cakmacbum/bas-ncl-kap/24.09.2026.md

# 24.09.2026 — Çok elemanlı kap doğrulama devamı

## Tamamlananlar

- Önceki dört iş paketi korunarak mevcut çalışma ağacı gözden geçirildi.
- Beş bileşenli proje API kaydet/aç turu, UI listele/yükle bağlantısı, iki malzeme/iki kaynak fixture'ı, CAD kapsam kapısı ve Faz E kalıcılık/rapor kontrolleri doğrulandı.
- Golden-case regresyonu, F&D standart varsayımının taç/büküm yarıçapını dış çaptan türetmesiyle hizalandı. 20 mm nominal etli ve 1000 mm iç çaplı test girdisinde beklenen büküm yarıçapı 62.4 mm'dir.
- `Junction.cone_end` alanı arayüz TypeScript tip sözleşmesine eklendi.
- Tam Python paketi: **679 geçti, 1 atlandı**. Atlanan test isteğe bağlı WeasyPrint PDF testidir.
- Web üretim derlemesi başarılı; son tip sözleşmesi düzenlemesinden sonra `tsc -b` de başarılı.
- `git diff --check` temiz.

## Kapsam sınırları

- WeasyPrint bulunmadığından PDF çıktısı testi bu ortamda çalışmadı.
- Koni birleşimlerinde doğrulama ve kapsam kapısı vardır; birleşim hesap çözücüsü desteklenmeyen durumları sayısal sonuç olarak üretmez.
- Kesin CAD yalnızca desteklenen dar zincir geometrisini işler; beş bileşenli zincir `OUT_OF_SCOPE` olarak kalır.
- Çalışma ağacındaki değişiklikler commit edilmedi; hiçbir değişiklik geri alınmadı.
