cakmacbum/bas-ncl-kap/.project-ai/FUTURE.md

# FUTURE (Scope Guard — NOT NOW)
- Bombe nozulları, eğik/ofset nozul, koni, çoklu gövde, destek tanıma
- STL'den ölçü çıkarma / yüklenen STL ile suite modelini üst üste karşılaştırma (sapma haritası)
- IGES desteği
- Kalıcı tanıma worker havuzu (+5 s import gecikmesini kaldırır)
- B-36: vessel_builder'da gerçek küre+torus torisferik profil
- Global 500 işleyicisinde ayrıntı gizleme
- EN 13445 flanş, yorulma, yük kombinasyonu (D5 sonrası) · CFD (OpenFOAM, sunucu maliyeti) · rüzgâr/deprem (Dalga 5) · P14 3D CalculiX (ertelendi)
