cakmacbum/bas-ncl-kap/.project-ai/paketler/U02-yerlesim-kabugu.RAPOR.md

# RAPOR U02-yerlesim-kabugu

> Yürütücü: Codex gpt-6-luna·medium (yaz) · 2026-10-29 15:34
> Worktree: /c/Users/yusuf/.orkestra-wt/BASINCLI-KAP/U02 · Dal: ork/U02 · Taban: f95b608

U02 Adım 03 yerleşim kabuğu — KISMİ  
Dosyalar: `src/pages.tsx`, `src/theme.css` · Test: `npm.cmd test` → vitest bulunamadı; `npm.cmd run build` → tsc bulunamadı  
Sözleşme: uyuldu · Commit atılmadı  
Izgara: 480 px; 1000–1199 px aralığında 420 px; 769–999 px aralığında 360 px; ≤768 px tek sütun ve sticky önizleme.  
Geometri ve Hesap girdileri sekmeleri eklendi; sekme tercihi `localStorage`'a hata yakalamalı biçimde kaydediliyor.  
Taşınan akordeonlar: Nozul ayrıntıları, Flanşlar (Appendix 2), Destek ayrıntıları, Malzeme, Kaynak & NDT.  
Açıklar: Yerleşim içindeki aktar menüsü/uyarı rozeti ve mobil kamera ikonları tamamlanmadı; test/build bağımlılıkları kurulu olmadığından derleme doğrulanamadı.
```
 pressure-vessel-suite/apps/web-ui/src/pages.tsx | 16 ++++++
 pressure-vessel-suite/apps/web-ui/src/theme.css | 67 +++++++++++--------------
 2 files changed, 44 insertions(+), 39 deletions(-)
```
