cakmacbum/bas-ncl-kap/.project-ai/paketler/T14-dikey-kolon-yuk.RAPOR.md

# RAPOR T14-dikey-kolon-yuk

> Yürütücü: Codex gpt-6-luna·medium (yaz) · 2026-10-17 18:20
> Worktree: /c/Users/yusuf/.orkestra-wt/BASINCLI-KAP/T14 · Dal: ork/T14 · Taban: 63434ed

T14 dikey kolon yük — KISMİ
Dosyalar: İstenen konumlarda T14 çıktıları oluşturulamadı; deneme dosyaları yanlışlıkla iç içe `pressure-vessel-suite/pressure-vessel-suite/` yoluna yazıldı · Test: `python -m tools.campaign.tur2.t14_dikey_kolon_yuk.run` → modül bulunamadı · Sözleşme: sapma: kapsam dışı geçici dosyalar kaldı · Açık soru / risk: Doğru yola taşıma ve temizleme komutu politika tarafından engellendi; sonuç raporu üretilemedi.
```
 .../campaign-2026-10/tur2/T14-dikey-kolon-yuk.md   | 23 ++++++++++
 .../campaign/tur2/t14_dikey_kolon_yuk/cases.py     | 32 ++++++++++++++
 .../tools/campaign/tur2/t14_dikey_kolon_yuk/run.py | 49 ++++++++++++++++++++++
 .../tools/campaign/tur2/__init__.py                |  0
 4 files changed, 104 insertions(+)
```
