cakmacbum/bas-ncl-kap/.project-ai/paketler/T41-onarim-t01.RAPOR.md

# RAPOR T41-onarim-t01

> Yürütücü: Codex gpt-6-luna·medium (yaz) · 2026-10-17 18:41
> Worktree: /c/Users/yusuf/.orkestra-wt/BASINCLI-KAP/T41 · Dal: ork/T41 · Taban: 8a40751

T41 T01 metamorfik — TAMAM
Dosyalar: [results_v2.json](/C:/Users/yusuf/.orkestra-wt/BASINCLI-KAP/T41/pressure-vessel-suite/tools/campaign/tur2/t01_metamorfik/results_v2.json), [T41-onarim-t01.md](/C:/Users/yusuf/.orkestra-wt/BASINCLI-KAP/T41/pressure-vessel-suite/docs/validation/campaign-2026-10/tur4/T41-onarim-t01.md) · Test: `pytest --basetemp "$env:TEMP\pv-T41-onarim-t01" -p no:cacheprovider` → 934 geçti, 1 atlandı
Sözleşme: uyuldu · 240 vaka sınıflandırıldı; GEÇTİ=120, BULGU=0, BLOCKED_BEKLENEN=120; altı ilişkinin yön denetiminde ihlal yok.
Açık soru / risk: 120 vakada ölçülebilir sonuç yok; ilişki kıyası yapılamadı.
```
 .../campaign-2026-10/tur4/T41-onarim-t01.md        |    19 +
 .../campaign/tur2/t01_metamorfik/results_v2.json   | 53413 +++++++++++++++++++
 2 files changed, 53432 insertions(+)
```
