cakmacbum/bas-ncl-kap/.project-ai/paketler/T40-onarim-agregasyon.RAPOR.md

# RAPOR T40-onarim-agregasyon

> Yürütücü: Codex gpt-6-luna·medium (yaz) · 2026-10-17 18:29
> Worktree: /c/Users/yusuf/.orkestra-wt/BASINCLI-KAP/T40 · Dal: ork/T40 · Taban: eb9fc3f

T40 onarım agregasyon — KISMİ  
Dosyalar: [T40-onarim-agregasyon.md](/C:/Users/yusuf/.orkestra-wt/BASINCLI-KAP/T40/pressure-vessel-suite/docs/validation/campaign-2026-10/tur4/T40-onarim-agregasyon.md) · Test: dört `python -m tools.campaign.tur3.mega_*.run` koşusu → modüller worktree’de bulunmadığından çalıştırılamadı · Sözleşme: uyuldu · Açık soru / risk: `results.json` kaynakları yok; dağılım ve kontrol örnekleri hesaplanamadı.
```
 .../validation/campaign-2026-10/tur4/T40-onarim-agregasyon.md    | 9 +++++++++
 1 file changed, 9 insertions(+)
```
