cakmacbum/bas-ncl-kap/.project-ai/paketler/V01-teyit-govde_ug27.RAPOR.md

# RAPOR V01-teyit-govde_ug27

> Yürütücü: Codex gpt-6-luna·medium (yaz) · 2026-10-17 18:10
> Worktree: /c/Users/yusuf/.orkestra-wt/BASINCLI-KAP/V01 · Dal: ork/V01 · Taban: fe21b34

V01 f01_govde_ug27 — TAMAM
Dosyalar: [V01-f01_govde_ug27.md](/C:/Users/yusuf/.orkestra-wt/BASINCLI-KAP/V01/pressure-vessel-suite/docs/validation/campaign-2026-10/teyit/V01-f01_govde_ug27.md) · Test: bağımsız Python aritmetik kontrolü → tamam · Sözleşme: uyuldu · Açık soru / risk: yok
```
 .../campaign-2026-10/teyit/V01-f01_govde_ug27.md   | 35 ++++++++++++++++++++++
 1 file changed, 35 insertions(+)
```
