cakmacbum/bas-ncl-kap/.project-ai/paketler/V02-teyit-bombe_eliptik.RAPOR.md

# RAPOR V02-teyit-bombe_eliptik

> Yürütücü: Codex gpt-6-luna·medium (yaz) · 2026-10-17 18:05
> Worktree: /c/Users/yusuf/.orkestra-wt/BASINCLI-KAP/V02 · Dal: ork/V02 · Taban: 2012cb4

V02 f02_bombe_eliptik — TAMAM  
Dosyalar: [V02-f02_bombe_eliptik.md](/C:/Users/yusuf/.orkestra-wt/BASINCLI-KAP/V02/pressure-vessel-suite/docs/validation/campaign-2026-10/teyit/V02-f02_bombe_eliptik.md) · Test: çalıştırılmadı → belge ve kod satırları incelendi · Sözleşme: uyuldu · Açık soru / risk: Suite ve oracle arasındaki sayısal fark, yalnız korozyonlu çap etkisiyle tam açıklanmıyor; raporda bu belirsizlik belirtildi.
```
 .../teyit/V02-f02_bombe_eliptik.md                 | 25 ++++++++++++++++++++++
 1 file changed, 25 insertions(+)
```
