cakmacbum/bas-ncl-kap/.project-ai/paketler/V04-teyit-bombe_yarimkure.RAPOR.md

# RAPOR V04-teyit-bombe_yarimkure

> Yürütücü: Codex gpt-6-luna·medium (yaz) · 2026-10-17 18:05
> Worktree: /c/Users/yusuf/.orkestra-wt/BASINCLI-KAP/V04 · Dal: ork/V04 · Taban: 2012cb4

V04 f04_bombe_yarimkure — KISMİ
Dosyalar: [V04-f04_bombe_yarimkure.md](/C:/Users/yusuf/.orkestra-wt/BASINCLI-KAP/V04/pressure-vessel-suite/docs/validation/campaign-2026-10/teyit/V04-f04_bombe_yarimkure.md) · Test: el hesabı → 2 temsilci hesaplandı; test komutu yok
Sözleşme: uyuldu · Açık soru / risk: Dosyadaki grup tablosu ile sonuç özeti çelişiyor; düzeltilmeli.
```
 .../teyit/V04-f04_bombe_yarimkure.md               | 33 ++++++++++++++++++++++
 1 file changed, 33 insertions(+)
```
