cakmacbum/bas-ncl-kap/.project-ai/paketler/V05-teyit-duz_kapak_ug34.RAPOR.md

# RAPOR V05-teyit-duz_kapak_ug34

> Yürütücü: Codex gpt-6-luna·medium (yaz) · 2026-10-17 18:05
> Worktree: /c/Users/yusuf/.orkestra-wt/BASINCLI-KAP/V05 · Dal: ork/V05 · Taban: 2012cb4

V05 düz kapak UG-34 — KISMİ  
Dosyalar: [V05-f05_duz_kapak_ug34.md](/C:/Users/yusuf/.orkestra-wt/BASINCLI-KAP/V05/pressure-vessel-suite/docs/validation/campaign-2026-10/teyit/V05-f05_duz_kapak_ug34.md) · Test: yok (yalnız rapor ve elle hesap) → çalıştırılmadı · Sözleşme: uyuldu · Açık soru / risk: Suite kaynak kanıtı görülen Head dalıyla sınırlı; kampanya girdilerinin o dala eşlemesi doğrulanamadı. Rapor içinde bu kanıt sınırı belirtildi.
```
 .../teyit/V05-f05_duz_kapak_ug34.md                | 31 ++++++++++++++++++++++
 1 file changed, 31 insertions(+)
```
