cakmacbum/bas-ncl-kap/30.09.2026-notlar.md

# 30.09.2026 — Kaldığımız yer

## Güncel durum (30.09 kontrolü)

- **Testler:** 867 passed / 1 skipped (atlanan: WeasyPrint PDF). `tsc --noEmit` 0 hata, kullanılmayan TS öğesi 0, `npm run build` başarılı.
- **26.09'dan beri kodda değişiklik yok.** Son iş 26.09'daki destek denetimi ve ayak sistemiydi.
- **Commit yok:** son commit `6b0f7b6` (24.09, geometri ajanı). O günden beri yapılan her şey çalışma ağacında duruyor. 35 değiştirilmiş dosya ve 9 yeni dosya var. Yeni dosyaların önemlileri:
  - `packages/supports/src/supports/leg_detail.py`
  - `tests/faz5/test_leg_detail.py`, `test_saddle_zick.py`, `test_skirt_buckling.py`, `test_support_orchestration.py`, `test_flange_production_wiring.py`
  - `tests/faz_e/test_faz_e_release_gate.py`
  - `docs/validation/2026-09-26-20-tank-basinc-ayak-karsilastirmasi.md`, `test-sonuc.1.md`

  Bunlar kaybolmasın diye **ilk iş checkpoint commit** atmak.
- **Kayıtlar:** `docs/limitations.md` (Revizyon 3.5, B-26…B-38) ve vault (`basincli-kap-denetim-dogrulama`) güncel.

## 22–26.09 arasında yapılanlar (özet)

### Emniyet düzeltmeleri (hepsi testli)
| Kod | Konu |
|---|---|
| B-26 | Mill toleransı korozyon payına uygulanmıyordu |
| B-27 | Ayak kesiti dolu daire kabul ediliyordu |
| B-28 | Hidrotest/pnömatik test basıncı LSR=1 ile düşük çıkıyordu → malzemeye "Test sıcaklığında S" alanı |
| B-29 | WRC'de eksik katsayı sıfır sayılıyordu |
| B-30 | Eğik nozulda sahte GEÇTİ → İNCELEME GEREKLİ |
| B-31 | Malzeme S sıcaklığı / kalınlık aralığı kontrol edilmiyordu |
| B-32 | Ayak reaksiyonunda moment terimi yarıydı → `2M/(n·r)` |
| B-33 | Taban plakası alanı ayak çelik gerilmesini düşürüyordu |
| B-34 | Etek/ayak arayüzden hesaplanamıyordu (host bombe sorunu) |
| B-35 | Alternatif yük durumları toplanıyordu → zarf |
| B-36 | Destek ağırlığında hidrotest (su) yoktu |
| B-37 | Etek burkulma kontrolü yoktu → B faktörü kullanıcı girdisi |
| B-38 | Eyer formülleri Zick değildi → Zick yapısı, K katsayıları kullanıcı girdisi |

### Yeni özellikler
- **Flanş (Appendix 2) uçtan uca:** Y, f, F, V, T, U, W, M, g1 kullanıcı girdisi. Gerilme formülleri standart forma düzeltildi. Sonuç İNCELEME GEREKLİ (rijitlik, cıvata alanı kontrolleri yok).
- **Ayak sistemi:** boru/U/kutu/köşebent kesit + AISC burkulma, ped, taban plakası, üç köşe kaynağı, WRC lokal gerilme. Dört ayrı sonuç ve arayüz formu (WRC tablosu, boş ile 0 ayrımı). Özet sonuç nihai GEÇTİ vermez.
- **Yayın kapısı:** `CalculationResult.notices`; `validate_suite` API yanıtında `verification` olarak (arayüzde henüz gösterilmiyor).
- **Arayüz:** siyah/beyaz keskin tema, Inter + JetBrains Mono.
- **Dokümanlar:** `calculation-coverage.md` dört etiketle yeniden yazıldı.

## Açık kararlar (Yusuf)

1. **MAWP farkı** (`test-sonuc.1.md`, 20 tank): program MAWP'si dış hesaptan %18–77 yüksek.
   - Bombe MAWP'si şekillendirme incelmesini (1 mm) düşmüyor. Bu gerçek tutarsızlık; düzeltme onayı bekliyor.
   - Dış hesap %12,5 sac toleransını MAWP'ye uyguluyor. Levha için (tipik 0,25 mm) fazla temkinli olabilir. Karar: MAWP en kötü tolerans kalınlığıyla mı hesaplansın?
2. **Ayak ped temas oranı yorumu:** şu an "kaynaklanabilen kontur oranı" olarak ele alınıyor. Mühendis onayı gerekiyor.
3. **Repodaki STL dosyaları:** `deneme-tasarimi.stl` ve `../pressure_vessel_u_profile_legs_concept_mm.stl`. Silinsin mi, git dışına mı alınsın?

## Yapılacaklar (öncelik sırasıyla)

1. **Checkpoint commit.** Tüm çalışma ağacı dört gündür commit edilmedi.
2. **Backend'i yeniden başlat.** 8000'deki backend eski kodla ve `.env`'siz çalışıyor, bu yüzden yeni ayak kontrolleri ve geometri ajanı görünmüyor:
   ```
   python -m uvicorn apps.api.main:app --reload --env-file .env
   ```
   Frontend: `pressure-vessel-suite\apps\web-ui` klasöründe `npm run dev` (kökten çalışmaz).
3. **MAWP bombe incelmesi düzeltmesi** (karar 1 sonrası).
4. **Doğrulanamayanları kaynakla kontrol et** (Moss PVDM veya Megyesy çözümlü örnek):
   - eyer S3/S5 formülleri ve K1' (basma tarafı) ayrımı
   - etek 0,6 kaynak verimi ve UG-23(b) Ro/t – ortalama R/t seçimi
   - Blodgett kaynak grubu Sw ifadeleri (türetmeyle doğrulandı)
   - WRC boyut analizi (bültenle karşılaştırılmadı)
5. **Yük eşleşmesi:** hidrotest ağırlığı rüzgâr momentiyle aynı hesapta (muhafazakâr); gerçek yük durumu eşleştirmesi yok.
6. **Test gerilmesinin bileşen bazında sınır kontrolü** (UG-99(b)) yok.
7. **Arayüzde `verification` gösterimi:** `test_ui_parity` kaydı ya da görüntü eklenmeli.
8. **EN 13445:** hiçbir yayınlanmış vakayla karşılaştırılmadı; B-31 malzeme kapısı EN'de uygulanmıyor.
9. **Küçük eksikler:** `anchor_bolt_diameter_mm` hesapta kullanılmıyor; boş tank ayak gerilmesi ayrı sonuç olarak üretilmiyor.

## Kapsam dışı (bilinçli)

- **Eğik nozul yöntemi:** lisanslı UG-37 metni yok, İNCELEME GEREKLİ kalıyor.
- **Diğer:** rüzgâr/deprem kod yüklemesi, relief sizing, yorulma, gerçek FEA çözücü, PED/CE süreci, loose flanş, flanş rijitliği (2-14).

## Güvenlik notu

- OpenRouter anahtarı sohbette göründü, **yenilenmeli**.
- Anahtar yalnız `pressure-vessel-suite/.env` dosyasında duruyor; dosya git'te görünmüyor (gizli).
- Ücretsiz modeller (`google/gemma-4-31b-it:free`) yoğunluktan 429 veriyor. Sorun sürerse ücretli, ucuz bir model seç.
