cakmacbum/bas-ncl-kap/24.09.2026-muhendislik-hesap-karsilastirmasi.md

# 24.09.2026 — Mühendislik hesap kapsamı ve rakip kıyası

**İncelenen revizyon:** `feaccd2` — *Implement pressure vessel suite phases and validation*  
**İnceleme türü:** Kod yolu, girdiler, sonuç durumları, test kanıtı ve üretici/otorite dokümanları üzerinden masa başı mühendislik incelemesi.  
**Sınır:** Lisanslı ASME BPVC ve EN 13445 tam metinleri bu incelemede madde madde doğrulanmadı. Bu rapor uygunluk sertifikası veya bağımsız mühendis onayı değildir. Yazılım testleri formülün doğru standardı temsil ettiğini tek başına kanıtlamaz.

## Yönetici özeti

Kod tabanında doğru yönde önemli altyapı var: açık ASME/EN motor seçimi, temel gövde/bombe basınç formülleri, izlenebilir ara değerler, bileşen dizisi, statü kapıları ve hesap kayıt altyapısı. Son tam test turunda **679 test geçti, isteğe bağlı 1 PDF testi atlandı**. Bu, yazılım davranışının regresyon kontrolüdür; PV Elite/COMPRESS düzeyinde mühendislik eşdeğerliği anlamına gelmez.

Ürün bugün **ASME VIII-1 için dar kapsamlı ön boyutlandırma ve kod geliştirme prototipi** olarak değerlendirilmeli. İmalata esas tasarım, hidro/pnömatik test basıncı, eğik/büyük nozul, flanş, dış basınç, rüzgâr/deprem destek tasarımı ve PED/CE kararı için tek başına kullanıma hazır değil.

## Bulgular ve öncelik

| Öncelik | Alan | Mevcut gerçek davranış | Mühendislik riski / gereken iş |
|---|---|---|---|
| **P0** | Hidrostatik ve pnömatik test | ASME kodu `S_test = S_design` atıyor; test basıncını bu oranla hesaplayıp doğrudan `PASS` veriyor. Test sıcaklığındaki malzeme gerilmesi okunmuyor; basınç taşıyan bütün parçaların test gerilmesi ayrı ayrı kontrol edilmiyor. | Gerçek `S_test/S_design` oranı 1’den büyükse önerilen test basıncı gerekenden düşük kalabilir. “Konservatif” varsayım güvenli yönde olduğu kanıtlanmış değil. Test sıcaklığı verisi yoksa sonuç bloklanmalı veya inceleme gerektirmeli; her bileşen için test koşulu/stres kontrolü eklenmeli. Kanıt: `code-asme-viii-1/.../design_code.py`, `calculate_hydrotest_pressure` ve `calculate_pneumatic_test_pressure`.
| **P0** | Malzeme özelliklerinin geçerliliği | API’de malzeme kaydı varlığı kontrol ediliyor; ancak sıcaklık ve kalınlık aralığı, ürün formu ve kod sürümüne göre değer uygunluğu hesap öncesi doğrulanmıyor. Hesap motorları tek `allowable_stress` değerini kullanıyor. Yeni `MaterialDataPack`/sıcaklık interpolasyonu hesap motoruna bağlı değil. | Hatalı/eski veya tasarım sıcaklığına uymayan elle girilmiş izin verilebilir gerilme ile sayısal `PASS` oluşabilir. Kod ve malzeme baskısı, sıcaklık, ürün formu, kalınlık, kaynak durumu ve veri kaynağı birlikte doğrulanmalı; dışa taşma engellenmeli.
| **P1** | Nozul takviyesi | ASME UG-37/UG-40 alan yerine koyma hesabı üretim hattında çalışıyor; fakat dar alanda. Eğik girişe izin verilip basit `1/cos(angle)` izdüşümü kullanılıyor ve sonuç `PASS` olabiliyor. UG-45’in yalnız basitleştirilmiş (a) kontrolü var; standart boru çizelgesi, büyük açıklık, hillside/chord ve yük birleşimleri tam değil. Üretilen sonuçta kod/baskı sabit `ASME VIII-1 / 2025`. | Eğik nozul sonucu doğrulanmış UG-37 geometri faktörü ve takviye düzlemleri olmadan final gibi görünebilir. Sıfırdan farklı açılar için tam yöntem yoksa blokla/incelemeye düşür; edition ve kaynak izini seçilen motordan taşı. Büyük açıklık, yakın açıklık etkileşimi, harici kuvvet-moment, UG-45(b), kaynak boyut/dayanımı ve nozzle MAWP tamamlanmalı.
| **P1** | Dış basınç / vakum | A/B faktörleri kullanıcı tarafından çizelgeden giriliyor. Silindir ve bombe hesapları yaklaşık; olumlu sonuçlar `REVIEW_REQUIRED`, nihai `PASS` değil. Bombe yolu geometri türlerini tam ayırmıyor; halka rijitleştirici hesabı tamamlanmış kod yöntemi değil. | Durum kapısı yanlış güveni azaltıyor; fakat tasarım değeri üretmiyor. Sürümlü çizelge verisi, geometriye özgü UG-28/UG-33, limit kontrolleri, rijitleştirici aralığı/ataleti, iteratif minimum kalınlık/MAWP ve bağımsız örnek karşılaştırması gerekli.
| **P1** | Flanş / conta / cıvata | ASME flanş çağrısı orkestratörde var; fakat üretim payload’ı `flange_factor_Y`, bolt load ve moment göndermiyor. Domain/UI’da Y/f tablosu girdisi yok. Y eksik olduğundan gerçek proje hattı `BLOCKED_MISSING_INPUT` döner; doğrudan paket testleri bu üretim engelini kapatmıyor. | Şu an flanş hesap kabiliyeti var diye sunulmamalı. Appendix 2 girdileri, conta ve cıvata seçimi, operating/seating yükleri, pressure-moment hesabı ve B16.5/B16.47 basınç sınıfı ayrı rotalarla tamamlanmalı; gerçek UI→API→rapor entegrasyon testi eklenmeli.
| **P1** | Rüzgâr / deprem / global yükler | `global_loads.py` eşdeğer statik rüzgâr ve deprem yardımcıları sağlar; belgede kendisi de tam ASCE/EN/TBDY uygunluğu olmadığını söylüyor. Fonksiyonlar tasarım yük kombinasyonlarına ve destek analizine otomatik bağlı değil. `load_engine` girilmiş altı bileşenli yükleri topluyor; rüzgâr/deprem kod katsayısı uygulamıyor ve kombinasyonları yalnız `REVIEW_REQUIRED` zarfı olarak veriyor. | Hız/bölge faktörü girişi tek başına tasarım kuvveti üretmiyor. Rüzgâr maruziyeti/rafal, yükseklik profili, yerel yapı kodu, deprem spektrumu/zemin, ağırlık ve çalışma senaryoları, eşzamanlılık ve yöneten her bileşen kontrolü bağlanmalı. Şimdiki arayüz yük sonuçları nihai destek tasarımı değildir.
| **P1** | Destekler | Eyer/etek/ayak formülleri ve üretim hattı var. Hesaplanan destek ağırlığı yalnızca kap metal kütlesinden geliyor; sıvı, izolasyon, platform ve iç ekipman ağırlıkları dahil değil. Dış yükler tam standart yük zarfına dönüşmüyor. Olumlu basit destek sonuçları `REVIEW_REQUIRED`’a çevriliyor. | Mevcut statü güvenli; ancak Zick/AISC/ankraj/temel/yerel kabuk/transport/lifting kapsamı tamamlanmış değil. Her destek için gerçek koordinat, reaksiyon, tüm yük durumları ve taban/ankraj/beton kontrolleri gerekir.
| **P1** | WRC-107/537 yerel gerilme | WRC paketi izole yardımcıdır; ASME nozul yükü hattına bağlı görünmüyor. Katsayılar kullanıcıdan isteniyor; desteklenen yük anahtarları sınırlı (`P`, `ML`, `MC`). Bir nokta için katsayı grubunda en az bir değer girildiyse diğer eksik katsayılar sıfır katkı sayılabiliyor. | Eksik katsayılar gerçek sıfır ile karışabilir ve gerilmeyi eksik tahmin edebilir. Yük bileşenleri/koordinat dönüşümü, her katsayının kaynak ve revizyonu, geçerlilik alanı, eksik katsayı blokajı ve VIII-1/VIII-2 kabul kriteri bağımsız doğrulanmalı.
| **P1** | Basınç tahliye | Mevcut paket ayar basıncını MAWP ile, birikmeyi girilmiş limit ile kıyaslıyor; kapasite alanının varlığını kontrol ediyor, kapasite boyutlandırmıyor. Tahliye sistemi yok/kapalıysa `OUT_OF_SCOPE`. `device_type` ile `set_pressure`/`burst_pressure` alanı eşleştirilmiyor. | Bu, UG-125–136 için tam relief sizing veya senaryo analizi değil. Relief senaryoları, gerekli kapasite, sertifikalı kapasite kıyası, birden çok cihaz, blowdown ve cihaz türü doğrulaması eklenmeli. Sistem tanımlanmamasının tasarım bazında incelenmesi gerektiği raporda belirgin olmalı.
| **P1** | EN 13445 | EN motoru açıkça seçiliyor ve ASME’ye sessiz dönüş yok. Gövde/bombe kalınlık, MAWP ve test basıncı rotaları var. EN nozul, dış basınç, yük birleşimi, flanş ve yorulma yöntemleri `NOT_CALCULATED`/`OUT_OF_SCOPE` olarak bırakılmış. | EN seçeneği “tam EN tasarımı” anlamına gelmiyor. Her modül için EN 13445 bölümü, edition, malzeme paketi ve doğrulanmış örnek bağlanmalı. Bugünkü davranışın bloklayıcı olması iyi; ürün kapsamı olarak açıkça dar gösterilmeli.
| **P1** | PED / CE | Sınıflandırma, ESR matrisi ve belge çıktıları için paketler var; rapora belirli PED verileri ve hacim bağlanıyor. | Yazılım kategori/şablon üretimi tek başına PED uygunluğu veya CE kararı değildir. Komisyon’un yayımladığı harmonize standart listesi güncel takip edilmeli; üretici risk analizi, uygulanabilir tüm ESR’ler, uygunluk değerlendirme modülü ve gerekiyorsa onaylanmış kuruluş süreci gerçek proje kanıtlarıyla kapatılmalı.
| **P2** | Yorulma / yüksek sıcaklık / VIII-2 FEA | EN/ASME fatigue yöntemleri yok veya girdide bloklanıyor. FEA adaptörü solver çalıştırmıyor; mesh, gerilme doğrusalizasyonu ve kod kabulü `NOT_EVALUATED` ara değerleriyle açıkça iskelet. | Ticari alternatiflerin Division 2, fatigue screening, nozul/klips FEA ve gelişmiş tasarım işlevleriyle farkı büyük. Bu alanlar “destekleniyor” değil, “sonraki faz/iskelet” olarak gösterilmeli.

## Rakiplerle kabiliyet farkı

Üretici sayfaları kendi ürünlerinin kabiliyet iddialarıdır; bağımsız doğruluk denetimi yerine geçmez. Yine de ürün kapsamını kıyaslamak için şunları söylüyorlar:

| Hesap/ürün alanı | Bu projedeki durum | PV Elite / COMPRESS belgelerinde belirtilen örnekler |
|---|---|---|
| Tasarım/rating ve bileşen ailesi | ASME iç basınç çekirdeği en olgun bölüm; EN ayrı ama sınırlı. | PV Elite VIII-1/EN/PD tasarım yüzeyi ve bileşen analizleri; COMPRESS ayrıca design/rating, VIII-2 Class 1/2, stacked ve multi-chamber kapları listeliyor. |
| Dış basınç ve koniler | A/B elle giriliyor, yaklaşık sonuç; koni geçişlerinin yeterlilik hesabı yok. | PV Elite koni uçlarını, rijitleştirici yakınlığını ve farklı basınç koşullarını değerlendiriyor; dış basınç için kod rotaları sunuyor. |
| Nozullar ve boru yükleri | Dar radyal area-replacement; tam WRC/FEA ve harici nozul yükü hattı yok. | PV Elite nozul yönleri, büyük açıklık/UG-45 ve yerel WRC yöntemlerini listeliyor; COMPRESS hillside chord, WRC-537 çoklu yük durumları ve FEA’yı belirtiyor. |
| Rüzgâr/deprem/destek | Eşdeğer statik yardımcılar ve manuel yük toplamı; tam kod yüklendirmesi/combination yok. | PV Elite bina kodlarından rüzgâr/deprem yükü üretimi ve load-case kombinasyonlarını açıklıyor; COMPRESS foundation loads, ağırlık, wind/seismic/vortex ve destek paketlerini listeliyor. |
| Flanş / relief / test | Flanş üretim hattı Y girdisinde bloke; relief kapasite boyutlandırmıyor; test basıncı malzeme oranını gerçek sıcaklıkta çözmüyor. | COMPRESS Appendix 2, B16 flanş/conta, hidrotest ve rapor işlevlerini listeliyor; bu kıyas kapsam farkını gösterir, formül doğruluğu kıyası değildir. |
| FEA / fatigue / belgeler | FEA iskeleti; fatigue kapsamı yok; PED dokümanları şablon seviyesinde. | COMPRESS FEA/fatigue/Div.2, BOM ve üretici raporları; PV Elite rapor üretimi ve yerel gerilme araçları sunuyor. |

## Kaynak ve uygunluk çerçevesi

- [PV Elite 28 resmi yardım ana sayfası](https://docs.hexagonppm.com/r/en-US/PV-Elite-Help/Version-28/990005): kod seçenekleri, tasarım ayarları ve yük durumları.
- [PV Elite opsiyonel analiz adımları](https://docs.hexagonppm.com/r/en-US/PV-Elite-Help/Version-28/304625): koni, Zick, AISC destek ve nozul analizlerinin kapsam örnekleri.
- [PV Elite yük kombinasyonları](https://docs.hexagonppm.com/r/en-US/PV-Elite-Help/Version-27/319121): internal/external pressure, hydrotest, wind ve seismic kombinasyonları.
- [COMPRESS kabiliyetleri](https://www.codeware.com/products/compress/compress-benefits/): üreticinin ASME VIII, VIII-2, yükler, WRC, destekler ve raporlama için belirttiği işlevler.
- [COMPRESS nozullar ve WRC](https://www.codeware.com/products/compress/nozzles/): üreticinin hillside, UG-45, weld sizing, WRC-537 ve FEA kapsamı.
- [ASME BPVC 2025](https://www.asme.org/codes-standards/bpvc-standards/bpvc-2025): Section VIII’in basınç iç/dış tasarımı, imalat, muayene ve sertifikasyon çerçevesi.
- [Avrupa Komisyonu — PED harmonize standartları](https://single-market-economy.ec.europa.eu/single-market/goods/european-standards/harmonised-standards/pressure-equipment_en): PED için OJ’de yayımlanan standart referansları ve 2026 güncelleme duyurusu.
- [PED 2014/68/EU](https://eur-lex.europa.eu/legal-content/EN/TXT/?uri=CELEX:32014L0068): Ek I uygulanabilir tehlikeler için üretici risk analizini ve zorunlu ESR’leri şart koşar.

## Önerilen mühendislik çalışma sırası

1. **P0 sonuç güvenliği:** test basıncı ve malzeme sıcaklık özellikleri; hatalı girdilerden `PASS` çıkmasını engelle.
2. **Nozul ve flanş hattı:** açı/büyük açıklık kapsamını sınırla; gerçek girdileri UI’dan sonuç ve rapora kadar bağla; kod/baskı izini düzelt.
3. **Kod verisi:** ASME/EN malzeme ve external-pressure çizelgelerini lisanslı/veri kaynağı belli, baskısı ve checksum’ı kayıtlı paketlere bağla.
4. **Yükler ve destekler:** wind/seismic/weight/liquid/test/transport/lifting’i uygulanabilir standartla üret; kombinasyon başına her gerilme ve stabilite limitini değerlendir.
5. **WRC, relief, fatigue ve FEA:** eksik katsayı/girdi blokajı, kapasite hesabı, döngü hasarı ve sayısal solver kabulünü ayrı ayrı doğrula.
6. **Bağımsız V&V:** her modül için implementasyonu yazandan bağımsız mühendis hesabı, normal/sınır/başarısız/ünit dönüşümü golden case’leri ve PV Elite/COMPRESS fark dökümü; ardından yetkin mühendis onayı.
7. **Kapsam etiketleri:** `calculation-coverage.md` tablosunu her satır için “hesaplandı ve doğrulandı / ön kontrol / bloklu / yok” olarak güncelle. Bugünkü “Yes” etiketleri bazı paketleri üretimde kullanılabilir gibi olduğundan geniş gösteriyor.

**Güvenli kullanım sonucu:** Mevcut kod, mühendis incelemeli prototip/ön boyutlandırma için değerlendirilebilir. Bu incelemeye göre imalat onayı, resmi ASME VIII-1/EN 13445 tasarım raporu veya PED/CE kararı üretme seviyesinde değil.
