cakmacbum/bas-ncl-kap/20.09.2026-son-eksikler.md

# 20 Eylül 2026 — Son Durum: Kalan Eksikler

> Bu dosya `eksikler.md` (ilk kıyas raporu) ve `ana-notlar.md` (5 fazlı yol haritası)
> üzerine, **bugünkü çoklu-ajan kod turu bittikten sonra** canlı doğrulamayla (kod okuma +
> `pytest`/`tsc` çalıştırma + tarayıcıda gerçek UI testi) çıkarılmış güncel eksik listesidir.
> Kapatılan maddeler burada tekrar edilmez — yalnız **hâlâ açık olan** kalır.

**Taban doğrulama (22:36):** `pytest` 586 geçti / 1 atlandı · `tsc --noEmit` 0 hata ·
UI canlı test edildi (uvicorn + vite, gerçek form etkileşimi).

---

## 1. Doküman bayatlığı (kod değil, kayıt sorunu)

- **`docs/limitations.md` B-14 metni güncel değil.** Hâlâ *"UG-125…UG-136 hiç yok… yeni bir
  paket (`pressure-relief`) gerektirir"* diyor. Ama bugün bu paket **yazıldı, orkestratöre
  bağlandı ve UI'da tam form olarak doğrulandı** (etkinleştir, korunan MAWP, accumulation %,
  cihaz tipi, set/burst basıncı). Metnin "kapatıldı (basitleştirilmiş)" olarak güncellenmesi
  gerekiyor — B-15/16/17 gibi üstü çizili + not deseniyle.
- **`docs/limitations.md` dosya kodlaması bozuk.** Yeni eklenen "Phase C" başlığında
  em-dash `â€"` şeklinde mojibake görünüyor — dosya UTF-8 dışı bir encoding ile kaydedilmiş.
- **`tests/wiring/test_ui_parity.py`'deki `ARAYUZDE_YOK` listesi fazlalık kayıt taşıyor.**
  `Support.anchor_bolt_count`, `anchor_tension_allowable_N`, `anchor_shear_allowable_N`,
  `lateral_load_N` artık gerçekten UI'da var (canlı doğrulandı) ama hâlâ "ertelendi" diye
  kayıtlı. Test kırılmıyor (zararsız) ama liste yanlış bilgi taşıyor — temizlenmeli.

## 2. UI'da gerçekten eksik olan (canlı test ile doğrulandı)

- **Flanş (Appendix 2) — girdi formu hiç yok.** Sonuç grubu ve `ResultGroup` render
  oluyor ("Flanş tanımlanmadığı için Appendix 2 kontrolü yapılmadı"), ama kullanıcının bir
  `Flange` nesnesi tanımlayabileceği hiçbir form/buton yok. `Flange.flange_id`,
  `bolt_count`, `gasket_m/y`, `hub_length` vb. 10 alan `ARAYUZDE_YOK`'ta doğru gerekçeyle
  ("Flange domain UI deferred until complete Appendix 2 wiring") kayıtlı — bilinçli, dürüst
  ama fonksiyonel olarak eksik.
- **`Support.anchor_bolt_diameter_mm`** — tek başına hâlâ UI'da yok (diğer 4 ankraj alanı
  var). `ARAYUZDE_YOK`'ta doğru kayıtlı.

## 3. Bugün eklenen ama kapsamı kasıtlı sınırlı bırakılan (B-23/24/25 — yeni)

- **B-23 — Global yük motoru (`load_engine.py`) kod-spesifik stabilite kontrolü değil.**
  Altı bileşenli yükü tabana taşıyor, kombinasyon katsayılarını doğruluyor, governing zarf
  kaydediyor — ama sonuç her zaman `REVIEW_REQUIRED`, nihai `PASS` üretmiyor (bilinçli).
- **B-24 — Rüzgâr/deprem yalnız şeffaf ön-model.** `domain/global_loads.py` eşdeğer-statik
  basit model veriyor. Saha spektrumu, modal/torsional tepki, vortex shedding, baskıya özgü
  katsayılar **hiç yok**.
- **B-25 — Destek fiziği kısmi.** Ayak dağılım yarıçapı ve ankraj çekme/kesme talebi artık
  kayıt altında; ankraj verisi eksikse nihai `PASS` engelleniyor. Ama tam skirt buckling,
  base ring, beton basıncı, ayrıntılı Zick, kaldırma kulağı hesapları **hâlâ açık**.

## 4. Eski, hâlâ kapanmamış normatif boşluklar (`eksikler.md` B-02…B-19'dan kalanlar)

| Kod | Özet |
|---|---|
| B-02 | Eliptik bombede yalnız 2:1 oranı destekleniyor, genel elipsoid yok |
| B-03 | Dış çap alternatifleri (App. 1-1(a)(1), 1-4(c)) implement edilmemiş |
| B-04 | UG-34(c)(3) dairesel olmayan düz kapak / `Z` faktörü yok |
| B-06 | Torisferik taç yarıçapı varsayılanı iç çap — standart ASME F&D dış çap kullanır (~%0,5 emniyetsiz), hâlâ düzeltilmedi |
| B-07 | Nozul takviyesi yalnız radyal — eğik/hillside nozul gerçek `F` faktörü yok |
| B-08 | Appendix 1-7 büyük açıklık kontrolü yok |
| B-18 | UG-80/UG-81 imalat toleransları (yuvarlaklık, bombe biçimi) kontrol edilmiyor — düşük öncelik, bilinçli ertelendi |
| B-19 | UW-13 bombe-gövde bağlantı detayı ayrı doğrulanmıyor — düşük öncelik, bilinçli ertelendi |

## 5. Büyük yapısal eksikler (`ana-notlar.md` Faz B–E, henüz başlamamış/yarım kalan kalemler)

- **Sürümlü malzeme/kod veri paketi yok** — ASME II-D allowable stress, UCS-66 curve group,
  PWHT/impact kısıtları hâlâ manuel girdi; `packages/materials/data_pack.py` bugün eklendi
  ama kapsamı (öncelik sırası #4) tam doğrulanmadı.
- **Tam UG-28/UG-33 chart yöntemi yok** — A/B hâlâ serbest kullanıcı girdisi, malzeme/sıcaklık/
  Do-t-L bağıntılı chart lookup, extrapolation bloklaması, stiffening ring atalet/aralık hesabı
  eksik (B-21 yalnız formül katsayısını düzeltti, chart yöntemini tamamlamadı).
- **WRC 107/297/537 nozul dış yükü** — hiç yok.
- **EN 13445 kapsamı sığ** — motor artık seçilebiliyor (B-22 kapandı) ama EN shell/head golden
  case, EN dış basınç/nozzle/flange, EN fatigue, EN load combinations, PED/DoC/nameplate/
  technical-file akışı büyük ölçüde eksik.
- **V&V / verification manual yok** — applicability matrisi, bağımsız el hesabı, PV
  Elite/COMPRESS kör karşılaştırması, tolerans politikası, yetkin mühendis sign-off süreci,
  CI regression lock — hiçbiri kurulmadı.
- **Kalıcı ürün altyapısı yok** — transactional DB, immutable calculation run, RBAC,
  migration/backup, structured logging/monitoring; `run_store.py` bugün eklendi ama
  kapsamı sınırlı (Faz E henüz başlangıç aşamasında, `tests/faz_e/` yeni açıldı).
- **Raporlama** — PDF/Word garantili değil (WeasyPrint bağlı değil), deficiency list,
  review/approval akışı, ASME Data Report/PED technical file yok.
- **Şimdilik bilinçli ertelenen (proje kararı, eksik sayılmaz):** ASME VIII-2 Class 1/2,
  gerçek FEA/DBA, fatigue/creep-fatigue, UHX/TEMA eşanjör, jacket/multi-chamber, API 650/579,
  bellows, geniş uluslararası kod ailesi.

## 6. Öncelik sırası (ana-notlar.md ile tutarlı, güncellenmiş)

1. **Doküman senkronu** — B-14 metnini kapat, `ARAYUZDE_YOK` fazlalıklarını temizle, encoding düzelt (ucuz, hemen yapılabilir)
2. Flanş (Appendix 2) girdi formu — backend zaten hazır, yalnız UI eksik
3. Torisferik geometri (B-06) — emniyetsiz sapma hâlâ düzeltilmedi
4. Sürümlü malzeme/kod veri paketinin tamamlanması
5. Tam UG-28/33 chart yöntemi + stiffening ring
6. Eğik/büyük nozul (B-07/B-08), WRC dış yük
7. Global yük motorunun kod-spesifik stabilite kontrolüne bağlanması (B-23 → gerçek check)
8. EN 13445/PED tam kapsam
9. V&V, kalıcılık, raporlama (Faz E)

---

*Kaynak: bu oturumdaki bağımsız kod incelemesi + canlı `pytest`/`tsc` doğrulaması +
tarayıcıda gerçek UI etkileşim testi (uvicorn + vite, 20 Eylül 2026 22:15-22:36 arası).*

---

## Ek: Manuel doğrulama oturumu (kullanıcı ile canlı test)

**Girdi:** İç çap 1000mm, P=1.5MPa, S=138MPa, E=1.0, CA=0mm, nominal t=8mm.

- ✅ **MAWP** = 2.19 MPa — bağımsız hesap (UG-27(c)(1) ters çözüm): 2.1873 MPa → eşleşti.
- ✅ **Hidrostatik test** = 2.84 MPa — bağımsız hesap (UG-99(b): 1.3×MAWP×LSR): 2.843 MPa → eşleşti.
- ✅ **Pnömatik test** = 2.41 MPa — bağımsız hesap (UG-100: 1.1×MAWP×LSR): 2.406 MPa → eşleşti.
- ❓ **Gerekli kalınlık (SHELL-01, "Et Kalınlığı" tablosu)** — bağımsız hesap 5.47 mm (UG-27(c)(1)
  düz formül) bekleniyor, ama kullanıcı ekranda bu satırı/tabloyu **bulamadı/göremedi**.
  Doğrulanmadı — henüz eşleşme/uyuşmazlık tespit edilmedi, sadece görsel olarak
  bulunamadı. Sonraki oturumda ekran görüntüsüyle tekrar bakılacak.
