cakmacbum/bas-ncl-kap/21.09.2026-2.md

# Çok Elemanlı Basınçlı Kap — Uygulama Görevleri (Sürüm 2)

> **Sürüm notu:** Bu dosya `21.09.2026-1.md`'nin bağımsız doğrulamadan geçmiş ve
> genişletilmiş hâlidir. `-1`'in bütün görevleri, faz yapısı ve teslim sırası aynen
> korunmuştur. Doğrulamada `-1`'in durum iddialarının tamamı ve kalite kapısı tabanı
> (`586 passed / 1 skipped`) kodla teyit edildi.
>
> **Sürüm 2'de eklenenler:** (1) FEA kapsam durumu — §1 ve yeni §7.4, (2) PED kategorisi ↔
> zincir hacmi bağı — §10 ve §12, (3) wiring test istisna listelerinin bakımı — §4.1, §4.2,
> §9.1, §12, (4) belirleyici (governing) MDMT — §10 ve §11. Ayrıca §13 madde 10'daki
> "Faz 11–12" yazım hatası "Bölüm 11–12" olarak düzeltildi.
>
> `21.09.2026-1.md` tarihsel kayıt olarak değiştirilmeden bırakılmıştır.

Bu doküman, mevcut tek silindir ağırlıklı uygulamayı aşağıdaki eleman zincirini güvenli biçimde
oluşturabilen, kaydedebilen, doğrulayabilen, hesaplayabilen ve görüntüleyebilen yapıya dönüştürmek
için yapılacak işleri tanımlar:

```text
bombe → büyük silindir → koni → küçük silindir → bombe
```

Amaç yalnızca yeni alanları arayüzde göstermek değildir. Kullanıcı bir elemanı düzenlediğinde başka
elemanların kaybolmaması; hesapların doğru malzeme, kaynak ve geometriyi kullanması; desteklenmeyen
standart durumlarının sessizce hesaplanmaması temel kabul şartıdır.

## 1. Mevcut durum ve kritik açıklar

- Backend `VesselProject` modeli birden fazla `shell_sections`, `heads` ve `cones` kaydı tutabiliyor.
- Hesap orkestratörü silindir, bombe ve konileri döngüyle temel kalınlık ve MAWP hesabına gönderiyor.
- TypeScript `VesselProject` tipi `cones` alanını içermiyor; UI koniyi temsil edemiyor.
- Geometri ekranı yalnız `shell_sections[0]`, `materials[0]` ve `welds[0]` üzerinde çalışıyor.
- `setShell`, `setMat` ve `setWeld` güncellemeleri dizileri tek elemanla yeniden kuruyor. İkinci eleman
  eklendikten sonra ilk elemanda alan değiştirmek diğer elemanları silebilir.
- Nozul host seçenekleri sabit `SHELL-01`, `HEAD-L` ve `HEAD-R` değerlerine bağlı.
- Geometri doğrulaması yalnız ilk silindir ve mevcut bombeleri değerlendiriyor.
- 2B/3B önizleme ve CAD ilk silindir ile iki bombe varsayımına bağlı.
- Açık bir eleman sırası/topoloji modeli ve koni–silindir birleşim modeli bulunmuyor.
- Hidrotest/pnömatik test, kaynak doğrulama, destek ve vakum yollarında ilk malzeme veya ilk silindir
  kısayolları bulunuyor.
- **FEA paketi tek gövde kesiti ön koşulu koşuyor.** `packages/fea/src/fea/geometry_prep.py`
  içindeki `check_symmetry_preconditions`, gövde kesiti sayısı 1 değilse 1/8 simetri modelini
  kurmayı reddediyor. Davranış doğrudur, ancak çok elemanlı zincirde bu reddin kullanıcıya
  nasıl yansıyacağı tanımlı değildir.

## 2. Uygulama ilkeleri

- Kimlikler kalıcı ve benzersiz olmalı; liste sırası kimlik yerine kullanılmamalı.
- Dizi güncellemeleri immutable yapılmalı ve hedef dışındaki kayıtları korumalı.
- Eleman sırası ayrı ve açık bir zincir/topoloji alanında tutulmalı.
- Elemanlar `material_id` ve `weld_joint_id` ile gerçek kayıtlarına bağlanmalı.
- Desteklenmeyen mühendislik durumu yaklaşık sonuç üretmemeli; `OUT_OF_SCOPE`,
  `REVIEW_REQUIRED` veya eksik girdi durumu dönmeli.
- İç basınç, dış basınç, birleşim ve global yük kontrolleri birbirinin yerine geçirilmemeli.
- Telifli ASME metni veya tablo verisi repoya kopyalanmamalı; yalnız madde atfı, kullanıcı girdisi ve
  uygulamanın kendi analizi saklanmalı.
- Eski tek silindirli projelerin sayısal sonuçları ve açılabilirliği korunmalı.

## 3. Faz 0 — Veri kaybı regresyonunu hemen kapat

Bu faz eleman düzenleyicinin ön koşuludur ve sonraya bırakılamaz.

- [ ] `setShell(patch)` yerine `updateShell(sectionId, patch)` veya indeks yerine kimlik kullanan eşdeğer
  bir store işlemi oluştur.
- [ ] Güncellemede `shell_sections.map(...)` kullan; hedef dışındaki tüm silindirleri aynen koru.
- [ ] `setMat` işlemini `updateMaterial(materialId, patch)` biçimine dönüştür ve tüm malzeme listesini koru.
- [ ] `setWeld` işlemini `updateWeld(jointId, patch)` biçimine dönüştür ve tüm kaynak listesini koru.
- [ ] Bombe güncellemesini kimlik bazlı hale getir; dizi indeksini kalıcı kimlik gibi kullanma.
- [ ] Store'a silindir, bombe, koni, malzeme ve kaynak için `add`, `update` ve `remove` işlemleri ekle.
- [ ] Eleman silme işleminde bağlı nozul, destek, kaynak ve topoloji referanslarını kontrol et; bağlı kayıt
  varsa sessizce silme. Kullanıcıya bağlı kayıtları göstererek işlemi engelle veya açıkça onaylanan
  kontrollü cascade uygula.
- [ ] Yeni kimlikleri mevcut en büyük numaradan üret; bir eleman silindikten sonra eski kimlikleri yeniden
  numaralandırma.
- [ ] Her proje mutasyonunda `dirty=true` ve `calc=null` davranışını koru.

### Faz 0 testleri

- [ ] İki silindirli projede ilk silindirin çapını değiştirmek ikinci silindiri silmemeli veya değiştirmemeli.
- [ ] İki malzemeli projede ilk malzemeyi değiştirmek ikinci malzemeyi korumalı.
- [ ] İki kaynaklı projede ilk kaynağı değiştirmek ikinci kaynağı korumalı.
- [ ] Bir alan düzenlemesinden sonra eleman sırası ve kimlikler değişmemeli.
- [ ] Mutasyon sonrasında eski hesap sonucu temizlenmeli.

## 4. Faz 1 — UI ve backend veri sözleşmesini eşitle

### 4.1. TypeScript tipleri

- [ ] Python `Cone` modeliyle uyumlu bir TypeScript `Cone` arayüzü ekle.
- [ ] `VesselProject` tipine zorunlu `cones: Cone[]` alanını ekle.
- [ ] Varsayılan projeye `cones: []` ekle.
- [ ] API'den açılan eski kayıtta alan yoksa `cones=[]` olarak normalize et.
- [ ] Geometri bileşenleri için ortak `ComponentType = "head" | "shell" | "cone"` türü tanımla.
- [ ] **Koni alanları UI'ya bağlandığında `tests/wiring/test_ui_parity.py` içindeki
  `ARAYUZDE_YOK` listesinden 10 adet `Cone.*` kaydını kaldır.** İstisna listesi yalnız
  gerçekten arayüzde bulunmayan alanı taşımalı; UI'ya gelen bir alanın istisna kaydı
  bırakılırsa test geçmeye devam eder ama liste yanlış bilgi taşır.

### 4.2. Açık eleman zinciri

- [ ] Backend ve frontend proje sözleşmesine `component_sequence` ekle.
- [ ] Her sıra kaydı en az `component_type` ve `component_id` içermeli.
- [ ] `component_id`, ilgili `heads`, `shell_sections` veya `cones` dizisindeki gerçek kayda işaret etmeli.
- [ ] Aynı bileşen zincirde iki kez kullanılamamalı.
- [ ] Zincirdeki her kimlik mevcut olmalı; dizilerde bulunup zincirde bulunmayan basınç taşıyan eleman
  doğrulama hatası üretmeli.
- [ ] İlk teslimatta yalnız doğrusal, dallanmayan, aynı eksenli ve konsantrik zincir desteklenmeli.
- [ ] İlk sürümde ayrı node tablosu yerine sıralı bileşen referansları kullanılabilir; birleşimler komşu iki
  sıra kaydından deterministik üretilmeli.
- [ ] **Yeni `component_sequence` alanları ya arayüzde gösterilmeli ya da gerekçesiyle
  `ARAYUZDE_YOK` listesine yazılmalı.** Sessiz bırakılan yeni domain alanı wiring testini
  düşürür.

Örnek sözleşme:

```json
"component_sequence": [
  {"component_type": "head", "component_id": "HEAD-L"},
  {"component_type": "shell", "component_id": "SHELL-01"},
  {"component_type": "cone", "component_id": "CONE-01"},
  {"component_type": "shell", "component_id": "SHELL-02"},
  {"component_type": "head", "component_id": "HEAD-R"}
]
```

### 4.3. Geriye dönük uyumluluk ve migrasyon

- [ ] `component_sequence` alanı olmayan ve tek silindir + iki bombe içeren eski projeyi otomatik olarak
  `HEAD-L → SHELL-01 → HEAD-R` sırasına dönüştür.
- [ ] Birden fazla basınç taşıyan elemanı bulunan fakat sırası olmayan eski veride sessiz tahmin yapma;
  açık migrasyon hatası veya kullanıcı sıralaması iste.
- [ ] Kaydetme sonrasında normalize edilmiş zinciri projede kalıcı olarak sakla.
- [ ] Eski projenin hash/revizyon davranışına etkisini açıkça test et.

### Faz 1 testleri

- [ ] TypeScript ve Pydantic proje şemaları `cones` ve `component_sequence` için uyumlu olmalı.
- [ ] Eski tek silindirli JSON başarıyla açılmalı ve doğru zincire dönüşmeli.
- [ ] Eksik veya yinelenen bileşen kimliği reddedilmeli.
- [ ] Çok elemanlı sırasız eski veri sessizce sıralanmamalı.
- [ ] Kaydet/aç turunda sıra, kimlikler ve referanslar korunmalı.

## 5. Faz 2 — Eleman düzenleyici arayüzü

- [ ] Geometri ekranında sıralı bir eleman listesi göster.
- [ ] Her satırda eleman tipi, kimlik, giriş/çıkış çapı, uzunluk ve kalınlık özeti göster.
- [ ] `Bombe ekle`, `Silindir ekle` ve `Koni ekle` işlemlerini ekle.
- [ ] `Kopyala`, `Sil`, `Yukarı taşı` ve `Aşağı taşı` işlemlerini ekle.
- [ ] Seçili elemana göre formu değiştir: bombe, silindir ve koni alanları aynı anda gösterilmemeli.
- [ ] Yeni silindir varsayılan olarak seçili/komşu elemanın malzeme ve kaynak kimliğini devralmalı; yeni
  benzersiz bileşen kimliği almalı.
- [ ] Yeni koni, iki komşu silindirin çapları biliniyorsa büyük ve küçük çapları bunlardan başlatmalı;
  bilinmiyorsa kullanıcıdan istemeli.
- [ ] Sürükle-bırak zorunlu değil; yukarı/aşağı düğmeleri ilk teslimat için yeterli.
- [ ] Terminal bombelerin ara konuma taşınmasını veya zinciri açıkta bırakmasını doğrulama engellemeli.
- [ ] En az bir basınç taşıyan gövde kalmadan silme işlemi engellenmeli.

### 5.1. Malzeme ve kaynak editörleri

- [ ] Malzeme listesini eklenebilir, seçilebilir ve kimlik bazlı düzenlenebilir hale getir.
- [ ] Kaynak listesini eklenebilir, seçilebilir ve kimlik bazlı düzenlenebilir hale getir.
- [ ] Seçili elemanda malzeme ve boyuna kaynak açılır listeleri göster.
- [ ] Kullanımda olan malzeme veya kaynak silinmek istendiğinde bağlı elemanları göster ve silmeyi engelle.
- [ ] Koni–silindir çevresel birleşim kaynağını elemanın boyuna kaynağından ayrı temsil etmeye hazırlık için
  birleşim bazlı kaynak seçimi ekle.

### 5.2. Nozul ve destek bağları

- [ ] Nozul host seçeneklerini mevcut uygun bileşenlerden dinamik üret.
- [ ] İlk sürümde silindir ve bombe host destekle; koni nozulu seçeneğini gizle veya açıkça
  `OUT_OF_SCOPE` olarak işaretle.
- [ ] Host değiştiğinde eksenel konumu yeni host geometrisine göre doğrula; sessizce kırpma yapma.
- [ ] Destekleri zincirdeki global eksenel konum ve mümkünse `host_component_id` ile ilişkilendir.

### Faz 2 kabul kriterleri

- [ ] Kullanıcı arayüzden `bombe → büyük silindir → koni → küçük silindir → bombe` dizisini kurabilmeli.
- [ ] Tek bir alan düzenlendiğinde hiçbir başka eleman, malzeme veya kaynak kaybolmamalı.
- [ ] Eleman taşıma ve kopyalama işlemleri kimlik ve sıra bütünlüğünü korumalı.
- [ ] Proje kaydedilip açıldığında aynı seçilebilir eleman zinciri geri gelmeli.

## 6. Faz 3 — Zincir tabanlı geometrik doğrulama

- [ ] Doğrulamayı `shell_sections[0]` yerine `component_sequence` üzerinden çalıştır.
- [ ] Zincir boş mu, kimlikler benzersiz mi ve tüm referanslar mevcut mu kontrol et.
- [ ] İki terminalde kapama elemanı bulunduğunu doğrula.
- [ ] Açıkta kalan ara uç veya kopuk zincir bulunmadığını doğrula.
- [ ] Komşu eleman uç çaplarını toleranslı karşılaştır; varsayılan çap toleransı 0,01 mm olsun.
- [ ] Silindir–bombe çapı ve silindir–koni büyük/küçük uç çapı uyuşmazlıklarını ilgili birleşimde göster.
- [ ] Koni büyük/küçük çap yönünü zincirdeki komşulara göre doğrula.
- [ ] Aynı koninin `large_diameter > small_diameter` koşulunu doğrula.
- [ ] Koni çapları, eksenel uzunluk ve yarı tepe açısı ilişkisini doğrula.
- [ ] UI'da esas veri çaplar + uzunluk olsun; yarı tepe açısı bunlardan hesaplansın.
- [ ] Kullanıcı açı girişi korunacaksa hesaplanan açıyla tolerans içinde eşleşmesini zorunlu tut.
- [ ] Her elemanın malzeme ve kaynak referanslarının mevcut olduğunu doğrula.
- [ ] Nozul ve destek host referanslarını doğrula.

### 6.1. Koni applicability kapıları

- [ ] `α ≤ 30°`: temel koni yolu kullanılabilir; diğer birleşim kontrolleri yine ayrıca çalışmalı.
- [ ] `α > 30°`: torikonik geçiş/knuckle verisi veya özel analiz yoksa sonuç `REVIEW_REQUIRED` ya da
  `OUT_OF_SCOPE` olmalı.
- [ ] `α > 60°`: Appendix 1-8 dış basınç birleşim hesabı uygulanmamalı ve açık
  `OUT_OF_SCOPE`/`REVIEW_REQUIRED` sonucu üretilmeli.
- [ ] Domain modelindeki mevcut `le=80` veri kabul sınırı, hesap uygulanabilirliği anlamına gelmemeli.
- [ ] Bloklayıcı geometri hatası varken hesap çağrısı ve kesin CAD üretimi engellenmeli.

### Faz 3 testleri

- [ ] Tam 30°, 30° üzeri, tam 60° ve 60° üzeri sınır durumlarını ayrı test et.
- [ ] Uyuşmayan komşu çaplar hesap öncesinde reddedilmeli.
- [ ] Ters yönlü koni ve kopuk zincir reddedilmeli.
- [ ] Silinmiş hosta bağlı nozul/destek doğrulama hatası üretmeli.
- [ ] Geometri issue signature bütün elemanları ve sıralarını kapsamalı.

## 7. Faz 4 — 2B/3B önizleme ve CAD

### 7.1. 2B şema

- [ ] 2B şemayı eleman zincirinden eksenel profil oluşturarak çiz.
- [ ] Silindiri sabit çap, koniyi doğrusal çap geçişi, bombeyi tipine uygun uç profili olarak göster.
- [ ] Her elemanı seçilebilir yap; formdaki seçim ile şemadaki vurgu çift yönlü çalışsın.
- [ ] Ölçüleri eleman bazında göster; toplam boyu zincirden hesapla.
- [ ] Çap uyuşmazlığı ve applicability uyarılarını ilgili birleşimin üzerinde göster.
- [ ] Nozulun global konumunu host elemanın zincir başlangıcından türet.

### 7.2. Hızlı 3B önizleme

- [ ] 2B ile aynı normalize edilmiş profil verisini kullan; ikinci bir geometri gerçeği oluşturma.
- [ ] Tüm elemanları ortak eksende sırala ve çap geçişlerini görünür yap.
- [ ] Desteklenmeyen koni nozulu gibi öğeleri yanlış yerde çizmek yerine gizle ve kullanıcıya durum bildir.

### 7.3. Kesin CAD

- [ ] CAD motorunu `shell_sections[0] + iki bombe` yaklaşımından çıkar.
- [ ] Zincirden iç ve dış cidar profili oluştur.
- [ ] Profili döndürerek tek, kapalı ve su geçirmez katı üret.
- [ ] Eleman birleşimlerinde boşluk veya üst üste binme olmadığını doğrula.
- [ ] STEP ve STL çıktısında tüm zincirin bulunduğunu test et.
- [ ] CAD dönüşümü tamamlanana kadar çok elemanlı kesin model isteği açık `OUT_OF_SCOPE` sonucu vermeli;
  ilk silindire göre eksik model üretmemeli.

### 7.4. FEA kapsam durumu

FEA, CAD ile aynı deseni izlemelidir: geometri zincirini tüketen bir alt sistemdir ve
desteklemediği girdide sessiz kalmak yerine açık kapsam sonucu üretmelidir.

- [ ] Çok elemanlı zincirde FEA açık `OUT_OF_SCOPE` sonucu üretmeli; ilk silindire göre kısmi
  model kurmamalı.
- [ ] `check_symmetry_preconditions` reddi sessiz hata veya boş ekran olarak kalmamalı; kapsam
  sonucu olarak yüzeye çıkmalı.
- [ ] Sebep kullanıcıya görünür olmalı: hangi ön koşulun sağlanmadığı ve kaç gövde kesiti
  bulunduğu belirtilmeli.
- [ ] FEA'nın çok elemanlı desteği ayrı ve sonraki bir iş kalemi olarak kaydedilmeli; bu fazın
  kapsamı yalnız dürüst kapsam bildirimidir.

### Faz 4 testleri

- [ ] Örnek çok elemanlı kap tek geçerli katı üretmeli.
- [ ] Analitik iç hacim ile CAD hacmi belirlenen tolerans içinde uyuşmalı.
- [ ] Eleman bazlı metal hacimleri toplam metal hacmine eşit olmalı.
- [ ] STEP/STL sınama dosyaları ikinci silindir ve koniyi içermeli.
- [ ] Eski tek silindirli CAD çıktısının temel ölçüleri değişmemeli.
- [ ] **Çok elemanlı fixture'da FEA `OUT_OF_SCOPE` dönmeli; tek silindirli projede mevcut FEA
  davranışı değişmemeli.**

## 8. Faz 5 — Hesap yolundaki ilk-eleman kısayolları

### 8.1. Hidrotest ve pnömatik test

- [ ] `design_code.py:643, 734` üzerindeki `materials[0]` kullanımını kaldır.
- [ ] Test basıncında tüm basınç taşıyan bileşenlerin gerçek malzemelerini değerlendir.
- [ ] Her malzeme için test sıcaklığı ve tasarım sıcaklığı gerilme oranını elde et.
- [ ] Standardın gerektirdiği belirleyici oranı/test basıncı sınırını kullan ve hangi bileşen/malzemenin
  belirlediğini sonuçta raporla.
- [ ] Eksik test sıcaklığı malzeme gerilmesi varsa tahmin yapma; eksik girdi/review sonucu üret.
- [ ] Global MAWP düzeltmesinden sonraki değeri test basıncı tabanı olarak kullanma davranışını koru.

### 8.2. Kaynak doğrulaması

- [ ] `design_code.py:943` üzerindeki `shell_sections[0]` referans kalınlığını kaldır.
- [ ] Her kaynak için bağlı gerçek bileşeni veya birleşimi çöz.
- [ ] Boyuna kaynakta ilgili eleman kalınlığını, çevresel birleşimde komşu eleman kalınlıklarını kullan.
- [ ] Bağlantısı belirlenemeyen kaynak için ilk silindire düşme; `REVIEW_REQUIRED` üret.

### 8.3. Destekler

- [ ] `design_code.py:1029` üzerindeki ilk silindir bağımlılığını kaldır.
- [ ] Destek konumunu eleman zincirindeki global eksenel konuma göre çöz.
- [ ] Eyer desteğinde gerçek host kesit çapı/kalınlığını kullan.
- [ ] Etek ve ayak desteğinde bağlandığı terminal/yerel kesiti kullan.
- [ ] Geçiş veya koni üzerine gelen destek mevcut hesap modelinin dışındaysa açık review sonucu üret.

### 8.4. Vakum ve dış basınç

- [ ] `design_code.py:1172` üzerindeki ilk silindir kontrolünü kaldır.
- [ ] Her silindir için dış basınç/vakum kontrolünü ayrı çalıştır.
- [ ] Desteklenmeyen uzunlukları komşu bombe, koni birleşimi ve rijitleştiricilerden türet.
- [ ] Her uygun koni için dış basınç kontrolü ve Appendix 1-8 applicability kapısını çalıştır.
- [ ] Gerekli A/B faktörleri eksikse tahmin yapma; mevcut eksik girdi davranışını koru.

### Faz 5 testleri

- [ ] Farklı malzemeli iki silindirde test basıncı ilk malzemeye göre sabit kalmamalı; belirleyici malzeme
  raporlanmalı.
- [ ] İkinci silindire bağlı kaynağın doğrulaması ikinci silindirin kalınlığını kullanmalı.
- [ ] İkinci silindire yerleştirilmiş destek gerçek yerel geometrisini kullanmalı.
- [ ] Vakum kontrolü her silindir için ayrı sonuç üretmeli.
- [ ] Tek silindirli eski projenin test basıncı ve destek sonuçları geriye dönük tolerans içinde kalmalı.

## 9. Faz 6 — Koni birleşimleri ve mühendislik kontrolleri

### 9.1. Birleşim modeli

- [ ] Komşu eleman çiftinden türetilen veya projede açıkça saklanan bir `Junction` modeli oluştur.
- [ ] Birleşimde sol/sağ bileşen kimlikleri, koni büyük/küçük uç bilgisi, çevresel kaynak kimliği,
  knuckle bilgisi ve takviye halkası verileri bulunmalı.
- [ ] Koni boyuna kaynağı ile büyük/küçük uç çevresel kaynaklarını ayrı tut.
- [ ] Her koni için büyük ve küçük uç sonucu bağımsız üret.
- [ ] **Yeni `Junction` alanları ve `junction_*` sonuç tipleri ya arayüzde gösterilmeli ya da
  gerekçesiyle istisna listelerine yazılmalı** — `test_ui_parity.py` içindeki `ARAYUZDE_YOK`
  ve `test_no_ghost_features.py` içindeki `UI_DE_GOSTERILMEYENLER` dahil.

### 9.2. İç basınç — Appendix 1-5

- [ ] Büyük uç ve küçük uç birleşimlerini ayrı hesapla.
- [ ] Gerekli takviye alanını hesapla.
- [ ] Silindir ve koniden gelen kullanılabilir alanı ayrı göster.
- [ ] Ek takviye halkası alanını ayrı göster.
- [ ] Knuckle/toroidal geçiş varsa uygun kalınlık ve MAWP yolunu çalıştır.
- [ ] Sonucu `PASS`, `FAIL`, `REVIEW_REQUIRED` veya `OUT_OF_SCOPE` olarak sınıflandır.

### 9.3. Dış basınç — Appendix 1-8

- [ ] İç basınç hesabından ayrı bir hesap türü ve sonuç kaydı oluştur.
- [ ] Gerekli atalet momenti ve takviyeyi Appendix 1-8 kapsamı altında değerlendir.
- [ ] Yalnız `α ≤ 60°` için uygulamaya izin ver.
- [ ] Halka/komşu cidardan gelen mevcut atalet katkılarını izlenebilir biçimde raporla.
- [ ] `α > 60°` için hesap üretme; applicability sonucu üret.

### 9.4. Standart atıfları

- [ ] Mevcut koni formülündeki `UG-32(g)` atfını lisanslı ASME VIII-1 2025 metniyle teyit et.
- [ ] Bazı kaynaklardaki `UG-32(f)` numaralandırma farkını baskı/sürüm farkı olarak incele.
- [ ] Lisanslı metinden telifli paragraf veya tabloyu repoya kopyalama.
- [ ] Sonuçlarda yalnız kullanılan madde numarası, girdi, ara değer ve uygulamanın kendi hesap açıklamasını
  göster.

### Faz 6 testleri

- [ ] Koni büyük ve küçük uç sonuçları ayrı component/junction kimliğiyle raporlanmalı.
- [ ] İç ve dış basınç birleşim sonuçları birbirinden ayrı olmalı.
- [ ] Takviye halkası eklemek mevcut alan/atalet sonucunu beklenen yönde değiştirmeli.
- [ ] 60° üzeri konide Appendix 1-8 sonucu hesaplanmış gibi görünmemeli.
- [ ] Lisanslı ASME 2025 örnekleri ve mümkünse PV Elite/COMPRESS çıktılarıyla kör karşılaştırma yapılmalı.

## 10. Faz 7 — Hacim, ağırlık ve global yükler

- [ ] İç hacmi eleman bazında hesapla ve toplamla.
- [ ] Metal hacmi ve boş ağırlığı eleman bazında hesapla.
- [ ] İşletme ve hidrotest sıvı ağırlığını gerçek zincir hacminden üret.
- [ ] Ağırlık merkezini elemanların global eksenel konumlarından hesapla.
- [ ] Dikey kapta her elemanın kotuna bağlı statik sıvı basıncını hesapla.
- [ ] Rüzgâr ve deprem yüklerini değişken çaplı dış profile uygula.
- [ ] Kesit bazında eksenel ve eğilme gerilmelerini raporla.
- [ ] Çap değişim noktalarını global yük değerlendirmesinde ayrı kritik kesit olarak ele al.
- [ ] Global MAWP'yi bütün geçerli bileşen ve birleşim sonuçlarının en zayıfından belirle; review/out-of-scope
  sonuçlarını sessizce geçerli minimum hesabına katma veya yok sayma.
- [ ] **Eleman bazında toplanan iç hacmin PED sınıflandırmasına (`ps × V`) girdi olarak
  aktarıldığını doğrula.** PED motoru kategoriyi doğrudan hacimden türetir
  (`ped-2014-68-eu/engine.py` → `table.classify(ps_mpa, volume_liters)`); zincir hacmi
  yerine tek silindir hacminin kullanılması yanlış kategori ve yanlış uygunluk modülü
  üretir.
- [ ] **Zincire eleman eklemek/çıkarmak PED kategori sınırını geçiriyorsa kategori değişimi
  sonuçta ve raporda açıkça görünsün;** kategori sessizce değişmemeli.
- [ ] **Kap MDMT'sini bütün elemanların MDMT sonuçlarının en kısıtlayıcısından belirle;
  belirleyici elemanı ve malzemesini kaydet.** `REVIEW_REQUIRED`/`BLOCKED` MDMT sonuçları
  sessizce en kısıtlayıcı seçimine dahil edilmemeli — global MAWP için konan kuralın aynısı
  geçerlidir.

## 11. Sonuçlar ve raporlama

- [ ] Sonuçları eleman ve birleşim kimliğine göre grupla.
- [ ] Her sonuçta hesap türü, component/junction kimliği, standart atfı, durum ve belirleyici ara değerleri göster.
- [ ] Global MAWP'yi belirleyen eleman veya birleşimi açıkça belirt.
- [ ] `PASS`, `FAIL`, `REVIEW_REQUIRED`, `OUT_OF_SCOPE`, `BLOCKED_MISSING_INPUT` durumlarını UI'da farklı ve
  tutarlı biçimde göster.
- [ ] Çok elemanlı kap şemasında sorunlu eleman/birleşime sonuç ekranından gidilebilsin.
- [ ] Raporlarda eleman sırası, eleman geometrileri, malzeme/kaynak bağları ve applicability uyarıları yer alsın.
- [ ] **Belirleyici MDMT'yi üreten elemanı ve malzemesini, tıpkı global MAWP'de olduğu gibi,
  sonuç ekranında ve raporda açıkça belirt.**

## 12. Test altyapısı ve kalite kapıları

- [ ] Frontend state ve geometri yardımcıları için Vitest tabanlı birim test altyapısı ekle.
- [ ] UI testini mümkün olduğunca saf store/reducer ve geometri fonksiyonlarında yap; yalnız kritik kullanıcı
  akışları için bileşen testi ekle.
- [ ] Backend domain, migrasyon, orchestrator ve standart eklentisi testlerini ayrı katmanlarda tut.
- [ ] Aşağıdaki uçtan uca fixture'ı tek kaynak olarak ekle:

```text
HEAD-L → SHELL-01 (büyük) → CONE-01 → SHELL-02 (küçük) → HEAD-R
```

- [ ] Fixture en az iki malzeme ve iki kaynak içermeli; ikinci silindir ilkinden farklı malzemeye bağlanmalı.
- [ ] API create/get/update işlemleri fixture'ı veri kaybı olmadan taşımalı.
- [ ] Hesap sonucu her silindir, bombe ve koni için ayrı kalınlık/MAWP kaydı içermeli.
- [ ] Büyük/küçük koni uçları ayrı birleşim sonuçları üretmeli.
- [ ] 2B, 3B ve CAD aynı eleman sırasını kullanmalı.
- [ ] **Çok elemanlı fixture'ın PED kategorisi, aynı toplam hacme sahip tek silindirli referans
  projeyle tutarlı çıkmalı.**
- [ ] Mevcut tek silindirli golden testler değişmeden geçmeli.
- [ ] `pytest` kalite kapısı en az mevcut tabanı korumalı: **586 passed / 1 skipped**.
- [ ] `npx.cmd tsc --noEmit` **0 hata** ile tamamlanmalı.
- [ ] Frontend birim testleri eksiksiz geçmeli.
- [ ] **Wiring istisna listelerinde bayat kayıt bulunmamalı:** arayüzde gerçekten var olan bir
  alan `ARAYUZDE_YOK` veya `UI_DE_GOSTERILMEYENLER` listesinde kalmamalı.
- [ ] Kod değişiklikleriyle ilgisiz mevcut çalışma ağacı değişiklikleri korunmalı.

## 13. Önerilen uygulama ve teslim sırası

1. Faz 0: dizi veri kaybı düzeltmeleri ve regresyon testleri
2. Faz 1: TypeScript/backend sözleşmesi, `cones`, `component_sequence`, migrasyon
3. Faz 2: eleman, malzeme, kaynak ve host düzenleyici UI
4. Faz 3: zincir tabanlı geometri ve açı applicability doğrulaması
5. Faz 4.1: zincir tabanlı 2B şema
6. Faz 5: hesap yolundaki ilk-eleman kısayollarının kaldırılması
7. Faz 6: koni birleşimleri, Appendix 1-5 ve Appendix 1-8
8. Faz 4.2–4.4: hızlı 3B, kesin CAD ve FEA kapsam bildirimi
9. Faz 7: hacim, ağırlık, statik kafa, PED hacim bağı ve global yükler
10. Bölüm 11–12: sonuç ekranı, rapor, uçtan uca doğrulama ve golden karşılaştırmalar

İlk kullanılabilir teslimat Faz 0–3 ve zincir tabanlı 2B şemayı içermelidir. Bu teslimatta kullanıcı
çok elemanlı projeyi güvenle oluşturup kaydedebilir; henüz tamamlanmamış CAD veya standart hesapları
ise açık kapsam durumlarıyla görür. Tam mühendislik teslimatı Faz 4–7 ve raporlama tamamlandığında kabul
edilir.

## 14. Tamamlanma tanımı

Aşağıdaki koşulların tümü sağlanmadan iş tamamlanmış sayılmaz:

- [ ] Kullanıcı örnek beş elemanlı zinciri yalnız UI kullanarak oluşturabiliyor.
- [ ] Herhangi bir tek alan düzenlemesi başka hiçbir kaydı kaybettirmiyor.
- [ ] Proje kaydet/aç turunda zincir, malzemeler, kaynaklar, nozul ve destek bağları korunuyor.
- [ ] Geometri ve açı applicability hataları hesap öncesinde doğru elemanda gösteriliyor.
- [ ] Temel kalınlık ve MAWP her eleman için gerçek malzeme ve kaynakla hesaplanıyor.
- [ ] Test basıncı, kaynak, destek ve vakum kontrollerinde ilk-eleman kısayolu kalmıyor.
- [ ] Koni büyük/küçük uç ile iç/dış basınç birleşim sonuçları ayrı raporlanıyor.
- [ ] 2B, 3B ve CAD aynı eleman zincirini temsil ediyor.
- [ ] **FEA, desteklemediği çok elemanlı zincirde açık `OUT_OF_SCOPE` bildiriyor; sessiz veya
  kısmi model üretmiyor.**
- [ ] **PED kategorisi zincirden gelen gerçek hacimle belirleniyor.**
- [ ] **Belirleyici MDMT ve onu üreten eleman raporlanıyor.**
- [ ] Eski tek silindirli projeler ve mevcut sayısal sonuçlar bozulmuyor.
- [ ] Tüm otomatik testler ve TypeScript kontrolü başarıyla tamamlanıyor.
