cakmacbum/bas-ncl-kap/22.09.2026-0.md

# 22.09.2026-0 — Çok elemanlı basınçlı kap uygulama devri

## Durum özeti

Ana uygulama planı [21.09.2026-2.md](21.09.2026-2.md) dosyasındadır. Plan dört iş hattına bölünerek ilerletilmektedir. Bu dosya, 21.09.2026 sonunda kalınan uygulama durumunun devridir.

Gerçek alt-agent çalıştırma aracı bu oturumda bulunmadığı için işler aynı çalışma ağacında dört kontrollü iş paketi olarak yürütülmektedir. Var olmayan paralel ajanlar çalışıyor gibi raporlanmayacaktır.

## Tamamlananlar

### Veri modeli ve UI

- `Cone` TypeScript modeli eklendi.
- Backend `ComponentReference` ve `component_sequence` alanlarını destekliyor.
- Eski tek silindir + iki bombe projeleri açılırken `HEAD-L → SHELL-01 → HEAD-R` zincirine normalize ediliyor.
- Birden fazla elemanlı ve sırası eksik eski projelerde sessiz sıralama yapılmıyor; açık migrasyon hatası veriliyor.
- UI'da silindir, malzeme veya kaynak alanı düzenlendiğinde diğer dizi elemanları kaybolmuyor.
- Geometri ekranına eleman zinciri listesi, silindir ekleme, koni ekleme ve temel koni alanları eklendi.
- Zincir kimlikleri, yinelenen referanslar, eksik bileşenler, terminal bombeler ve komşu çapları doğrulanıyor.
- Koni applicability kapıları eklendi:
  - `α > 30°`: knuckle/torikonik veya özel analiz olmadan bloklayıcı inceleme.
  - `α > 60°`: Appendix 1-8 dış basınç birleşimi kapsam dışı.

### Hesap ve FEA

- Hidrotest ve pnömatik testte `materials[0]` bağımlılığı kaldırıldı; projeye bağlı en düşük izin verilen gerilmeli malzeme belirleyici seçiliyor ve rapora yazılıyor.
- Kaynak doğrulaması artık ilk silindirin kalınlığını kullanmıyor; kaynak kimliğine bağlı bileşen kalınlıklarını değerlendiriyor.
- MDMT bileşen listesine koniler eklendi.
- Vakum kontrolü artık tüm silindir kesitlerinde çalışıyor.
- Çok elemanlı FEA girdisi kısmi model üretmeden açık `OUT_OF_SCOPE` sonucu veriyor; gövde/koni/bombe sayıları uyarıda bulunuyor.

## Doğrulama durumu

- Genel kalite kapısı: **586 passed / 1 skipped**.
- FEA ve calc-core hedef testleri: **26 passed**.
- ASME/EN golden testleri: **75 passed**.
- Kaynak/destek/vakum/nozul hedef testleri: **97 passed**.
- TypeScript `npx.cmd tsc --noEmit`: **0 hata**.

## Kalan dört iş hattı

### 1. Veri/UI hattı — tamamlanacaklar

- Eleman silme, kopyalama ve yukarı/aşağı taşıma işlemlerini kimlik bazlı tamamla.
- Malzeme ve kaynak listelerini eklenebilir/seçilebilir hale getir.
- Nozul host seçeneklerini zincirdeki gerçek bileşenlerden üret.
- Desteklere `host_component_id` veya eşdeğer açık bağ ekle.
- Beş elemanlı fixture'ı UI/API kaydet-aç turunda doğrula.

### 2. Geometri/CAD/3B hattı

- 2B şemayı `component_sequence` üzerinden üret; ilk silindir ve iki bombe varsayımını kaldır.
- 3B hızlı görünümü aynı normalize edilmiş zincir profilinden üret.
- CAD motorunda tek silindir + iki bombe yaklaşımını zincir profiline dönüştür.
- Çok elemanlı kesin CAD henüz hazır değilse eksik model üretmek yerine `OUT_OF_SCOPE` döndür.
- STEP/STL çıktısında koni ve ikinci silindiri test et.

### 3. Hesap ve mühendislik hattı

- Destek hesabında ilk silindir bağımlılığını kaldır; host/ge global eksen konumunu çöz.
- Koni büyük/küçük uç birleşimleri için `Junction` modeli oluştur.
- İç basınç Appendix 1-5 sonuçlarını iki uç için ayrı üret.
- Dış basınç Appendix 1-8 hesabını yalnız `α ≤ 60°` için çalıştır.
- Koni çevresel kaynaklarını boyuna kaynaklardan ayır.
- `UG-32(g)`/`UG-32(f)` baskı farkını lisanslı ASME VIII-1 2025 metniyle teyit et; telifli metin ekleme.

### 4. Global sonuçlar, PED, MDMT ve test hattı

- Zincirden toplam iç hacim, metal hacmi, ağırlık merkezi ve global yükleri üret.
- PED `ps × V` hesabına tek silindir yerine zincir toplam hacmini bağla.
- Kategori değişimini eleman ekleme/çıkarma sonrasında görünür raporla.
- Governing MDMT'yi tüm geçerli bileşenlerden seç; belirleyici eleman ve malzemeyi raporla.
- Sonuç ekranında eleman/junction kimliği, durum ve applicability uyarılarını göster.
- Beş elemanlı uçtan uca fixture ekle:

  `HEAD-L → SHELL-01 → CONE-01 → SHELL-02 → HEAD-R`

- Fixture'ta en az iki malzeme ve iki kaynak kullan; ikinci silindir ilkinden farklı malzemeye bağlı olsun.
- 2B, 3B, CAD, hesap ve raporun aynı zinciri kullandığını doğrula.

## Bir sonraki çalışma sırası

1. Destek hesabında host çözümlemesi ve kalan ilk-eleman bağımlılıkları.
2. `Junction` veri modeli ve koni uç sonuçlarının kapsam/girdi iskeleti.
3. Zincir tabanlı 2B profil ve CAD kapsam kapısı.
4. PED toplam hacim ve governing MDMT raporlaması.
5. Beş elemanlı fixture, regresyon testleri ve tam kalite kapısı.

## Korunacak kalite kapıları

- Mevcut tek silindirli davranış ve golden sonuçlar bozulmayacak.
- Çok elemanlı veride hiçbir alan düzenlemesi başka elemanları silemeyecek.
- Desteklenmeyen mühendislik rotaları yaklaşık sonuç üretmeyecek; `OUT_OF_SCOPE`, `REVIEW_REQUIRED` veya eksik girdi durumu dönecek.
- Telifli ASME metni veya tablo verisi repoya kopyalanmayacak.
- `pytest` tabanı en az **586 passed / 1 skipped**, TypeScript kontrolü **0 hata** olarak korunacak.
