cakmacbum/bas-ncl-kap/22.09.2026-1.md

# 22.09.2026-1 — Çok elemanlı kap devam kaydı

## Nerede kalındı

Son önceki devir `22.09.2026-0.md` dosyasıdır. Bu kayıt oluşturulmadan önce `pressure-vessel-suite` çalışma ağacında geniş kapsamlı, commit edilmemiş Faz 4–E değişiklikleri bulunuyordu; bunlar korunarak incelendi ve üzerine devam edildi. HEAD commit'i `aa5d9f4` (`Faz 4 + TS/MMO kapsam denetimi`).

## Bu devamda yapılanlar

- Destek denetiminde `host_component_id` ile shell seçimi ve zincirden global başlangıç konumu çözümlemesi zaten ekliydi.
- Zick eyer açıklığı artık farklı host silindirlerdeki destek konumlarını bir araya getirmiyor; her host için eyer grubu ayrı tutuluyor.
- Desteğin global eksenel konumunun seçilen host silindirin global aralığında olması zorunlu hale getirildi. Aralık dışındaysa sayısal destek sonucu üretilmiyor, `NOT_CALCULATED` nedeni dönüyor.
- Değişiklik `packages/code-asme-viii-1/src/code_asme_viii_1/design_code.py` içindedir.

### Üç paralel iş hattı

- 2B şemada zincir profili ve terminal bombe yerleşimi düzeltildi; 3B zincir profilinde bombe flanş/derinlik ofsetleri hizalandı. Kesin CAD artık yalnızca gerçek kimlik sırası `HEAD → tek SHELL → HEAD` olan destekli zinciri kabul ediyor; diğerleri `OUT_OF_SCOPE`.
- Koni `Junction` modeline açık `cone_end` eklendi. Komşuluk, uç tipi, koni geometrisi, kaynak kaydı ve komşu çapı doğrulanıyor. Eksik/belirsiz girdiler `BLOCKED_MISSING_INPUT`; çözücüsü henüz olmayan tam girdiler `OUT_OF_SCOPE`.
- PED raporlaması, hacim çıktısında tüm basınç taşıyan bileşenlerin tam bir kez bulunmasını şart koşuyor ve kullanılan toplam iç hacmi gösteriyor.
- Governing MDMT kapsamı, zincirdeki kayıtları proje bileşen listeleriyle karşılaştırıyor. Eksik/tekrarlı/uygulanamayan bileşen varken aday sıcaklık final sayı olarak sunulmuyor; rapor ve arayüz bloke durumunu gösteriyor.
- Değişiklik alanları: `apps/web-ui/src/{vesselModel.ts,schematic.tsx,pages.tsx}`, `packages/cad-engine/src/cad_engine/vessel_builder.py`, `packages/domain/src/domain/geometry.py`, ASME `design_code.py`, `apps/api/services.py` ve report-engine `generator.py`.

## Durum ve sıradaki işler

- Kontroller bu devamda çalıştırılmadı.
- Destek, junction çap/kaynak, 2B/3B/CAD, PED ve MDMT değişiklikleri için hedefli inceleme ve doğrulama hâlâ gerekli.
- Beş elemanlı fixture ile API/UI kaydet-aç, zincir tabanlı 2B/3B/CAD, PED toplam hacim ve governing MDMT işlerini tamamlanma ölçütlerine göre sürdür.
- Mevcut commit edilmemiş değişiklikleri koru; ilgisiz dosyaları geri alma veya sıfırlama.
