cakmacbum/bas-ncl-kap/22.09.2026-arayuz.md

# 22.09.2026 — Arayüz görsel yenileme (siyah/beyaz, keskin) — TAMAMLANDI (2026-09-23 doğrulandı)

**Durum: bitti.** 1–3. adımları ben yaptım; 4–5. adımları (theme.css gövdesindeki kalan
sabitler, 3B renkleri) başka bir ajan (Codex) aynı gece tamamladı. Bu oturumda doğrulandı:
- `npx tsc --noEmit` → 0 hata.
- Dev server + tarayıcı: açık tema (`#ffffff`/`#0047ff`/Inter) ve koyu tema
  (`#000000`/`#4d8bff`/Inter) `getComputedStyle` ile teyit edildi; adım 1–4 arası gezinti,
  yan menü aktif/pasif rozet durumları, "Eleman Zinciri" listesi (Codex'in yeni bileşeni,
  `--accent-glow` token'ını doğru kullanıyor) kontrol edildi. Konsol hatası yok.
- `.badge--*` renkleri her iki temada `--accent-contrast` (light: siyah metin yok, beyaz;
  dark: siyah) ile eşleşiyor — kontrast yeterli (vault kaydında min 4.55:1 ölçülmüş).
- Hesap çalıştırılmış PASS/FAIL rozetini canlı görmedim (boş proje) — CSS incelemesiyle
  doğrulandı, riskli görülmedi.

---

## (Orijinal devir notu — artık geçmiş referans)

Kapsam: **yalnız görünüm**. Bileşen yapısı, sınıf adları, TSX mantığı, store/API değişmez.
Kullanıcı kararları: vurgu **mühendislik mavisi** (açık `#0047FF`, koyu `#4D8BFF`),
yazı tipi **Inter + JetBrains Mono** (npm `@fontsource`, yerel).

Dizin: `pressure-vessel-suite/apps/web-ui/`

## Yapılanlar (tamam)

1. **Yazı tipi**
   - `npm i @fontsource/inter @fontsource/jetbrains-mono`; `@fontsource/ibm-plex-*` kaldırıldı.
   - `src/main.tsx`: import'lar Inter 400/500/600/700 + JetBrains Mono 400/500/600.
   - `index.html`: preload linkleri yeni woff2 dosyalarına çevrildi.
2. **`src/theme.css` token'ları** yeniden yazıldı (token adları aynı):
   - Koyu: `--bg #000`, `--panel #0a0a0a`, `--panel-2 #141414`, `--line #2a2a2a`,
     `--line-strong #d4d4d4`, `--text #fafafa`, `--text-dim #b5b5b5`, `--text-faint #8a8a8a`,
     `--accent #4d8bff`, `--accent-contrast #000`.
   - Açık: `--bg/--panel #fff`, `--panel-2 #f5f5f5`, `--line #d4d4d4`, `--line-strong #171717`,
     `--text #0a0a0a`, `--text-dim #404040`, `--text-faint #6b6b6b`, `--accent #0047ff`,
     `--accent-contrast #fff`.
   - Durum renkleri doygunlaştırıldı (pass/fail/review/nc/scope/blocked, iki tema).
   - Yeni yan menü token'ları (iki temada siyah blok): `--nav-bg`, `--nav-line`, `--nav-text`,
     `--nav-dim`, `--nav-hover`, `--nav-active`.
   - `--radius: 2px`, `--radius-sm: 2px`; gölgeler kalktı (`--shadow: 0 0 0 1px var(--line)`,
     `--shadow-sm/--shadow-card: none`); blueprint ızgaraları `transparent`.
   - Başlık tracking `-0.022em`; body'ye `text-rendering: optimizeLegibility`,
     `-moz-osx-font-smoothing`, `font-feature-settings: "cv11","ss01","tnum"`.
3. **`src/workspace.css`**: token'ları ezen üst iki blok (petrol/lacivert palet) **silindi**;
   yan menü/brand/adım kuralları `--nav-*` token'larına bağlandı; tüm sabit renkler kalktı
   (dosyada artık hex yok). Keskinleştirme: başlıklar 700, etiketler 600, 8–9px yazılar
   10–11px'e çıktı, birim rozeti çerçeveli, girdiler `--panel` zemin + `--line-strong`
   çerçeve + mavi odak, birincil buton mavi dolu, KPI üst kenarı 3px `--text`, tablo başlığı
   kalın + `--line-strong` alt çizgi, hata uyarısı `--fail`'e bağlandı. **Düzen kuralları
   (grid, genişlik, yükseklik, padding) dokunulmadı.**

## Kalan (yapılmadı)

4. **`src/theme.css` kural gövdesindeki kalan sabitler** (token blokları dışında, satır ~135+):
   - Yuvarlak köşeler: `border-radius: 8px/6px/10px/4px/3px` (≈ satır 975, 985, 1005, 1317,
     1414, 1423 civarı) → `var(--radius)` / `var(--radius-sm)`. `50%` olanlar (nokta, ikon)
     ve `100px` pill kalabilir veya `--radius`'a çekilebilir — göz kararı.
   - `background: #fff;` (≈ satır 837) → `var(--panel)`.
   - Fallback'li sabitler: `var(--bg-sunken, rgba(0,0,0,.14))`, `var(--review, #d9a441)`,
     `var(--panel-2, rgba(...))`, `box-shadow: 0 1px 2px rgba(0,0,0,.25)` (≈ satır 961–995,
     1028) → nötr token'lara bağla (`--panel-2`, gölgeyi kaldır).
   - Kart/panel/sonuç rozetleri: rozetler köşesiz, dolu zemin + kalın mono metin;
     odak halkası 2px `--accent` (mevcut `:focus-visible` zaten `--accent` kullanıyor).
   - Kontrol: `grep -n "#[0-9a-fA-F]\{3,6\}\|rgba(" src/theme.css` — token blokları dışında
     kalan olmamalı.
5. **3B görünüm sabit renkleri** (yalnız sabit değerler, mantık değişmez):
   - `src/livePreview.tsx`: `COLOR_BODY #aeb8c4 → #b8b8b8`, `COLOR_ACTIVE #f0883e → #4d8bff`,
     `COLOR_NOZZLE #9fb0c4 → #a8a8a8`, `COLOR_FLANGE #8c9bad → #8f8f8f`, mesh `#5c6672 → #5c5c5c`,
     hemisphereLight `#dfe7f0/#1a2230 → #eeeeee/#1a1a1a`, gizmo label `#e6edf5 → #fafafa`.
   - `src/viewer.tsx`: mesh `#aeb8c4 → #b8b8b8`, hemisphereLight ve gizmo aynı şekilde.
6. **Dokunulmayacaklar** (Codex aktif): `pages.tsx`, `components.tsx`, `schematic.tsx`,
   `store.ts`, `types.ts`, `vesselModel.ts` — hepsi `var(--…)` kullandığı için yeni renkleri
   otomatik alır.

## Doğrulama (henüz yapılmadı)

- `npx tsc --noEmit` → 0 hata; `npm run build` başarılı.
- `python -m pytest tests/wiring -q` (UI parity CSS'ten etkilenmemeli; Codex'in
  `Junction.cone_end` WIP kırmızısı ayrı konu).
- Dev server (`.claude/launch.json` → `web-ui`, port 5173; şu an açık) + tarayıcı:
  6 adımın her biri **açık ve koyu temada** ekran görüntüsü; `getComputedStyle` ile
  font-family Inter/JetBrains Mono ve `--bg` `#fff`/`#000` doğrula; konsol hatası yok.
  Tema `document.documentElement.setAttribute("data-theme", "light"|"dark")`.
- Kontrast AA ≥ 4.5:1: açıkta `--text-faint #6b6b6b`/beyaz ≈ 5.3:1, koyuda `#8a8a8a`/siyah
  ≈ 6.3:1; koyu tema birincil buton `#4d8bff` üzeri siyah metin (`--accent-contrast`).
- 2B şema ve 3B görünüm iki temada da okunur olmalı.
- Sonra: vault (`basincli-kap-*` sayfası + `vault/log.md`) kaydı.
