cakmacbum/bas-ncl-kap/.project-ai/paketler/T01-metamorfik.RAPOR.md

# RAPOR T01-metamorfik

> Yürütücü: Codex gpt-6-luna·medium (yaz) · 2026-10-17 18:21
> Worktree: /c/Users/yusuf/.orkestra-wt/BASINCLI-KAP/T01 · Dal: ork/T01 · Taban: 63434ed

T01 metamorfik — KISMİ  
Dosyalar: `tools/campaign/tur2/t01_metamorfik/{__init__.py,cases.py,run.py,results.json}`, `docs/validation/campaign-2026-10/tur2/T01-metamorfik.md` · Test: `python -m tools.campaign.tur2.t01_metamorfik.run` → 240 vaka kaydedildi; güvenilir ölçüm alınamadı  
Sözleşme: uyuldu · Açık soru / risk: API proje limiti ve bileşen sırası doğrulamaları nedeniyle tüm vakalar kapsam dışı; monotonluk sonucu çıkarılamadı.
```
 .../campaign-2026-10/tur2/T01-metamorfik.md        |    21 +
 .../tools/campaign/tur2/t01_metamorfik/__init__.py |     1 +
 .../tools/campaign/tur2/t01_metamorfik/cases.py    |    55 +
 .../campaign/tur2/t01_metamorfik/results.json      | 16910 +++++++++++++++++++
 .../tools/campaign/tur2/t01_metamorfik/run.py      |    57 +
 5 files changed, 17044 insertions(+)
```
