cakmacbum/bas-ncl-kap/.project-ai/paketler/T02-birim-tutarlilik.RAPOR.md

# RAPOR T02-birim-tutarlilik

> Yürütücü: Codex gpt-6-luna·medium (yaz) · 2026-10-17 18:21
> Worktree: /c/Users/yusuf/.orkestra-wt/BASINCLI-KAP/T02 · Dal: ork/T02 · Taban: 63434ed

T02 birim-tutarlılık — TAMAM
Dosyalar: `tools/campaign/tur2/t02_birim_tutarlilik/{cases.py,run.py,results.json}`, `docs/validation/campaign-2026-10/tur2/T02-birim-tutarlilik.md` · Test: `python -m tools.campaign.tur2.t02_birim_tutarlilik.run` → 21 vaka; 11 GEÇTİ, 10 BULGU · Sözleşme: uyuldu · Açık soru / risk: Imperial şeması birimleri netleştirmiyor; bulgular bu belirsizlik notuyla raporlandı.
```
 .../campaign-2026-10/tur2/T02-birim-tutarlilik.md  |  24 ++
 .../campaign/tur2/t02_birim_tutarlilik/cases.py    |  68 ++++
 .../tur2/t02_birim_tutarlilik/results.json         | 354 +++++++++++++++++++++
 .../campaign/tur2/t02_birim_tutarlilik/run.py      |  64 ++++
 4 files changed, 510 insertions(+)
```
