cakmacbum/bas-ncl-kap/.project-ai/paketler/T13-bombe-nozul.RAPOR.md

# RAPOR T13-bombe-nozul

> Yürütücü: Codex gpt-6-luna·medium (yaz) · 2026-10-17 18:23
> Worktree: /c/Users/yusuf/.orkestra-wt/BASINCLI-KAP/T13 · Dal: ork/T13 · Taban: 63434ed

T13 bombe nozul — TAMAM
Dosyalar: `tools/campaign/tur2/t13_bombe_nozul/{cases.py,run.py,results.json}` · `docs/validation/campaign-2026-10/tur2/T13-bombe-nozul.md` · Test: `python -m tools.campaign.tur2.t13_bombe_nozul.run` → 33 vaka; 30 geçti, 3 bulgu · Sözleşme: uyuldu · Açık soru / risk: 801 mm konumundaki üç nozul `PASS` aldı; YÜKSEK, emniyetsiz bulgu. \(t_r\) bağımsız hesaplandı ancak API çıktısında karşılaştırılabilir alan yok.
```
 .../campaign-2026-10/tur2/T13-bombe-nozul.md       |   30 +
 .../tools/campaign/tur2/t13_bombe_nozul/cases.py   |   42 +
 .../campaign/tur2/t13_bombe_nozul/results.json     | 3962 ++++++++++++++++++++
 .../tools/campaign/tur2/t13_bombe_nozul/run.py     |   42 +
 4 files changed, 4076 insertions(+)
```
