cakmacbum/bas-ncl-kap/.project-ai/paketler/T15-performans.RAPOR.md

# RAPOR T15-performans

> Yürütücü: Codex gpt-6-luna·medium (yaz) · 2026-10-17 18:23
> Worktree: /c/Users/yusuf/.orkestra-wt/BASINCLI-KAP/T15 · Dal: ork/T15 · Taban: 63434ed

T15 performans — TAMAM
Dosyalar: `tools/campaign/tur2/t15_performans/{__init__.py,cases.py,run.py,results.json}` · `docs/validation/campaign-2026-10/tur2/T15-performans.md`
Test: `python -m tools.campaign.tur2.t15_performans.run` → 100 vaka tamamlandı, hata %0, yanıt karışması 0
Sözleşme: uyuldu · Açık soru / risk: Yok
```
 .../campaign-2026-10/tur2/T15-performans.md        |   23 +
 .../tools/campaign/tur2/t15_performans/__init__.py |    1 +
 .../tools/campaign/tur2/t15_performans/cases.py    |   16 +
 .../campaign/tur2/t15_performans/results.json      | 2823 ++++++++++++++++++++
 .../tools/campaign/tur2/t15_performans/run.py      |  135 +
 5 files changed, 2998 insertions(+)
```
