cakmacbum/bas-ncl-kap/.project-ai/paketler/T31-mega-destek.RAPOR.md

# RAPOR T31-mega-destek

> Yürütücü: Codex gpt-6-luna·medium (yaz) · 2026-10-17 18:22
> Worktree: /c/Users/yusuf/.orkestra-wt/BASINCLI-KAP/T31 · Dal: ork/T31 · Taban: 75a631c

T31 mega destek — TAMAM
Dosyalar: `tools/campaign/tur3/mega_destek/run.py`, `tools/campaign/tur3/mega_destek/results.json`, `docs/validation/campaign-2026-10/tur3/T31-mega-destek.md` · Test: `python -m tools.campaign.tur3.mega_destek.run` → 110 vaka; 101 geçti, 9 bulgu, 0 blocked · Sözleşme: uyuldu · Açık soru / risk: 9 tutarlılık bulgusu; nozul satırı PASS ve utilization 1.5896.
```
 .../campaign-2026-10/tur3/T31-mega-destek.md       |    19 +
 .../tools/campaign/tur3/mega_destek/__init__.py    |     1 +
 .../tools/campaign/tur3/mega_destek/results.json   | 61080 +++++++++++++++++++
 .../tools/campaign/tur3/mega_destek/run.py         |   114 +
 4 files changed, 61214 insertions(+)
```
