cakmacbum/bas-ncl-kap/.project-ai/paketler/T32-mega-nozul.RAPOR.md

# RAPOR T32-mega-nozul

> Yürütücü: Codex gpt-6-luna·medium (yaz) · 2026-10-17 18:24
> Worktree: /c/Users/yusuf/.orkestra-wt/BASINCLI-KAP/T32 · Dal: ork/T32 · Taban: 75a631c

T32 mega-nozul — TAMAM
Dosyalar: `tools/campaign/tur3/mega_nozul/run.py`, `results.json`, `docs/validation/campaign-2026-10/tur3/T32-mega-nozul.md` · Test: `python -m tools.campaign.tur3.mega_nozul.run` → 110 vaka; 0 GEÇTİ, 110 BULGU, 0 BLOCKED · Sözleşme: uyuldu · Açık soru / risk: 110 vakada nozzle `PASS` utilization değeri 1.0’ı aştı (ilk değer 2.4404); raporlandı.
```
 .../campaign-2026-10/tur3/T32-mega-nozul.md        |    288 +
 .../tools/campaign/tur3/mega_nozul/__init__.py     |      1 +
 .../tools/campaign/tur3/mega_nozul/results.json    | 204382 ++++++++++++++++++
 .../tools/campaign/tur3/mega_nozul/run.py          |    185 +
 4 files changed, 204856 insertions(+)
```
