cakmacbum/bas-ncl-kap/.project-ai/paketler/T33-mega-yuk.RAPOR.md

# RAPOR T33-mega-yuk

> Yürütücü: Codex gpt-6-luna·medium (yaz) · 2026-10-17 18:23
> Worktree: /c/Users/yusuf/.orkestra-wt/BASINCLI-KAP/T33 · Dal: ork/T33 · Taban: 75a631c

T33 mega-yuk — TAMAM  
Dosyalar: `tools/campaign/tur3/mega_yuk/run.py`, `tools/campaign/tur3/mega_yuk/__init__.py`, `tools/campaign/tur3/mega_yuk/results.json`, `docs/validation/campaign-2026-10/tur3/T33-mega-yuk.md` · Test: `python -m tools.campaign.tur3.mega_yuk.run` → 110 vaka; 32 GEÇTİ, 18 BULGU, 60 BLOCKED_BEKLENEN; monotonluk bulgusu yok · Sözleşme: uyuldu · Açık soru / risk: 18 tutarlılık bulgusu raporda; BLOCKED vakalar beklenen olarak işaretlendi.
```
 .../campaign-2026-10/tur3/T33-mega-yuk.md          |    32 +
 .../tools/campaign/tur3/mega_yuk/__init__.py       |     1 +
 .../tools/campaign/tur3/mega_yuk/results.json      | 11054 +++++++++++++++++++
 .../tools/campaign/tur3/mega_yuk/run.py            |   133 +
 4 files changed, 11220 insertions(+)
```
