cakmacbum/bas-ncl-kap/.project-ai/paketler/T50-siniflandir-t01-t11.RAPOR.md

# RAPOR T50-siniflandir-t01-t11

> Yürütücü: Codex gpt-6-luna·medium (yaz) · 2026-10-17 18:41
> Worktree: /c/Users/yusuf/.orkestra-wt/BASINCLI-KAP/T50 · Dal: ork/T50 · Taban: 8a40751

T50 T01 ve T11 sınıflandırıcıları — KISMİ
Dosyalar: T01 ve T11 `classify.py`; T11 `results_v2.json` · Test: `py_compile` → geçti; T11 sınıflandırma → 144 vaka, dağılım 63 geçti / 81 kapsam dışı · Sözleşme: uyuldu · Açık soru / risk: T01’in 240 vakasını yeniden çalıştırma sınıflandırıcısı veri kodlaması nedeniyle tamamlanmadı; T01 `results_v2.json` ve istenen rapor oluşturulmadı.
```
 .../tools/campaign/tur2/t01_metamorfik/classify.py |    62 +
 .../campaign/tur2/t01_metamorfik/results_v2.json   | 53178 +++++++++++++++++++
 .../tur2/t11_yatay_tank_tarama/classify.py         |    27 +
 .../tur2/t11_yatay_tank_tarama/results_v2.json     | 10225 +++-
 4 files changed, 62266 insertions(+), 1226 deletions(-)
```
