cakmacbum/bas-ncl-kap/pressure-vessel-suite/tools/campaign/tur6/t63_dongu/ref.csv

id | kind | required_area_or_thickness | t_r_mm
T63-A-001 | nozzle | 4061.561156264729 | 11.687542174844982
T63-A-002 | nozzle | 18867.058446818035 | 32.59161614809306
T63-A-003 | nozzle | 33531.40738190229 | 38.051335238168086
T63-A-004 | nozzle | 22431.942180326412 | 46.86893750721132
T63-A-005 | nozzle | 10575.857829320044 | 22.234116939488256
T63-A-006 | nozzle | 2486.5464897736083 | 16.4852089354169
T63-A-007 | nozzle | 2918.2504701247067 | 10.594714243638295
T63-A-008 | nozzle | 1846.2591742262994 | 8.565102220426708
T63-A-009 | nozzle | 3987.9033043180607 | 34.2562175023456
T63-A-010 | nozzle | 7075.256210819288 | 24.569591797766723
T63-A-011 | nozzle | 2529.589001808429 | 9.778230053067805
T63-A-012 | nozzle | 7563.773114645042 | 22.67712346464626
T63-A-013 | nozzle | 4056.205009040146 | 23.617739245855145
T63-A-014 | nozzle | 4425.4102242277495 | 4.754134880542887
T63-A-015 | nozzle | 489.8310674839666 | 2.998751522752252
T63-A-016 | nozzle | 6231.0203894836395 | 23.25068337413156
T63-A-017 | nozzle | 2011.4299050229272 | 12.064356905220736
T63-A-018 | nozzle | 1284.678241285463 | 8.67287472344803
T63-A-019 | nozzle | 1358.743024355001 | 2.67268647796633
T63-A-020 | nozzle | 13501.863531027384 | 19.99861292624846
T63-A-021 | nozzle | 1727.739128755124 | 11.996438913457927
T63-A-022 | nozzle | 3534.289497147071 | 13.149866045864758
T63-A-023 | nozzle | 3247.629417412386 | 20.536809332492624
T63-A-024 | nozzle | 1602.9540181579039 | 12.313650016192598
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
T45-C-055 | torispherical | 104.61472960996268
T45-C-056 | torispherical | 86.6019039691489
T45-C-057 | torispherical | 16.44987633274421
T45-C-058 | torispherical | 26.956101841902708
T45-C-059 | torispherical | 5.6951590176392575
T45-C-060 | torispherical | 27.314461328841716
