cakmacbum/bas-ncl-kap/pressure-vessel-suite/docs/validation/campaign-2026-10/ozet.csv

family | case_id | quantity | unit | suite | reference | diff_pct | verdict | ref_source | note
F01-govde-ug27 | grid-01:required_thickness | required_thickness | mm | 0.15009005403241946 | 0.15009005403241946 | 0.0 | DOĞRULANDI | oracle
F01-govde-ug27 | grid-01:mawp | mawp | MPa | 12.345679012345679 | 12.345679012345679 | 0.0 | DOĞRULANDI | oracle
F01-govde-ug27 | grid-01:used_radius | used_radius | mm | 150.0 | 150.0 | 0.0 | DOĞRULANDI | oracle
F01-govde-ug27 | grid-02:required_thickness | required_thickness | mm | 1.2340216322517208 | 1.2340216322517208 | 0.0 | DOĞRULANDI | oracle
F01-govde-ug27 | grid-02:mawp | mawp | MPa | 6.4507474128018405 | 6.4507474128018405 | 0.0 | DOĞRULANDI | oracle
F01-govde-ug27 | grid-02:used_radius | used_radius | mm | 251.0 | 251.0 | 0.0 | DOĞRULANDI | oracle
F01-govde-ug27 | grid-03:required_thickness | required_thickness | mm | 4.1875 | 4.1875 | 0.0 | DOĞRULANDI | oracle
F01-govde-ug27 | grid-03:mawp | mawp | MPa | 4.212209302325581 | 4.212209302325581 | 0.0 | DOĞRULANDI | oracle
F01-govde-ug27 | grid-03:used_radius | used_radius | mm | 402.0 | 402.0 | 0.0 | DOĞRULANDI | oracle
F01-govde-ug27 | grid-04:required_thickness | required_thickness | mm | 4.388111888111888 | 4.388111888111888 | 0.0 | DOĞRULANDI | oracle
F01-govde-ug27 | grid-04:mawp | mawp | MPa | 4.183453940934871 | 3.9181515566869005 | 6.771110826358758 | SAPMA | oracle
F01-govde-ug27 | grid-04:used_radius | used_radius | mm | 502.0 | 502.0 | 0.0 | DOĞRULANDI | oracle
F01-govde-ug27 | grid-05:required_thickness | required_thickness | mm | 11.923990498812351 | 11.923990498812351 | 0.0 | DOĞRULANDI | oracle
F01-govde-ug27 | grid-05:mawp | mawp | MPa | 2.84001572327044 | 2.84001572327044 | 0.0 | DOĞRULANDI | oracle
F01-govde-ug27 | grid-05:used_radius | used_radius | mm | 753.0 | 753.0 | 0.0 | DOĞRULANDI | oracle
F01-govde-ug27 | grid-06:required_thickness | required_thickness | mm | 27.33212341197822 | 27.33212341197822 | 0.0 | DOĞRULANDI | oracle
F01-govde-ug27 | grid-06:mawp | mawp | MPa | 1.4939235253433454 | 1.2741121772677813 | 17.25211892621023 | SAPMA | oracle
F01-govde-ug27 | grid-06:used_radius | used_radius | mm | 1004.0 | 1004.0 | 0.0 | DOĞRULANDI | oracle
F01-govde-ug27 | grid-07:required_thickness | required_thickness | mm | 28.968713789107763 | 28.968713789107763 | 0.0 | DOĞRULANDI | oracle
F01-govde-ug27 | grid-07:mawp | mawp | MPa | 2.77337559429477 | 2.77337559429477 | 0.0 | DOĞRULANDI | oracle
F01-govde-ug27 | grid-07:used_radius | used_radius | mm | 1250.0 | 1250.0 | 0.0 | DOĞRULANDI | oracle
F01-govde-ug27 | grid-08:required_thickness | required_thickness | mm | 50.166666666666664 | 50.166666666666664 | 0.0 | DOĞRULANDI | oracle
F01-govde-ug27 | grid-08:mawp | mawp | MPa | 1.2644628099173554 | 1.1637674449368345 | 8.652533237513472 | SAPMA | oracle
F01-govde-ug27 | grid-08:used_radius | used_radius | mm | 1505.0 | 1505.0 | 0.0 | DOĞRULANDI | oracle
F01-govde-ug27 | grid-09:required_thickness | required_thickness | mm | 102.49027237354086 | 102.49027237354086 | 0.0 | DOĞRULANDI | oracle
F01-govde-ug27 | grid-09:mawp | mawp | MPa | 1.0553162548175017 | 1.0553162548175017 | 0.0 | DOĞRULANDI | oracle
F01-govde-ug27 | grid-09:used_radius | used_radius | mm | 1756.0 | 1756.0 | 0.0 | DOĞRULANDI | oracle
F01-govde-ug27 | grid-10:required_thickness | required_thickness | mm | 103.4020618556701 | 103.4020618556701 | 0.0 | DOĞRULANDI | oracle
F01-govde-ug27 | grid-10:mawp | mawp | MPa | 1.1426300362660837 | 0.9444748222896058 | 20.98046547139372 | SAPMA | oracle
F01-govde-ug27 | grid-10:used_radius | used_radius | mm | 2006.0 | 2006.0 | 0.0 | DOĞRULANDI | oracle
F01-govde-ug27 | thin-11:required_thickness | required_thickness | mm | 1.8150531551281144 | 1.8150531551281144 | 0.0 | DOĞRULANDI | oracle
F01-govde-ug27 | thin-11:mawp | mawp | MPa | 4.166666666666667 | 4.166666666666667 | 0.0 | DOĞRULANDI | oracle
F01-govde-ug27 | thin-11:used_radius | used_radius | mm | 600.0 | 600.0 | 0.0 | DOĞRULANDI | oracle
F01-govde-ug27 | thick-12:required_thickness | required_thickness | mm | 23.4375 | 23.4375 | 0.0 | DOĞRULANDI | oracle
F01-govde-ug27 | thick-12:mawp | mawp | MPa | 7.632398753894081 | 7.632398753894081 | 0.0 | DOĞRULANDI | oracle
F01-govde-ug27 | thick-12:used_radius | used_radius | mm | 150.0 | 150.0 | 0.0 | DOĞRULANDI | oracle
F01-govde-ug27 | mill-13:required_thickness | required_thickness | mm | 4.480712166172107 | 4.480712166172107 | 0.0 | DOĞRULANDI | oracle
F01-govde-ug27 | mill-13:mawp | mawp | MPa | 5.078702216511403 | 5.078702216511403 | 0.0 | DOĞRULANDI | oracle
F01-govde-ug27 | mill-13:used_radius | used_radius | mm | 302.0 | 302.0 | 0.0 | DOĞRULANDI | oracle
F01-govde-ug27 | mill-14:required_thickness | required_thickness | mm | 4.480712166172107 | 4.480712166172107 | 0.0 | DOĞRULANDI | oracle
F01-govde-ug27 | mill-14:mawp | mawp | MPa | 5.869565217391304 | 5.869565217391304 | 0.0 | DOĞRULANDI | oracle
F01-govde-ug27 | mill-14:used_radius | used_radius | mm | 302.0 | 302.0 | 0.0 | DOĞRULANDI | oracle
F01-govde-ug27 | ca-15:required_thickness | required_thickness | mm | 8.351648351648352 | 8.351648351648352 | 0.0 | DOĞRULANDI | oracle
F01-govde-ug27 | ca-15:mawp | mawp | MPa | 4.160206718346253 | 4.160206718346253 | 0.0 | DOĞRULANDI | oracle
F01-govde-ug27 | ca-15:used_radius | used_radius | mm | 456.0 | 456.0 | 0.0 | DOĞRULANDI | oracle
F01-govde-ug27 | ca-16:required_thickness | required_thickness | mm | 8.241758241758241 | 8.241758241758241 | 0.0 | DOĞRULANDI | oracle
F01-govde-ug27 | ca-16:mawp | mawp | MPa | 5.974025974025974 | 4.214659685863874 | 41.74397031539888 | SAPMA | oracle
F01-govde-ug27 | ca-16:used_radius | used_radius | mm | 450.0 | 450.0 | 0.0 | DOĞRULANDI | oracle
F01-govde-ug27 | eff-17:required_thickness | required_thickness | mm | 7.219020172910662 | 7.219020172910662 | 0.0 | DOĞRULANDI | oracle
F01-govde-ug27 | eff-17:mawp | mawp | MPa | 5.191256830601093 | 5.191256830601093 | 0.0 | DOĞRULANDI | oracle
F01-govde-ug27 | eff-17:used_radius | used_radius | mm | 501.0 | 501.0 | 0.0 | DOĞRULANDI | oracle
F01-govde-ug27 | eff-18:required_thickness | required_thickness | mm | 5.936018957345971 | 5.936018957345971 | 0.0 | DOĞRULANDI | oracle
F01-govde-ug27 | eff-18:mawp | mawp | MPa | 6.3036690085870415 | 6.3036690085870415 | 0.0 | DOĞRULANDI | oracle
F01-govde-ug27 | eff-18:used_radius | used_radius | mm | 501.0 | 501.0 | 0.0 | DOĞRULANDI | oracle
F01-govde-ug27 | eff-19:required_thickness | required_thickness | mm | 5.040241448692153 | 5.040241448692153 | 0.0 | DOĞRULANDI | oracle
F01-govde-ug27 | eff-19:mawp | mawp | MPa | 7.41608118657299 | 7.41608118657299 | 0.0 | DOĞRULANDI | oracle
F01-govde-ug27 | eff-19:used_radius | used_radius | mm | 501.0 | 501.0 | 0.0 | DOĞRULANDI | oracle
F01-govde-ug27 | large-20:required_thickness | required_thickness | mm | 2.8595939376608523 | 2.8595939376608523 | 0.0 | DOĞRULANDI | oracle
F01-govde-ug27 | large-20:mawp | mawp | MPa | 0.6093011688634667 | 0.6093011688634667 | 0.0 | DOĞRULANDI | oracle
F01-govde-ug27 | large-20:used_radius | used_radius | mm | 2000.0 | 2000.0 | 0.0 | DOĞRULANDI | oracle
F01-govde-ug27 | large-21:required_thickness | required_thickness | mm | 149.70149253731344 | 149.70149253731344 | 0.0 | DOĞRULANDI | oracle
F01-govde-ug27 | large-21:mawp | mawp | MPa | 0.7998410253862586 | 0.6611323756027241 | 20.980465471393707 | SAPMA | oracle
F01-govde-ug27 | large-21:used_radius | used_radius | mm | 2006.0 | 2006.0 | 0.0 | DOĞRULANDI | oracle
F01-govde-ug27 | outside-22:required_thickness | required_thickness | mm | 8.47545219638243 | 8.440999138673558 | 0.40816326530612085 | DOĞRULANDI | oracle
F01-govde-ug27 | outside-22:mawp | mawp | MPa | 4.199284009546539 | 4.2160543130990416 | -0.39777247414479544 | DOĞRULANDI | oracle
F01-govde-ug27 | outside-22:used_radius | used_radius | mm | 492.0 | 490.0 | 0.40816326530612246 | DOĞRULANDI | oracle
F01-govde-ug27 | outside-23:required_thickness | required_thickness | mm | 17.72727272727273 | 17.73845007451565 | -0.06301197227473004 | DOĞRULANDI | oracle
F01-govde-ug27 | outside-23:mawp | mawp | MPa | 2.452126336732156 | 2.2904191616766467 | 7.060156401116361 | SAPMA | oracle
F01-govde-ug27 | outside-23:used_radius | used_radius | mm | 793.0 | 793.5 | -0.0630119722747322 | DOĞRULANDI | oracle
F01-govde-ug27 | outside-24:required_thickness | required_thickness | mm | 6.911928651059085 | 6.911928651059085 | 0.0 | DOĞRULANDI | oracle
F01-govde-ug27 | outside-24:mawp | mawp | MPa | 2.8753993610223643 | 2.8753993610223643 | 0.0 | DOĞRULANDI | oracle
F01-govde-ug27 | outside-24:used_radius | used_radius | mm | 1240.0 | 1240.0 | 0.0 | DOĞRULANDI | oracle
F01-govde-ug27 | medium-25:required_thickness | required_thickness | mm | 28.904876099120706 | 28.904876099120706 | 0.0 | DOĞRULANDI | oracle
F01-govde-ug27 | medium-25:mawp | mawp | MPa | 1.8871286043197018 | 1.60967175321111 | 17.236859040055666 | SAPMA | oracle
F01-govde-ug27 | medium-25:used_radius | used_radius | mm | 904.0 | 904.0 | 0.0 | DOĞRULANDI | oracle
F01-govde-ug27 | medium-26:required_thickness | required_thickness | mm | 38.576429404900814 | 38.576429404900814 | 0.0 | DOĞRULANDI | oracle
F01-govde-ug27 | medium-26:mawp | mawp | MPa | 2.8306973400431343 | 2.8306973400431343 | 0.0 | DOĞRULANDI | oracle
F01-govde-ug27 | medium-26:used_radius | used_radius | mm | 1102.0 | 1102.0 | 0.0 | DOĞRULANDI | oracle
F01-govde-ug27 | medium-27:required_thickness | required_thickness | mm | 3.930998431782541 | 3.930998431782541 | 0.0 | DOĞRULANDI | oracle
F01-govde-ug27 | medium-27:mawp | mawp | MPa | 3.2923037056232185 | 3.0975862963924214 | 6.286101196198249 | SAPMA | oracle
F01-govde-ug27 | medium-27:used_radius | used_radius | mm | 376.0 | 376.0 | 0.0 | DOĞRULANDI | oracle
F01-govde-ug27 | medium-28:required_thickness | required_thickness | mm | 10.33083531347103 | 10.33083531347103 | 0.0 | DOĞRULANDI | oracle
F01-govde-ug27 | medium-28:mawp | mawp | MPa | 2.9434346599811967 | 2.9434346599811967 | 0.0 | DOĞRULANDI | oracle
F01-govde-ug27 | medium-28:used_radius | used_radius | mm | 628.0 | 628.0 | 0.0 | DOĞRULANDI | oracle
F01-govde-ug27 | invalid-p-29:required_thickness | required_thickness | mm |  |  |  | KAPSAM_DIŞI | oracle | API result missing or case intentionally invalid
F01-govde-ug27 | invalid-p-29:mawp | mawp | MPa |  |  |  | KAPSAM_DIŞI | oracle | API result missing or case intentionally invalid
F01-govde-ug27 | invalid-p-29:used_radius | used_radius | mm |  |  |  | KAPSAM_DIŞI | oracle | API result missing or case intentionally invalid
F01-govde-ug27 | invalid-d-30:required_thickness | required_thickness | mm |  |  |  | KAPSAM_DIŞI | oracle | API result missing or case intentionally invalid
F01-govde-ug27 | invalid-d-30:mawp | mawp | MPa |  |  |  | KAPSAM_DIŞI | oracle | API result missing or case intentionally invalid
F01-govde-ug27 | invalid-d-30:used_radius | used_radius | mm |  |  |  | KAPSAM_DIŞI | oracle | API result missing or case intentionally invalid
F01-govde-ug27 | invalid-s-31:required_thickness | required_thickness | mm |  |  |  | KAPSAM_DIŞI | oracle | API result missing or case intentionally invalid
F01-govde-ug27 | invalid-s-31:mawp | mawp | MPa |  |  |  | KAPSAM_DIŞI | oracle | API result missing or case intentionally invalid
F01-govde-ug27 | invalid-s-31:used_radius | used_radius | mm |  |  |  | KAPSAM_DIŞI | oracle | API result missing or case intentionally invalid
F01-govde-ug27 | missing-mat-32:required_thickness | required_thickness | mm |  |  |  | KAPSAM_DIŞI | oracle | API result missing or case intentionally invalid
F01-govde-ug27 | missing-mat-32:mawp | mawp | MPa |  |  |  | KAPSAM_DIŞI | oracle | API result missing or case intentionally invalid
F01-govde-ug27 | missing-mat-32:used_radius | used_radius | mm |  |  |  | KAPSAM_DIŞI | oracle | API result missing or case intentionally invalid
F01-govde-ug27 | K1-16 | required_thickness | in |  | 0.2437 |  | TEK_KAYNAK | PVEng PVE-6847, pp.15-16; App.1-1(a)(1) outer-radius alternate; 0.2437 in | Published anchor recorded; no matching independently runnable source case.
F01-govde-ug27 | K1-18 | required_thickness | in |  | 0.127 |  | TEK_KAYNAK | PVEng PVE-3247, p.2; UG-27(c)(1), CA case; 0.127 in | Published anchor recorded; no matching independently runnable source case.
F02-bombe_eliptik | BASE | required_thickness | mm | 3.412386964681795 | 3.412386964681795 | 0.0 | DOĞRULANDI | independent UG-32(d) equation
F02-bombe_eliptik | BASE | mawp | MPa | 2.8084596967278532 | 2.8084596967278532 | 0.0 | DOĞRULANDI | independent UG-32(d) equation
F02-bombe_eliptik | D300 | required_thickness | mm | 0.8700696055684456 | 0.8700696055684456 | 0.0 | DOĞRULANDI | independent UG-32(d) equation
F02-bombe_eliptik | D300 | mawp | MPa | 7.320954907161803 | 7.320954907161803 | 0.0 | DOĞRULANDI | independent UG-32(d) equation
F02-bombe_eliptik | D4000 | required_thickness | mm | 13.64954785872718 | 13.64954785872718 | 0.0 | DOĞRULANDI | independent UG-32(d) equation
F02-bombe_eliptik | D4000 | mawp | MPa | 1.1718281718281718 | 1.1718281718281718 | 0.0 | DOĞRULANDI | independent UG-32(d) equation
F02-bombe_eliptik | P01 | required_thickness | mm | 0.3623450974708312 | 0.3623450974708312 | 0.0 | DOĞRULANDI | independent UG-32(d) equation
F02-bombe_eliptik | P01 | mawp | MPa | 2.754491017964072 | 2.754491017964072 | 0.0 | DOĞRULANDI | independent UG-32(d) equation
F02-bombe_eliptik | P6 | required_thickness | mm | 25.70694087403599 | 25.70694087403599 | 0.0 | DOĞRULANDI | independent UG-32(d) equation
F02-bombe_eliptik | P6 | mawp | MPa | 6.996023856858847 | 6.996023856858847 | 0.0 | DOĞRULANDI | independent UG-32(d) equation
F02-bombe_eliptik | CA1 | required_thickness | mm | 3.4283387544787574 | 3.412386964681795 | 0.4674671999999809 | DOĞRULANDI | independent UG-32(d) equation
F02-bombe_eliptik | CA1 | mawp | MPa | 2.569806811392153 | 2.5749351426860905 | -0.19916351324437342 | DOĞRULANDI | independent UG-32(d) equation
F02-bombe_eliptik | CA3 | required_thickness | mm | 2.9410445011600936 | 2.900232018561485 | 1.4072144000000204 | SAPMA | independent UG-32(d) equation
F02-bombe_eliptik | CA3 | mawp | MPa | 3.0113072803015273 | 3.029335461983636 | -0.5951200158698704 | DOĞRULANDI | independent UG-32(d) equation
F02-bombe_eliptik | MILL125 | required_thickness | mm | 3.412386964681795 | 3.412386964681795 | 0.0 | DOĞRULANDI | independent UG-32(d) equation
F02-bombe_eliptik | MILL125 | mawp | MPa | 2.4581379103881846 | 2.4581379103881846 | 0.0 | DOĞRULANDI | independent UG-32(d) equation
F02-bombe_eliptik | MILL3 | required_thickness | mm | 2.900232018561485 | 2.900232018561485 | 0.0 | DOĞRULANDI | independent UG-32(d) equation
F02-bombe_eliptik | MILL3 | mawp | MPa | 3.205178344813275 | 3.205178344813275 | 0.0 | DOĞRULANDI | independent UG-32(d) equation
F02-bombe_eliptik | FORM1 | required_thickness | mm | 3.412386964681795 | 3.412386964681795 | 0.0 | DOĞRULANDI | independent UG-32(d) equation
F02-bombe_eliptik | FORM1 | mawp | MPa | 2.5749351426860905 | 2.5749351426860905 | 0.0 | DOĞRULANDI | independent UG-32(d) equation
F02-bombe_eliptik | FORM3 | required_thickness | mm | 3.412386964681795 | 3.412386964681795 | 0.0 | DOĞRULANDI | independent UG-32(d) equation
F02-bombe_eliptik | FORM3 | mawp | MPa | 2.8084596967278532 | 2.8084596967278532 | 0.0 | DOĞRULANDI | independent UG-32(d) equation
F02-bombe_eliptik | FLANGE0 | required_thickness | mm | 3.412386964681795 | 3.412386964681795 | 0.0 | DOĞRULANDI | independent UG-32(d) equation
F02-bombe_eliptik | FLANGE0 | mawp | MPa | 2.8084596967278532 | 2.8084596967278532 | 0.0 | DOĞRULANDI | independent UG-32(d) equation
F02-bombe_eliptik | FLANGE100 | required_thickness | mm | 3.412386964681795 | 3.412386964681795 | 0.0 | DOĞRULANDI | independent UG-32(d) equation
F02-bombe_eliptik | FLANGE100 | mawp | MPa | 2.8084596967278532 | 2.8084596967278532 | 0.0 | DOĞRULANDI | independent UG-32(d) equation
F02-bombe_eliptik | E70 | required_thickness | mm | 4.144218814753419 | 4.144218814753419 | 0.0 | DOĞRULANDI | independent UG-32(d) equation
F02-bombe_eliptik | E70 | mawp | MPa | 2.312849162011173 | 2.312849162011173 | 0.0 | DOĞRULANDI | independent UG-32(d) equation
F02-bombe_eliptik | E100 | required_thickness | mm | 2.900232018561485 | 2.900232018561485 | 0.0 | DOĞRULANDI | independent UG-32(d) equation
F02-bombe_eliptik | E100 | mawp | MPa | 3.304070231444533 | 3.304070231444533 | 0.0 | DOĞRULANDI | independent UG-32(d) equation
F02-bombe_eliptik | SMALL_LOW | required_thickness | mm | 0.15529557925251064 | 0.15529557925251064 | 0.0 | DOĞRULANDI | independent UG-32(d) equation
F02-bombe_eliptik | SMALL_LOW | mawp | MPa | 3.2093023255813953 | 3.2093023255813953 | 0.0 | DOĞRULANDI | independent UG-32(d) equation
F02-bombe_eliptik | SMALL_HIGH | required_thickness | mm | 7.832735028087213 | 7.712082262210797 | 1.5644641975308644 | SAPMA | independent UG-32(d) equation
F02-bombe_eliptik | SMALL_HIGH | mawp | MPa | 16.278367346938776 | 16.385373870172554 | -0.6530612244897855 | DOĞRULANDI | independent UG-32(d) equation
F02-bombe_eliptik | LARGE_LOW | required_thickness | mm | 1.4544597467207772 | 1.4493803898833248 | 0.35045022500002204 | DOĞRULANDI | independent UG-32(d) equation
F02-bombe_eliptik | LARGE_LOW | mawp | MPa | 0.4907141119297304 | 0.491449920965656 | -0.14972207839198992 | DOĞRULANDI | independent UG-32(d) equation
F02-bombe_eliptik | LARGE_HIGH | required_thickness | mm | 125.0 | 125.0 | 0.0 | DOĞRULANDI | independent UG-32(d) equation
F02-bombe_eliptik | LARGE_HIGH | mawp | MPa | 1.9281437125748504 | 1.9281437125748504 | 0.0 | DOĞRULANDI | independent UG-32(d) equation
F02-bombe_eliptik | MID1 | required_thickness | mm | 10.896822519045985 | 10.882708585247885 | 0.12969136945587645 | DOĞRULANDI | independent UG-32(d) equation
F02-bombe_eliptik | MID1 | mawp | MPa | 2.216603296715478 | 2.217832544004614 | -0.055425613284408655 | DOĞRULANDI | independent UG-32(d) equation
F02-bombe_eliptik | MID2 | required_thickness | mm | 32.17110436102564 | 32.05128205128205 | 0.37384560640000075 | DOĞRULANDI | independent UG-32(d) equation
F02-bombe_eliptik | MID2 | mawp | MPa | 1.777414466863386 | 1.7802540138988734 | -0.15950235265969678 | DOĞRULANDI | independent UG-32(d) equation
F02-bombe_eliptik | MID3 | required_thickness | mm | 5.995261547999978 | 5.987806648279867 | 0.12450134344689501 | DOĞRULANDI | independent UG-32(d) equation
F02-bombe_eliptik | MID3 | mawp | MPa | 3.9060236801190658 | 3.9081009931793713 | -0.053154027081976696 | DOĞRULANDI | independent UG-32(d) equation
F02-bombe_eliptik | MID4 | required_thickness | mm | 7.750134429090896 | 7.7332044465925565 | 0.21892583618165615 | DOĞRULANDI | independent UG-32(d) equation
F02-bombe_eliptik | MID4 | mawp | MPa | 1.2086384789090865 | 1.2097704737880568 | -0.09357104537572207 | DOĞRULANDI | independent UG-32(d) equation
F02-bombe_eliptik | MID5 | required_thickness | mm | 24.069319640564828 | 24.069319640564828 | 0.0 | DOĞRULANDI | independent UG-32(d) equation
F02-bombe_eliptik | MID5 | mawp | MPa | 5.017652166293603 | 5.017652166293603 | 0.0 | DOĞRULANDI | independent UG-32(d) equation
F02-bombe_eliptik | MID6 | required_thickness | mm | 2.003704847940772 | 1.9931146946910674 | 0.5313368707738255 | DOĞRULANDI | independent UG-32(d) equation
F02-bombe_eliptik | MID6 | mawp | MPa | 1.063125934653555 | 1.065540264341191 | -0.22658268001995618 | DOĞRULANDI | independent UG-32(d) equation
F02-bombe_eliptik | MID7 | required_thickness | mm | 23.534744072318357 | 23.41311134235172 | 0.5195069044352858 | DOĞRULANDI | independent UG-32(d) equation
F02-bombe_eliptik | MID7 | mawp | MPa | 6.303989867004432 | 6.317907111515853 | -0.22028251232205767 | DOĞRULANDI | independent UG-32(d) equation
F02-bombe_eliptik | MID8 | required_thickness | mm | 29.918883739521426 | 29.888983774551665 | 0.10003673994168719 | DOĞRULANDI | independent UG-32(d) equation
F02-bombe_eliptik | MID8 | mawp | MPa | 1.2294973088354526 | 1.2300236837102991 | -0.042793881273793334 | DOĞRULANDI | independent UG-32(d) equation
F02-bombe_eliptik | MID9 | required_thickness | mm | 5.852230080674402 | 5.8013052936910805 | 0.8778160156250022 | DOĞRULANDI | independent UG-32(d) equation
F02-bombe_eliptik | MID9 | mawp | MPa | 1.9049632512964643 | 1.9120969654604236 | -0.37308328462524365 | DOĞRULANDI | independent UG-32(d) equation
F02-bombe_eliptik | MID10 | required_thickness | mm | 39.58047621465698 | 39.56398869600323 | 0.041673044597295324 | DOĞRULANDI | independent UG-32(d) equation
F02-bombe_eliptik | MID10 | mawp | MPa | 2.3434179415880143 | 2.3438356193682375 | -0.01782026763189779 | DOĞRULANDI | independent UG-32(d) equation
F02-bombe_eliptik | K1-19 | required_thickness | mm | 2.663728003716395 | 2.656696862116569 | 0.26465727799386346 | DOĞRULANDI | K1-19 (PVE-3247 p.3; sources-K1.md) | Compared pressure thickness before CA: source reports 0.115 in including 0.010 in CA; source MAWP 341.3 psi recalculates to 342.3 psi.
F02-bombe_eliptik | K1-19 | mawp | MPa | 2.358508042653172 | 2.361175193377663 | -0.11295861196455743 | DOĞRULANDI | independent UG-32(d) equation
F02-bombe_eliptik | INVALID-MATERIAL | required_thickness | mm |  | 3.412386964681795 |  | KAPSAM_DIŞI | independent UG-32(d) equation
F02-bombe_eliptik | INVALID-MATERIAL | mawp | MPa |  | 2.8084596967278532 |  | KAPSAM_DIŞI | independent UG-32(d) equation
F03-bombe-torisferik | STD-r006 | required_thickness | mm | 8.104727239871146 | 8.104727239871146 | 0.0 | DOĞRULANDI | UG-32(e)/Appendix 1-4(d) independent equation | r < 0.06L boundary violation probe
F03-bombe-torisferik | STD-r006 | mawp | MPa | 2.9574602775693393 | 2.9574602775693393 | 0.0 | DOĞRULANDI | UG-32(e)/Appendix 1-4(d) independent equation | r < 0.06L boundary violation probe
F03-bombe-torisferik | STD-r006 | M | dimensionless | 1.7908329997330663 | 1.7908329997330663 | 0.0 | DOĞRULANDI | UG-32(e)/Appendix 1-4(d) independent equation | r < 0.06L boundary violation probe
F03-bombe-torisferik | STD-r010 | required_thickness | mm | 7.042971304713007 | 7.042971304713007 | 0.0 | DOĞRULANDI | UG-32(e)/Appendix 1-4(d) independent equation
F03-bombe-torisferik | STD-r010 | mawp | MPa | 3.402209994379428 | 3.402209994379428 | 0.0 | DOĞRULANDI | UG-32(e)/Appendix 1-4(d) independent equation
F03-bombe-torisferik | STD-r010 | M | dimensionless | 1.556225774829855 | 1.556225774829855 | 0.0 | DOĞRULANDI | UG-32(e)/Appendix 1-4(d) independent equation
F03-bombe-torisferik | STD-r015 | required_thickness | mm | 6.37341954807902 | 6.37341954807902 | 0.0 | DOĞRULANDI | UG-32(e)/Appendix 1-4(d) independent equation
F03-bombe-torisferik | STD-r015 | mawp | MPa | 3.7586515063666255 | 3.7586515063666255 | 0.0 | DOĞRULANDI | UG-32(e)/Appendix 1-4(d) independent equation
F03-bombe-torisferik | STD-r015 | M | dimensionless | 1.4082805886043834 | 1.4082805886043834 | 0.0 | DOĞRULANDI | UG-32(e)/Appendix 1-4(d) independent equation
F03-bombe-torisferik | STD-r0059 | required_thickness | mm | 8.14447875783118 | 8.14447875783118 | 0.0 | DOĞRULANDI | UG-32(e)/Appendix 1-4(d) independent equation | r < 0.06L boundary violation probe
F03-bombe-torisferik | STD-r0059 | mawp | MPa | 2.943056309308966 | 2.943056309308966 | 0.0 | DOĞRULANDI | UG-32(e)/Appendix 1-4(d) independent equation | r < 0.06L boundary violation probe
F03-bombe-torisferik | STD-r0059 | M | dimensionless | 1.7996165562976973 | 1.7996165562976973 | 0.0 | DOĞRULANDI | UG-32(e)/Appendix 1-4(d) independent equation | r < 0.06L boundary violation probe
F03-bombe-torisferik | STD-L080 | required_thickness | mm | 5.401584453951244 | 5.401584453951244 | 0.0 | DOĞRULANDI | UG-32(e)/Appendix 1-4(d) independent equation | r < 0.06L boundary violation probe
F03-bombe-torisferik | STD-L080 | mawp | MPa | 2.9574602775693393 | 2.9574602775693393 | 0.0 | DOĞRULANDI | UG-32(e)/Appendix 1-4(d) independent equation | r < 0.06L boundary violation probe
F03-bombe-torisferik | STD-L080 | M | dimensionless | 1.7908329997330663 | 1.7908329997330663 | 0.0 | DOĞRULANDI | UG-32(e)/Appendix 1-4(d) independent equation | r < 0.06L boundary violation probe
F03-bombe-torisferik | STD-L090 | required_thickness | mm | 6.07722314462385 | 6.07722314462385 | 0.0 | DOĞRULANDI | UG-32(e)/Appendix 1-4(d) independent equation | r < 0.06L boundary violation probe
F03-bombe-torisferik | STD-L090 | mawp | MPa | 2.9574602775693393 | 2.9574602775693393 | 0.0 | DOĞRULANDI | UG-32(e)/Appendix 1-4(d) independent equation | r < 0.06L boundary violation probe
F03-bombe-torisferik | STD-L090 | M | dimensionless | 1.7908329997330663 | 1.7908329997330663 | 0.0 | DOĞRULANDI | UG-32(e)/Appendix 1-4(d) independent equation | r < 0.06L boundary violation probe
F03-bombe-torisferik | STD-L100 | required_thickness | mm | 6.752959824954274 | 6.752959824954274 | 0.0 | DOĞRULANDI | UG-32(e)/Appendix 1-4(d) independent equation | r < 0.06L boundary violation probe
F03-bombe-torisferik | STD-L100 | mawp | MPa | 2.9574602775693393 | 2.9574602775693393 | 0.0 | DOĞRULANDI | UG-32(e)/Appendix 1-4(d) independent equation | r < 0.06L boundary violation probe
F03-bombe-torisferik | STD-L100 | M | dimensionless | 1.7908329997330663 | 1.7908329997330663 | 0.0 | DOĞRULANDI | UG-32(e)/Appendix 1-4(d) independent equation | r < 0.06L boundary violation probe
F03-bombe-torisferik | STD-D500 | required_thickness | mm | 4.254815025070076 | 4.254815025070076 | 0.0 | DOĞRULANDI | UG-32(e)/Appendix 1-4(d) independent equation | r < 0.06L boundary violation probe
F03-bombe-torisferik | STD-D500 | mawp | MPa | 5.622575496776688 | 5.622575496776688 | 0.0 | DOĞRULANDI | UG-32(e)/Appendix 1-4(d) independent equation | r < 0.06L boundary violation probe
F03-bombe-torisferik | STD-D500 | M | dimensionless | 1.8106601717798212 | 1.8106601717798212 | 0.0 | DOĞRULANDI | UG-32(e)/Appendix 1-4(d) independent equation | r < 0.06L boundary violation probe
F03-bombe-torisferik | STD-D2000 | required_thickness | mm | 15.808458960248071 | 15.808458960248071 | 0.0 | DOĞRULANDI | UG-32(e)/Appendix 1-4(d) independent equation | r < 0.06L boundary violation probe
F03-bombe-torisferik | STD-D2000 | mawp | MPa | 1.5178245941294157 | 1.5178245941294157 | 0.0 | DOĞRULANDI | UG-32(e)/Appendix 1-4(d) independent equation | r < 0.06L boundary violation probe
F03-bombe-torisferik | STD-D2000 | M | dimensionless | 1.7807764064044151 | 1.7807764064044151 | 0.0 | DOĞRULANDI | UG-32(e)/Appendix 1-4(d) independent equation | r < 0.06L boundary violation probe
F03-bombe-torisferik | STD-P060 | required_thickness | mm | 4.050600956334034 | 4.050600956334034 | 0.0 | DOĞRULANDI | UG-32(e)/Appendix 1-4(d) independent equation | r < 0.06L boundary violation probe
F03-bombe-torisferik | STD-P060 | mawp | MPa | 2.9574602775693393 | 2.9574602775693393 | 0.0 | DOĞRULANDI | UG-32(e)/Appendix 1-4(d) independent equation | r < 0.06L boundary violation probe
F03-bombe-torisferik | STD-P060 | M | dimensionless | 1.7908329997330663 | 1.7908329997330663 | 0.0 | DOĞRULANDI | UG-32(e)/Appendix 1-4(d) independent equation | r < 0.06L boundary violation probe
F03-bombe-torisferik | STD-P180 | required_thickness | mm | 12.16238345486976 | 12.16238345486976 | 0.0 | DOĞRULANDI | UG-32(e)/Appendix 1-4(d) independent equation | r < 0.06L boundary violation probe
F03-bombe-torisferik | STD-P180 | mawp | MPa | 2.9574602775693393 | 2.9574602775693393 | 0.0 | DOĞRULANDI | UG-32(e)/Appendix 1-4(d) independent equation | r < 0.06L boundary violation probe
F03-bombe-torisferik | STD-P180 | M | dimensionless | 1.7908329997330663 | 1.7908329997330663 | 0.0 | DOĞRULANDI | UG-32(e)/Appendix 1-4(d) independent equation | r < 0.06L boundary violation probe
F03-bombe-torisferik | STD-P300 | required_thickness | mm | 20.28830413640947 | 20.28830413640947 | 0.0 | DOĞRULANDI | UG-32(e)/Appendix 1-4(d) independent equation | r < 0.06L boundary violation probe
F03-bombe-torisferik | STD-P300 | mawp | MPa | 2.9574602775693393 | 2.9574602775693393 | 0.0 | DOĞRULANDI | UG-32(e)/Appendix 1-4(d) independent equation | r < 0.06L boundary violation probe
F03-bombe-torisferik | STD-P300 | M | dimensionless | 1.7908329997330663 | 1.7908329997330663 | 0.0 | DOĞRULANDI | UG-32(e)/Appendix 1-4(d) independent equation | r < 0.06L boundary violation probe
F03-bombe-torisferik | CUS-01 | required_thickness | mm | 5.788932738643262 | 5.788932738643262 | 0.0 | DOĞRULANDI | UG-32(e)/Appendix 1-4(d) independent equation
F03-bombe-torisferik | CUS-01 | mawp | MPa | 4.137010771817869 | 4.137010771817869 | 0.0 | DOĞRULANDI | UG-32(e)/Appendix 1-4(d) independent equation
F03-bombe-torisferik | CUS-01 | M | dimensionless | 1.662870929175277 | 1.662870929175277 | 0.0 | DOĞRULANDI | UG-32(e)/Appendix 1-4(d) independent equation
F03-bombe-torisferik | CUS-02 | required_thickness | mm | 6.729422336364965 | 6.729422336364965 | 0.0 | DOĞRULANDI | UG-32(e)/Appendix 1-4(d) independent equation
F03-bombe-torisferik | CUS-02 | mawp | MPa | 3.5603227120931966 | 3.5603227120931966 | 0.0 | DOĞRULANDI | UG-32(e)/Appendix 1-4(d) independent equation
F03-bombe-torisferik | CUS-02 | M | dimensionless | 1.7182458365518543 | 1.7182458365518543 | 0.0 | DOĞRULANDI | UG-32(e)/Appendix 1-4(d) independent equation
F03-bombe-torisferik | CUS-03 | required_thickness | mm | 7.705051027674751 | 7.705051027674751 | 0.0 | DOĞRULANDI | UG-32(e)/Appendix 1-4(d) independent equation
F03-bombe-torisferik | CUS-03 | mawp | MPa | 3.110523797355549 | 3.110523797355549 | 0.0 | DOĞRULANDI | UG-32(e)/Appendix 1-4(d) independent equation
F03-bombe-torisferik | CUS-03 | M | dimensionless | 1.7706207261596576 | 1.7706207261596576 | 0.0 | DOĞRULANDI | UG-32(e)/Appendix 1-4(d) independent equation
F03-bombe-torisferik | CUS-04 | required_thickness | mm | 5.07260846366074 | 5.07260846366074 | 0.0 | DOĞRULANDI | UG-32(e)/Appendix 1-4(d) independent equation
F03-bombe-torisferik | CUS-04 | mawp | MPa | 4.719217562482286 | 4.719217562482286 | 0.0 | DOĞRULANDI | UG-32(e)/Appendix 1-4(d) independent equation
F03-bombe-torisferik | CUS-04 | M | dimensionless | 1.4571067811865475 | 1.4571067811865475 | 0.0 | DOĞRULANDI | UG-32(e)/Appendix 1-4(d) independent equation
F03-bombe-torisferik | CUS-05 | required_thickness | mm | 5.87467362924282 | 5.87467362924282 | 0.0 | DOĞRULANDI | UG-32(e)/Appendix 1-4(d) independent equation
F03-bombe-torisferik | CUS-05 | mawp | MPa | 4.0768094534711965 | 4.0768094534711965 | 0.0 | DOĞRULANDI | UG-32(e)/Appendix 1-4(d) independent equation
F03-bombe-torisferik | CUS-05 | M | dimensionless | 1.5 | 1.5 | 0.0 | DOĞRULANDI | UG-32(e)/Appendix 1-4(d) independent equation
F03-bombe-torisferik | CUS-06 | required_thickness | mm | 6.703957419678394 | 6.703957419678394 | 0.0 | DOĞRULANDI | UG-32(e)/Appendix 1-4(d) independent equation
F03-bombe-torisferik | CUS-06 | mawp | MPa | 3.57381154012399 | 3.57381154012399 | 0.0 | DOĞRULANDI | UG-32(e)/Appendix 1-4(d) independent equation
F03-bombe-torisferik | CUS-06 | M | dimensionless | 1.540569415042095 | 1.540569415042095 | 0.0 | DOĞRULANDI | UG-32(e)/Appendix 1-4(d) independent equation
F03-bombe-torisferik | CUS-07 | required_thickness | mm | 4.620888665586165 | 4.620888665586165 | 0.0 | DOĞRULANDI | UG-32(e)/Appendix 1-4(d) independent equation
F03-bombe-torisferik | CUS-07 | mawp | MPa | 5.178818332957429 | 5.178818332957429 | 0.0 | DOĞRULANDI | UG-32(e)/Appendix 1-4(d) independent equation
F03-bombe-torisferik | CUS-07 | M | dimensionless | 1.3273502691896257 | 1.3273502691896257 | 0.0 | DOĞRULANDI | UG-32(e)/Appendix 1-4(d) independent equation
F03-bombe-torisferik | CUS-08 | required_thickness | mm | 5.335662280792929 | 5.335662280792929 | 0.0 | DOĞRULANDI | UG-32(e)/Appendix 1-4(d) independent equation
F03-bombe-torisferik | CUS-08 | mawp | MPa | 4.4873116673127695 | 4.4873116673127695 | 0.0 | DOĞRULANDI | UG-32(e)/Appendix 1-4(d) independent equation
F03-bombe-torisferik | CUS-08 | M | dimensionless | 1.3623724356957945 | 1.3623724356957945 | 0.0 | DOĞRULANDI | UG-32(e)/Appendix 1-4(d) independent equation
F03-bombe-torisferik | CUS-09 | required_thickness | mm | 6.072659810130125 | 6.072659810130125 | 0.0 | DOĞRULANDI | UG-32(e)/Appendix 1-4(d) independent equation
F03-bombe-torisferik | CUS-09 | mawp | MPa | 3.944273631906033 | 3.944273631906033 | 0.0 | DOĞRULANDI | UG-32(e)/Appendix 1-4(d) independent equation
F03-bombe-torisferik | CUS-09 | M | dimensionless | 1.3954972243679027 | 1.3954972243679027 | 0.0 | DOĞRULANDI | UG-32(e)/Appendix 1-4(d) independent equation
F03-bombe-torisferik | CUS-10 | required_thickness | mm | 6.761423625415845 | 6.761423625415845 | 0.0 | DOĞRULANDI | UG-32(e)/Appendix 1-4(d) independent equation
F03-bombe-torisferik | CUS-10 | mawp | MPa | 3.543515251938834 | 3.543515251938834 | 0.0 | DOĞRULANDI | UG-32(e)/Appendix 1-4(d) independent equation
F03-bombe-torisferik | CUS-10 | M | dimensionless | 1.726416832356179 | 1.726416832356179 | 0.0 | DOĞRULANDI | UG-32(e)/Appendix 1-4(d) independent equation
F03-bombe-torisferik | CUS-11 | required_thickness | mm | 3.3632476139553478 | 3.3632476139553478 | 0.0 | DOĞRULANDI | UG-32(e)/Appendix 1-4(d) independent equation
F03-bombe-torisferik | CUS-11 | mawp | MPa | 3.5603227120931966 | 3.5603227120931966 | 0.0 | DOĞRULANDI | UG-32(e)/Appendix 1-4(d) independent equation
F03-bombe-torisferik | CUS-11 | M | dimensionless | 1.7182458365518543 | 1.7182458365518543 | 0.0 | DOĞRULANDI | UG-32(e)/Appendix 1-4(d) independent equation
F03-bombe-torisferik | CUS-12 | required_thickness | mm | 10.098527990182863 | 10.098527990182863 | 0.0 | DOĞRULANDI | UG-32(e)/Appendix 1-4(d) independent equation
F03-bombe-torisferik | CUS-12 | mawp | MPa | 3.5603227120931966 | 3.5603227120931966 | 0.0 | DOĞRULANDI | UG-32(e)/Appendix 1-4(d) independent equation
F03-bombe-torisferik | CUS-12 | M | dimensionless | 1.7182458365518543 | 1.7182458365518543 | 0.0 | DOĞRULANDI | UG-32(e)/Appendix 1-4(d) independent equation
F03-bombe-torisferik | CUS-13 | required_thickness | mm | 2.93733681462141 | 2.93733681462141 | 0.0 | DOĞRULANDI | UG-32(e)/Appendix 1-4(d) independent equation
F03-bombe-torisferik | CUS-13 | mawp | MPa | 8.12960235640648 | 8.12960235640648 | 0.0 | DOĞRULANDI | UG-32(e)/Appendix 1-4(d) independent equation
F03-bombe-torisferik | CUS-13 | M | dimensionless | 1.5 | 1.5 | 0.0 | DOĞRULANDI | UG-32(e)/Appendix 1-4(d) independent equation
F03-bombe-torisferik | CUS-14 | required_thickness | mm | 11.74934725848564 | 11.74934725848564 | 0.0 | DOĞRULANDI | UG-32(e)/Appendix 1-4(d) independent equation
F03-bombe-torisferik | CUS-14 | mawp | MPa | 2.0414201183431953 | 2.0414201183431953 | 0.0 | DOĞRULANDI | UG-32(e)/Appendix 1-4(d) independent equation
F03-bombe-torisferik | CUS-14 | M | dimensionless | 1.5 | 1.5 | 0.0 | DOĞRULANDI | UG-32(e)/Appendix 1-4(d) independent equation
F03-bombe-torisferik | CUS-15 | required_thickness | mm | 16.84554741717504 | 16.84554741717504 | 0.0 | DOĞRULANDI | UG-32(e)/Appendix 1-4(d) independent equation
F03-bombe-torisferik | CUS-15 | mawp | MPa | 3.5603227120931966 | 3.5603227120931966 | 0.0 | DOĞRULANDI | UG-32(e)/Appendix 1-4(d) independent equation
F03-bombe-torisferik | CUS-15 | M | dimensionless | 1.7182458365518543 | 1.7182458365518543 | 0.0 | DOĞRULANDI | UG-32(e)/Appendix 1-4(d) independent equation
F03-bombe-torisferik | CUS-16 | required_thickness | mm | 1.5175045937015035 | 1.5175045937015035 | 0.0 | DOĞRULANDI | UG-32(e)/Appendix 1-4(d) independent equation
F03-bombe-torisferik | CUS-16 | mawp | MPa | 7.866064719131966 | 7.866064719131966 | 0.0 | DOĞRULANDI | UG-32(e)/Appendix 1-4(d) independent equation
F03-bombe-torisferik | CUS-16 | M | dimensionless | 1.3954972243679027 | 1.3954972243679027 | 0.0 | DOĞRULANDI | UG-32(e)/Appendix 1-4(d) independent equation
F03-bombe-torisferik | CUS-17 | required_thickness | mm | 17.63169351327819 | 17.63169351327819 | 0.0 | DOĞRULANDI | UG-32(e)/Appendix 1-4(d) independent equation
F03-bombe-torisferik | CUS-17 | mawp | MPa | 2.0414201183431953 | 2.0414201183431953 | 0.0 | DOĞRULANDI | UG-32(e)/Appendix 1-4(d) independent equation
F03-bombe-torisferik | CUS-17 | M | dimensionless | 1.5 | 1.5 | 0.0 | DOĞRULANDI | UG-32(e)/Appendix 1-4(d) independent equation
F03-bombe-torisferik | CUS-18 | required_thickness | mm | 6.6620012822252255 | 6.6620012822252255 | 0.0 | DOĞRULANDI | UG-32(e)/Appendix 1-4(d) independent equation
F03-bombe-torisferik | CUS-18 | mawp | MPa | 3.5962601365319684 | 3.5962601365319684 | 0.0 | DOĞRULANDI | UG-32(e)/Appendix 1-4(d) independent equation
F03-bombe-torisferik | CUS-18 | M | dimensionless | 1.6115030470056388 | 1.6115030470056388 | 0.0 | DOĞRULANDI | UG-32(e)/Appendix 1-4(d) independent equation
F03-bombe-torisferik | PUB-K1-10 | required_thickness | mm | 22.591053252648393 | 22.608539999999998 | -0.07734576116637559 | DOĞRULANDI | K1-10 (PVE Four Heads)
F03-bombe-torisferik | PUB-K1-10 | mawp | MPa | 2.8980348666686484 | 2.8958670107034914 | 0.07486034258977832 | DOĞRULANDI | K1-10 (PVE Four Heads)
F03-bombe-torisferik | PUB-K1-10 | M | dimensionless | 1.7623414307155045 | 1.7623 | 0.0023509456678518677 | DOĞRULANDI | K1-10 (PVE Four Heads)
F03-bombe-torisferik | BAD-MISSING-R | required_thickness | mm | 8.01325306878174 |  |  | KAYNAK_BEKLİYOR | UG-32(e)/Appendix 1-4(d) independent equation
F03-bombe-torisferik | BAD-MISSING-R | mawp | MPa | 2.9911475764906497 |  |  | KAYNAK_BEKLİYOR | UG-32(e)/Appendix 1-4(d) independent equation
F03-bombe-torisferik | BAD-MISSING-R | M | dimensionless | 1.7706207261596576 |  |  | KAYNAK_BEKLİYOR | UG-32(e)/Appendix 1-4(d) independent equation
F04-bombe-yarimkure | grid-D300-P0.1 | required_thickness | mm | 0.062116302423571065 | 0.05435176462062468 | 14.28571428571429 | SAPMA | UG-32(f) independent oracle
F04-bombe-yarimkure | grid-D300-P0.1 | mawp | MPa | 42.7906976744186 | 42.7906976744186 | 0.0 | DOĞRULANDI | UG-32(f) independent oracle
F04-bombe-yarimkure | grid-D300-P20 | required_thickness | mm | 12.605042016806722 | 11.029411764705882 | 14.285714285714283 | SAPMA | UG-32(f) independent oracle
F04-bombe-yarimkure | grid-D300-P20 | mawp | MPa | 42.7906976744186 | 42.7906976744186 | 0.0 | DOĞRULANDI | UG-32(f) independent oracle
F04-bombe-yarimkure | grid-D4000-P0.1 | required_thickness | mm | 0.8282173656476142 | 0.7246901949416624 | 14.285714285714283 | SAPMA | UG-32(f) independent oracle
F04-bombe-yarimkure | grid-D4000-P0.1 | mawp | MPa | 3.304070231444533 | 3.304070231444533 | 0.0 | DOĞRULANDI | UG-32(f) independent oracle
F04-bombe-yarimkure | grid-D4000-P20 | required_thickness | mm | 168.0672268907563 | 147.05882352941177 | 14.285714285714283 | SAPMA | UG-32(f) independent oracle
F04-bombe-yarimkure | grid-D4000-P20 | mawp | MPa | 3.304070231444533 | 3.304070231444533 | 0.0 | DOĞRULANDI | UG-32(f) independent oracle
F04-bombe-yarimkure | grid-D1000-P1 | required_thickness | mm | 2.0718947477468146 | 1.8129079042784626 | 14.285714285714295 | SAPMA | UG-32(f) independent oracle
F04-bombe-yarimkure | grid-D1000-P1 | mawp | MPa | 13.12202852614897 | 13.12202852614897 | 0.0 | DOĞRULANDI | UG-32(f) independent oracle
F04-bombe-yarimkure | grid-D2000-P5 | required_thickness | mm | 20.779220779220783 | 18.181818181818183 | 14.285714285714294 | SAPMA | UG-32(f) independent oracle
F04-bombe-yarimkure | grid-D2000-P5 | mawp | MPa | 6.592356687898089 | 6.592356687898089 | 0.0 | DOĞRULANDI | UG-32(f) independent oracle
F04-bombe-yarimkure | grid-D3000-P10 | required_thickness | mm | 62.56517205422315 | 54.74452554744526 | 14.28571428571428 | SAPMA | UG-32(f) independent oracle
F04-bombe-yarimkure | grid-D3000-P10 | mawp | MPa | 4.401913875598086 | 4.401913875598086 | 0.0 | DOĞRULANDI | UG-32(f) independent oracle
F04-bombe-yarimkure | grid-D1500-P3 | required_thickness | mm | 9.337068160597573 | 8.169934640522877 | 14.285714285714276 | SAPMA | UG-32(f) independent oracle
F04-bombe-yarimkure | grid-D1500-P3 | mawp | MPa | 8.7758346581876 | 8.7758346581876 | 0.0 | DOĞRULANDI | UG-32(f) independent oracle
F04-bombe-yarimkure | grid-D2500-P8 | required_thickness | mm | 41.649312786339024 | 36.44314868804665 | 14.28571428571428 | SAPMA | UG-32(f) independent oracle
F04-bombe-yarimkure | grid-D2500-P8 | mawp | MPa | 5.278928912974179 | 5.278928912974179 | 0.0 | DOĞRULANDI | UG-32(f) independent oracle
F04-bombe-yarimkure | diameter-300 | required_thickness | mm | 1.2440389798880365 | 1.0885341074020318 | 14.285714285714294 | SAPMA | UG-32(f) independent oracle
F04-bombe-yarimkure | diameter-300 | mawp | MPa | 42.7906976744186 | 42.7906976744186 | 0.0 | DOĞRULANDI | UG-32(f) independent oracle
F04-bombe-yarimkure | diameter-500 | required_thickness | mm | 2.0733982998133937 | 1.8142235123367196 | 14.28571428571428 | SAPMA | UG-32(f) independent oracle
F04-bombe-yarimkure | diameter-500 | mawp | MPa | 25.996860282574566 | 25.996860282574566 | 0.0 | DOĞRULANDI | UG-32(f) independent oracle
F04-bombe-yarimkure | diameter-1000 | required_thickness | mm | 4.1467965996267875 | 3.6284470246734393 | 14.28571428571428 | SAPMA | UG-32(f) independent oracle
F04-bombe-yarimkure | diameter-1000 | mawp | MPa | 13.12202852614897 | 13.12202852614897 | 0.0 | DOĞRULANDI | UG-32(f) independent oracle
F04-bombe-yarimkure | diameter-2000 | required_thickness | mm | 8.293593199253575 | 7.2568940493468785 | 14.28571428571428 | SAPMA | UG-32(f) independent oracle
F04-bombe-yarimkure | diameter-2000 | mawp | MPa | 6.592356687898089 | 6.592356687898089 | 0.0 | DOĞRULANDI | UG-32(f) independent oracle
F04-bombe-yarimkure | diameter-3000 | required_thickness | mm | 12.440389798880364 | 10.88534107402032 | 14.285714285714283 | SAPMA | UG-32(f) independent oracle
F04-bombe-yarimkure | diameter-3000 | mawp | MPa | 4.401913875598086 | 4.401913875598086 | 0.0 | DOĞRULANDI | UG-32(f) independent oracle
F04-bombe-yarimkure | diameter-4000 | required_thickness | mm | 16.58718639850715 | 14.513788098693757 | 14.28571428571428 | SAPMA | UG-32(f) independent oracle
F04-bombe-yarimkure | diameter-4000 | mawp | MPa | 3.304070231444533 | 3.304070231444533 | 0.0 | DOĞRULANDI | UG-32(f) independent oracle
F04-bombe-yarimkure | pressure-0.1 | required_thickness | mm | 0.3105815121178553 | 0.2717588231031234 | 14.285714285714283 | SAPMA | UG-32(f) independent oracle
F04-bombe-yarimkure | pressure-0.1 | mawp | MPa | 8.7758346581876 | 8.7758346581876 | 0.0 | DOĞRULANDI | UG-32(f) independent oracle
F04-bombe-yarimkure | pressure-0.5 | required_thickness | mm | 1.5533578418681717 | 1.3591881116346503 | 14.285714285714285 | SAPMA | UG-32(f) independent oracle
F04-bombe-yarimkure | pressure-0.5 | mawp | MPa | 8.7758346581876 | 8.7758346581876 | 0.0 | DOĞRULANDI | UG-32(f) independent oracle
F04-bombe-yarimkure | pressure-1 | required_thickness | mm | 3.1078421216202217 | 2.719361856417694 | 14.285714285714294 | SAPMA | UG-32(f) independent oracle
F04-bombe-yarimkure | pressure-1 | mawp | MPa | 8.7758346581876 | 8.7758346581876 | 0.0 | DOĞRULANDI | UG-32(f) independent oracle
F04-bombe-yarimkure | pressure-5 | required_thickness | mm | 15.584415584415584 | 13.636363636363637 | 14.285714285714283 | SAPMA | UG-32(f) independent oracle
F04-bombe-yarimkure | pressure-5 | mawp | MPa | 8.7758346581876 | 8.7758346581876 | 0.0 | DOĞRULANDI | UG-32(f) independent oracle
F04-bombe-yarimkure | pressure-10 | required_thickness | mm | 31.282586027111574 | 27.37226277372263 | 14.28571428571428 | SAPMA | UG-32(f) independent oracle
F04-bombe-yarimkure | pressure-10 | mawp | MPa | 8.7758346581876 | 8.7758346581876 | 0.0 | DOĞRULANDI | UG-32(f) independent oracle
F04-bombe-yarimkure | pressure-20 | required_thickness | mm | 63.02521008403362 | 55.14705882352941 | 14.28571428571429 | SAPMA | UG-32(f) independent oracle
F04-bombe-yarimkure | pressure-20 | mawp | MPa | 8.7758346581876 | 8.7758346581876 | 0.0 | DOĞRULANDI | UG-32(f) independent oracle
F04-bombe-yarimkure | ca-2 | required_thickness | mm | 17.911688311688312 | 15.672727272727272 | 14.285714285714295 | SAPMA | UG-32(f) independent oracle
F04-bombe-yarimkure | ca-2 | mawp | MPa | 8.027498677948175 | 8.027498677948175 | 0.0 | DOĞRULANDI | UG-32(f) independent oracle
F04-bombe-yarimkure | ca-5 | required_thickness | mm | 21.4025974025974 | 18.727272727272727 | 14.28571428571428 | SAPMA | UG-32(f) independent oracle
F04-bombe-yarimkure | ca-5 | mawp | MPa | 6.91091196626252 | 6.91091196626252 | 0.0 | DOĞRULANDI | UG-32(f) independent oracle
F04-bombe-yarimkure | eff-0.85 | required_thickness | mm | 18.34637964774951 | 16.053082191780824 | 14.285714285714276 | SAPMA | UG-32(f) independent oracle
F04-bombe-yarimkure | eff-0.85 | mawp | MPa | 7.45945945945946 | 7.45945945945946 | 0.0 | DOĞRULANDI | UG-32(f) independent oracle
F04-bombe-yarimkure | stress-low | required_thickness | mm | 21.536252692031585 | 18.844221105527637 | 14.285714285714283 | SAPMA | UG-32(f) independent oracle
F04-bombe-yarimkure | stress-low | mawp | MPa | 6.359300476947536 | 6.359300476947536 | 0.0 | DOĞRULANDI | UG-32(f) independent oracle
F04-bombe-yarimkure | thick-wall | required_thickness | mm | 12.605042016806722 | 11.029411764705882 | 14.285714285714283 | SAPMA | UG-32(f) independent oracle
F04-bombe-yarimkure | thick-wall | mawp | MPa | 267.0967741935484 | 267.0967741935484 | 0.0 | DOĞRULANDI | UG-32(f) independent oracle
F04-bombe-yarimkure | thin-wall | required_thickness | mm | 0.8282173656476142 | 0.7246901949416624 | 14.285714285714283 | SAPMA | UG-32(f) independent oracle
F04-bombe-yarimkure | thin-wall | mawp | MPa | 0.8275034979012592 | 0.8275034979012592 | 0.0 | DOĞRULANDI | UG-32(f) independent oracle
F04-bombe-yarimkure | interaction-300-0.1 | required_thickness | mm | 1.2227587210455995 | 1.0699138809148996 | 14.28571428571428 | SAPMA | UG-32(f) independent oracle
F04-bombe-yarimkure | interaction-300-0.1 | mawp | MPa | 47.848101265822784 | 47.848101265822784 | 0.0 | DOĞRULANDI | UG-32(f) independent oracle
F04-bombe-yarimkure | interaction-4000-20 | required_thickness | mm | 216.88409703504044 | 189.77358490566039 | 14.285714285714285 | SAPMA | UG-32(f) independent oracle
F04-bombe-yarimkure | interaction-4000-20 | mawp | MPa | 3.764940239043825 | 3.764940239043825 | 0.0 | DOĞRULANDI | UG-32(f) independent oracle
F04-bombe-yarimkure | interaction-1000-10 | required_thickness | mm | 27.89853137516689 | 24.411214953271028 | 14.28571428571429 | SAPMA | UG-32(f) independent oracle
F04-bombe-yarimkure | interaction-1000-10 | mawp | MPa | 14.881889763779528 | 14.881889763779528 | 0.0 | DOĞRULANDI | UG-32(f) independent oracle
F04-bombe-yarimkure | interaction-2000-15 | required_thickness | mm | 81.7062374245473 | 71.49295774647888 | 14.285714285714294 | SAPMA | UG-32(f) independent oracle
F04-bombe-yarimkure | interaction-2000-15 | mawp | MPa | 7.5 | 7.5 | 0.0 | DOĞRULANDI | UG-32(f) independent oracle
F04-bombe-yarimkure | interaction-3000-1 | required_thickness | mm | 9.092016417317621 | 7.955514365152919 | 14.285714285714276 | SAPMA | UG-32(f) independent oracle
F04-bombe-yarimkure | interaction-3000-1 | mawp | MPa | 5.013262599469496 | 5.013262599469496 | 0.0 | DOĞRULANDI | UG-32(f) independent oracle
F04-bombe-yarimkure | K1-12-spherical-segment | required_thickness | mm | 39.26888054268631 | 34.36027047485052 | 14.285714285714283 | SAPMA | K1-12 PVEcalc-4225-0-1, sphere segment
F04-bombe-yarimkure | K1-12-spherical-segment | mawp | MPa | 1.18752553285968 | 1.18752553285968 | 0.0 | DOĞRULANDI | K1-12 PVEcalc-4225-0-1, sphere segment
F04-bombe-yarimkure | K1-13-spherical-segment | required_thickness | mm | 42.30513400845741 | 37.01699225740023 | 14.285714285714283 | SAPMA | K1-13 PVEcalc-4225-0-1, sphere segment
F04-bombe-yarimkure | K1-13-spherical-segment | mawp | MPa | 1.1711588716571009 | 1.1711588716571009 | 0.0 | DOĞRULANDI | K1-13 PVEcalc-4225-0-1, sphere segment
F04-bombe-yarimkure | invalid-zero-pressure | required_thickness | mm |  | 0.0 |  | KAPSAM_DIŞI | UG-32(f) independent oracle | {"detail":[{"type":"greater_than","loc":["body","design_conditions","design_pressure"],"msg":"Input should be greater than 0","input":0,"ctx":{"gt":0.0}}]}
F04-bombe-yarimkure | invalid-zero-pressure | mawp | MPa |  | 8.7758346581876 |  | KAPSAM_DIŞI | UG-32(f) independent oracle | {"detail":[{"type":"greater_than","loc":["body","design_conditions","design_pressure"],"msg":"Input should be greater than 0","input":0,"ctx":{"gt":0.0}}]}
F05-duz_kapak_ug34 | C017-d200-P02 | required_thickness | mm | 3.1404739448268417 | 3.1404739448268417 | 0.0 | DOĞRULANDI | oracle
F05-duz_kapak_ug34 | C020-d200-P10 | required_thickness | mm | 7.6167681111889625 | 7.6167681111889625 | 0.0 | DOĞRULANDI | oracle
F05-duz_kapak_ug34 | C025-d400-P05 | required_thickness | mm | 12.043167820347879 | 12.043167820347879 | 0.0 | DOĞRULANDI | oracle
F05-duz_kapak_ug34 | C030-d400-P20 | required_thickness | mm | 26.38525871609943 | 26.38525871609943 | 0.0 | DOĞRULANDI | oracle
F05-duz_kapak_ug34 | C033-d600-P10 | required_thickness | mm | 29.351747365794637 | 29.351747365794637 | 0.0 | DOĞRULANDI | oracle
F05-duz_kapak_ug34 | C017-d600-P30 | required_thickness | mm | 36.489009862538 | 36.489009862538 | 0.0 | DOĞRULANDI | oracle
F05-duz_kapak_ug34 | C020-d800-P05 | required_thickness | mm | 21.543473528588667 | 21.543473528588667 | 0.0 | DOĞRULANDI | oracle
F05-duz_kapak_ug34 | C025-d800-P15 | required_thickness | mm | 41.718757097842115 | 41.718757097842115 | 0.0 | DOĞRULANDI | oracle
F05-duz_kapak_ug34 | C030-d1000-P02 | required_thickness | mm | 20.859378548921057 | 20.859378548921057 | 0.0 | DOĞRULANDI | oracle
F05-duz_kapak_ug34 | C033-d1000-P10 | required_thickness | mm | 48.91957894299106 | 48.91957894299106 | 0.0 | DOĞRULANDI | oracle
F05-duz_kapak_ug34 | C017-d1200-P05 | required_thickness | mm | 29.793151794200348 | 29.793151794200348 | 0.0 | DOĞRULANDI | oracle
F05-duz_kapak_ug34 | C020-d1200-P20 | required_thickness | mm | 64.630420585766 | 64.630420585766 | 0.0 | DOĞRULANDI | oracle
F05-duz_kapak_ug34 | C025-d1400-P10 | required_thickness | mm | 59.61063942914919 | 59.61063942914919 | 0.0 | DOĞRULANDI | oracle
F05-duz_kapak_ug34 | C030-d1400-P30 | required_thickness | mm | 113.10323602509048 | 113.10323602509048 | 0.0 | DOĞRULANDI | oracle
F05-duz_kapak_ug34 | C033-d1600-P05 | required_thickness | mm | 55.34618560540739 | 55.34618560540739 | 0.0 | DOĞRULANDI | oracle
F05-duz_kapak_ug34 | C017-d1600-P15 | required_thickness | mm | 68.80433683355582 | 68.80433683355582 | 0.0 | DOĞRULANDI | oracle
F05-duz_kapak_ug34 | C020-d1800-P10 | required_thickness | mm | 68.55091300070066 | 68.55091300070066 | 0.0 | DOĞRULANDI | oracle
F05-duz_kapak_ug34 | C025-d1800-P30 | required_thickness | mm | 132.74827220951357 | 132.74827220951357 | 0.0 | DOĞRULANDI | oracle
F05-duz_kapak_ug34 | C030-d2000-P05 | required_thickness | mm | 65.96314679024857 | 65.96314679024857 | 0.0 | DOĞRULANDI | oracle
F05-duz_kapak_ug34 | C033-d2000-P20 | required_thickness | mm | 138.36546401351848 | 138.36546401351848 | 0.0 | DOĞRULANDI | oracle
F05-duz_kapak_ug34 | W-C020 | required_thickness | mm | 22.850304333566886 | 22.850304333566886 | 0.0 | DOĞRULANDI | oracle
F05-duz_kapak_ug34 | W-C025 | required_thickness | mm | 42.57902816367799 | 42.57902816367799 | 0.0 | DOĞRULANDI | oracle
F05-duz_kapak_ug34 | W-C030 | required_thickness | mm | 105.54103486439772 | 105.54103486439772 | 0.0 | DOĞRULANDI | oracle
F05-duz_kapak_ug34 | W-C033 | required_thickness | mm | 169.4623924282742 | 169.4623924282742 | 0.0 | DOĞRULANDI | oracle
F05-duz_kapak_ug34 | CA-1 | required_thickness | mm | 19.118087959084296 | 20.041920277972405 | -4.609500018336425 | SAPMA | oracle
F05-duz_kapak_ug34 | CA-5 | required_thickness | mm | 43.004818445314775 | 47.57902816367799 | -9.613920029277065 | SAPMA | oracle
F05-duz_kapak_ug34 | CA-20 | required_thickness | mm | 101.5832460569828 | 118.94472018537286 | -14.596254546929499 | SAPMA | oracle
F05-duz_kapak_ug34 | LOW-P | required_thickness | mm | 3.808384055594481 | 3.808384055594481 | 0.0 | DOĞRULANDI | oracle
F05-duz_kapak_ug34 | HIGH-P | required_thickness | mm | 109.38750394719531 | 109.38750394719531 | 0.0 | DOĞRULANDI | oracle
F05-duz_kapak_ug34 | LOW-S | required_thickness | mm | 69.57010852370433 | 113.24555320336759 | -38.56702841234783 | SAPMA | oracle
F05-duz_kapak_ug34 | HIGH-S | required_thickness | mm | 53.31737677832274 | 238.08384055594482 | -77.60562974210161 | SAPMA | oracle
F05-duz_kapak_ug34 | INVALID-NEGATIVE-P | required_thickness | mm |  |  |  | KAPSAM_DIŞI | oracle | API/result missing: {"detail":[{"type":"greater_than","loc":["body","design_conditions","design_pressure"],"msg":"Input should be greater than 0","input":-1,"ctx":{"gt":0.0}}]}
F05-duz_kapak_ug34 | BLOCKED-MISSING-C | required_thickness | mm |  |  |  | KAPSAM_DIŞI | oracle
F05-duz_kapak_ug34 | PUBLISHED-K1-05 | required_thickness | mm | 19.27724461638644 | 19.27606 | 0.006145531744760468 | DOĞRULANDI | K1-05 Codeware COMPRESS Demo Vessel, 2022, pp. 16-17 | Published output has C=.2 and zero corrosion allowance.
F06-koni | GRID-01 | required_thickness | mm | 2.082829832022715 | 2.082829832022715 | 0.0 | DOĞRULANDI | oracle | UG-32(g); koni MAWP oracle: 3.46555 MPa; App 1-5 Q/area oracle unavailable.
F06-koni | GRID-01-MAWP | mawp | MPa | 3.4396410013076393 | 3.4655546181705312 | -0.7477480437625239 | DOĞRULANDI | oracle | Nominal thickness based UG-32(g) pressure inversion.
F06-koni | GRID-01-APP15 | junction_check | status |  |  |  | KAPSAM_DIŞI | K2-18 only stress context | Catalog: junction_check is topology/input review, not numerical adequacy; no published App. 1-5 numerical oracle.
F06-koni | GRID-02 | required_thickness | mm | 5.325961643661609 | 4.174754990822821 | 27.57543030356115 | FORMÜLASYON_FARKI | oracle | UG-32(g); koni MAWP oracle: 3.46555 MPa; App 1-5 Q/area oracle unavailable.
F06-koni | GRID-02-MAWP | mawp | MPa | 3.1662937314240613 | 3.1945713653786654 | -0.8851777193355068 | DOĞRULANDI | oracle | Nominal thickness based UG-32(g) pressure inversion.
F06-koni | GRID-02-APP15 | junction_check | status |  |  |  | KAPSAM_DIŞI | K2-18 only stress context | Catalog: junction_check is topology/input review, not numerical adequacy; no published App. 1-5 numerical oracle.
F06-koni | GRID-03 | required_thickness | mm | 10.705389447732001 | 8.386130639459877 | 27.655886939790154 | FORMÜLASYON_FARKI | oracle | UG-32(g); koni MAWP oracle: 3.46555 MPa; App 1-5 Q/area oracle unavailable.
F06-koni | GRID-03-MAWP | mawp | MPa | 2.8933790499255254 | 2.923266228721933 | -1.0223899042364775 | FORMÜLASYON_FARKI | oracle | Nominal thickness based UG-32(g) pressure inversion.
F06-koni | GRID-03-APP15 | junction_check | status |  |  |  | KAPSAM_DIŞI | K2-18 only stress context | Catalog: junction_check is topology/input review, not numerical adequacy; no published App. 1-5 numerical oracle.
F06-koni | GRID-04 | required_thickness | mm | 2.148098724784901 | 2.148098724784901 | 0.0 | DOĞRULANDI | oracle | UG-32(g); koni MAWP oracle: 3.36102 MPa; App 1-5 Q/area oracle unavailable.
F06-koni | GRID-04-MAWP | mawp | MPa | 3.336645418095034 | 3.361024870780235 | -0.7253576995858866 | DOĞRULANDI | oracle | Nominal thickness based UG-32(g) pressure inversion.
F06-koni | GRID-04-APP15 | junction_check | status |  |  |  | KAPSAM_DIŞI | K2-18 only stress context | Catalog: junction_check is topology/input review, not numerical adequacy; no published App. 1-5 numerical oracle.
F06-koni | GRID-05 | required_thickness | mm | 5.457046091789991 | 4.305577793346155 | 26.7436417064236 | FORMÜLASYON_FARKI | oracle | UG-32(g); koni MAWP oracle: 3.36102 MPa; App 1-5 Q/area oracle unavailable.
F06-koni | GRID-05-MAWP | mawp | MPa | 3.0713722166623927 | 3.0981596792664985 | -0.8646249831270105 | DOĞRULANDI | oracle | Nominal thickness based UG-32(g) pressure inversion.
F06-koni | GRID-05-APP15 | junction_check | status |  |  |  | KAPSAM_DIŞI | K2-18 only stress context | Catalog: junction_check is topology/input review, not numerical adequacy; no published App. 1-5 numerical oracle.
F06-koni | GRID-06 | required_thickness | mm | 10.969233793915818 | 8.648923812949732 | 26.82773060726892 | FORMÜLASYON_FARKI | oracle | UG-32(g); koni MAWP oracle: 3.36102 MPa; App 1-5 Q/area oracle unavailable.
F06-koni | GRID-06-MAWP | mawp | MPa | 2.806537946306842 | 2.8349916756317737 | -1.00366182975091 | FORMÜLASYON_FARKI | oracle | Nominal thickness based UG-32(g) pressure inversion.
F06-koni | GRID-06-APP15 | junction_check | status |  |  |  | KAPSAM_DIŞI | K2-18 only stress context | Catalog: junction_check is topology/input review, not numerical adequacy; no published App. 1-5 numerical oracle.
F06-koni | GRID-07 | required_thickness | mm | 2.3958928070946186 | 2.3958928070946186 | 0.0 | DOĞRULANDI | oracle | UG-32(g); koni MAWP oracle: 3.01569 MPa; App 1-5 Q/area oracle unavailable.
F06-koni | GRID-07-MAWP | mawp | MPa | 2.9960497008299614 | 3.0156913555770744 | -0.6513151523543237 | DOĞRULANDI | oracle | Nominal thickness based UG-32(g) pressure inversion.
F06-koni | GRID-07-APP15 | junction_check | status |  |  |  | KAPSAM_DIŞI | K2-18 only stress context | Catalog: junction_check is topology/input review, not numerical adequacy; no published App. 1-5 numerical oracle.
F06-koni | GRID-08 | required_thickness | mm | 5.954709667107548 | 4.8022480281940165 | 23.998378095996394 | FORMÜLASYON_FARKI | oracle | UG-32(g); koni MAWP oracle: 3.01569 MPa; App 1-5 Q/area oracle unavailable.
F06-koni | GRID-08-MAWP | mawp | MPa | 2.757525440375383 | 2.7796702333464345 | -0.7966697885738554 | DOĞRULANDI | oracle | Nominal thickness based UG-32(g) pressure inversion.
F06-koni | GRID-08-APP15 | junction_check | status |  |  |  | KAPSAM_DIŞI | K2-18 only stress context | Catalog: junction_check is topology/input review, not numerical adequacy; no published App. 1-5 numerical oracle.
F06-koni | GRID-09 | required_thickness | mm | 11.970921808962142 | 9.646621039091489 | 24.094455047542265 | FORMÜLASYON_FARKI | oracle | UG-32(g); koni MAWP oracle: 3.01569 MPa; App 1-5 Q/area oracle unavailable.
F06-koni | GRID-09-MAWP | mawp | MPa | 2.5194526869168783 | 2.5434051869603653 | -0.9417492803068775 | DOĞRULANDI | oracle | Nominal thickness based UG-32(g) pressure inversion.
F06-koni | GRID-09-APP15 | junction_check | status |  |  |  | KAPSAM_DIŞI | K2-18 only stress context | Catalog: junction_check is topology/input review, not numerical adequacy; no published App. 1-5 numerical oracle.
F06-koni | GRID-10 | required_thickness | mm | 2.9343574278931324 | 2.9343574278931324 | 0.0 | DOĞRULANDI | oracle | UG-32(g); koni MAWP oracle: 2.46527 MPa; App 1-5 Q/area oracle unavailable.
F06-koni | GRID-10-MAWP | mawp | MPa | 2.452125827844923 | 2.4652674495527354 | -0.5330708321402065 | DOĞRULANDI | oracle | Nominal thickness based UG-32(g) pressure inversion.
F06-koni | GRID-10-APP15 | junction_check | status |  |  |  | KAPSAM_DIŞI | K2-18 only stress context | Catalog: junction_check is topology/input review, not numerical adequacy; no published App. 1-5 numerical oracle.
F06-koni | GRID-11 | required_thickness | mm | 7.036148843825498 | 5.881528643680993 | 19.63129434700633 | FORMÜLASYON_FARKI | oracle | UG-32(g); koni MAWP oracle: 2.46527 MPa; App 1-5 Q/area oracle unavailable.
F06-koni | GRID-11-MAWP | mawp | MPa | 2.256474488322719 | 2.272110711069942 | -0.6881804953887991 | DOĞRULANDI | oracle | Nominal thickness based UG-32(g) pressure inversion.
F06-koni | GRID-11-APP15 | junction_check | status |  |  |  | KAPSAM_DIŞI | K2-18 only stress context | Catalog: junction_check is topology/input review, not numerical adequacy; no published App. 1-5 numerical oracle.
F06-koni | GRID-12 | required_thickness | mm | 14.147622528175333 | 11.814649643885504 | 19.74644153326395 | FORMÜLASYON_FARKI | oracle | UG-32(g); koni MAWP oracle: 2.46527 MPa; App 1-5 Q/area oracle unavailable.
F06-koni | GRID-12-MAWP | mawp | MPa | 2.0612679057375405 | 2.078790814336972 | -0.842937561517975 | DOĞRULANDI | oracle | Nominal thickness based UG-32(g) pressure inversion.
F06-koni | GRID-12-APP15 | junction_check | status |  |  |  | KAPSAM_DIŞI | K2-18 only stress context | Catalog: junction_check is topology/input review, not numerical adequacy; no published App. 1-5 numerical oracle.
F06-koni | GRID-13 | required_thickness | mm | 4.1498080713766985 | 4.1498080713766985 | 0.0 | DOĞRULANDI | oracle | UG-32(g); koni MAWP oracle: 1.74595 MPa; App 1-5 Q/area oracle unavailable.
F06-koni | GRID-13-MAWP | mawp | MPa | 1.7393461820924558 | 1.7459479383548684 | -0.3781187352374952 | DOĞRULANDI | oracle | Nominal thickness based UG-32(g) pressure inversion.
F06-koni | GRID-13-APP15 | junction_check | status |  |  |  | KAPSAM_DIŞI | K2-18 only stress context | Catalog: junction_check is topology/input review, not numerical adequacy; no published App. 1-5 numerical oracle.
F06-koni | GRID-14 | required_thickness | mm | 9.477230193387397 | 8.317737575379494 | 13.940000000000015 | FORMÜLASYON_FARKI | oracle | UG-32(g); koni MAWP oracle: 1.74595 MPa; App 1-5 Q/area oracle unavailable.
F06-koni | GRID-14-MAWP | mawp | MPa | 1.6001664981863593 | 1.6089525764566373 | -0.5460744088323222 | DOĞRULANDI | oracle | Nominal thickness based UG-32(g) pressure inversion.
F06-koni | GRID-14-APP15 | junction_check | status |  |  |  | KAPSAM_DIŞI | K2-18 only stress context | Catalog: junction_check is topology/input review, not numerical adequacy; no published App. 1-5 numerical oracle.
F06-koni | GRID-15 | required_thickness | mm | 19.0609857978279 | 16.708437761069337 | 14.08 | FORMÜLASYON_FARKI | oracle | UG-32(g); koni MAWP oracle: 1.74595 MPa; App 1-5 Q/area oracle unavailable.
F06-koni | GRID-15-MAWP | mawp | MPa | 1.4613724985649534 | 1.4718752803500763 | -0.713564656281533 | DOĞRULANDI | oracle | Nominal thickness based UG-32(g) pressure inversion.
F06-koni | GRID-15-APP15 | junction_check | status |  |  |  | KAPSAM_DIŞI | K2-18 only stress context | Catalog: junction_check is topology/input review, not numerical adequacy; no published App. 1-5 numerical oracle.
F06-koni | GRID-16 | required_thickness | mm | 6.3842863961925564 | 6.3842863961925564 | 0.0 | DOĞRULANDI | oracle | UG-32(g); koni MAWP oracle: 3.14731 MPa; App 1-5 Q/area oracle unavailable.
F06-koni | GRID-16-MAWP | mawp | MPa | 3.1259205382664015 | 3.1473080050779747 | -0.6795479431014043 | DOĞRULANDI | oracle | Nominal thickness based UG-32(g) pressure inversion.
F06-koni | GRID-16-APP15 | junction_check | status |  |  |  | KAPSAM_DIŞI | K2-18 only stress context | Catalog: junction_check is topology/input review, not numerical adequacy; no published App. 1-5 numerical oracle.
F07-mawp_statik_kafa | V-P1 | global_mawp | MPa | 1.7098156081206928 | 1.7098156081206928 | 0.0 | DOĞRULANDI | Clean-room UG-27(c)(1)/UG-32(d) equations; zero datum head | suite_governing=HEAD-R; mawp_row=1.70981561 MPa; IV(t_corroded=6.75, S=120.0, E=0.85); oracle_governing=HEAD-R; Clean-room UG-27(c)(1)/UG-32(d) equations; zero datum head
F07-mawp_statik_kafa | V-P2 | global_mawp | MPa | 1.7098156081206928 | 1.7098156081206928 | 0.0 | DOĞRULANDI | Clean-room UG-27(c)(1)/UG-32(d) equations; zero datum head | suite_governing=HEAD-R; mawp_row=1.70981561 MPa; IV(t_corroded=6.75, S=120.0, E=0.85); oracle_governing=HEAD-R; Clean-room UG-27(c)(1)/UG-32(d) equations; zero datum head
F07-mawp_statik_kafa | V-P3 | global_mawp | MPa | 1.7098156081206928 | 1.7098156081206928 | 0.0 | DOĞRULANDI | Clean-room UG-27(c)(1)/UG-32(d) equations; zero datum head | suite_governing=HEAD-R; mawp_row=1.70981561 MPa; IV(t_corroded=6.75, S=120.0, E=0.85); oracle_governing=HEAD-R; Clean-room UG-27(c)(1)/UG-32(d) equations; zero datum head
F07-mawp_statik_kafa | V-P4 | global_mawp | MPa | 1.7098156081206928 | 1.7098156081206928 | 0.0 | DOĞRULANDI | Clean-room UG-27(c)(1)/UG-32(d) equations; zero datum head | suite_governing=HEAD-R; mawp_row=1.70981561 MPa; IV(t_corroded=6.75, S=120.0, E=0.85); oracle_governing=HEAD-R; Clean-room UG-27(c)(1)/UG-32(d) equations; zero datum head
F07-mawp_statik_kafa | V-P5 | global_mawp | MPa | 1.7098156081206928 | 1.7098156081206928 | 0.0 | DOĞRULANDI | Clean-room UG-27(c)(1)/UG-32(d) equations; zero datum head | suite_governing=HEAD-R; mawp_row=1.70981561 MPa; IV(t_corroded=6.75, S=120.0, E=0.85); oracle_governing=HEAD-R; Clean-room UG-27(c)(1)/UG-32(d) equations; zero datum head
F07-mawp_statik_kafa | V-RHO1 | global_mawp | MPa | 1.7098156081206928 | 1.7098156081206928 | 0.0 | DOĞRULANDI | Clean-room UG-27(c)(1)/UG-32(d) equations; zero datum head | suite_governing=HEAD-R; mawp_row=1.70981561 MPa; IV(t_corroded=6.75, S=120.0, E=0.85); oracle_governing=HEAD-R; Clean-room UG-27(c)(1)/UG-32(d) equations; zero datum head
F07-mawp_statik_kafa | V-RHO2 | global_mawp | MPa | 1.7098156081206928 | 1.7098156081206928 | 0.0 | DOĞRULANDI | Clean-room UG-27(c)(1)/UG-32(d) equations; zero datum head | suite_governing=HEAD-R; mawp_row=1.70981561 MPa; IV(t_corroded=6.75, S=120.0, E=0.85); oracle_governing=HEAD-R; Clean-room UG-27(c)(1)/UG-32(d) equations; zero datum head
F07-mawp_statik_kafa | V-RHO3 | global_mawp | MPa | 1.7098156081206928 | 1.7098156081206928 | 0.0 | DOĞRULANDI | Clean-room UG-27(c)(1)/UG-32(d) equations; zero datum head | suite_governing=HEAD-R; mawp_row=1.70981561 MPa; IV(t_corroded=6.75, S=120.0, E=0.85); oracle_governing=HEAD-R; Clean-room UG-27(c)(1)/UG-32(d) equations; zero datum head
F07-mawp_statik_kafa | V-RHO4 | global_mawp | MPa | 1.7098156081206928 | 1.7098156081206928 | 0.0 | DOĞRULANDI | Clean-room UG-27(c)(1)/UG-32(d) equations; zero datum head | suite_governing=HEAD-R; mawp_row=1.70981561 MPa; IV(t_corroded=6.75, S=120.0, E=0.85); oracle_governing=HEAD-R; Clean-room UG-27(c)(1)/UG-32(d) equations; zero datum head
F07-mawp_statik_kafa | V-RHO5 | global_mawp | MPa | 1.7098156081206928 | 1.7098156081206928 | 0.0 | DOĞRULANDI | Clean-room UG-27(c)(1)/UG-32(d) equations; zero datum head | suite_governing=HEAD-R; mawp_row=1.70981561 MPa; IV(t_corroded=6.75, S=120.0, E=0.85); oracle_governing=HEAD-R; Clean-room UG-27(c)(1)/UG-32(d) equations; zero datum head
F07-mawp_statik_kafa | V-RHO6 | global_mawp | MPa | 1.7098156081206928 | 1.7098156081206928 | 0.0 | DOĞRULANDI | Clean-room UG-27(c)(1)/UG-32(d) equations; zero datum head | suite_governing=HEAD-R; mawp_row=1.70981561 MPa; IV(t_corroded=6.75, S=120.0, E=0.85); oracle_governing=HEAD-R; Clean-room UG-27(c)(1)/UG-32(d) equations; zero datum head
F07-mawp_statik_kafa | V-T1 | global_mawp | MPa | 1.3663366336633664 | 1.3663366336633664 | 0.0 | DOĞRULANDI | Clean-room UG-27(c)(1)/UG-32(d) equations; zero datum head | suite_governing=SHELL-01; mawp_row=1.36633663 MPa; IV(t_corroded=5.0, S=138.0, E=1.0); oracle_governing=SHELL-01; Clean-room UG-27(c)(1)/UG-32(d) equations; zero datum head
F07-mawp_statik_kafa | V-T2 | global_mawp | MPa | 1.7098156081206928 | 1.7098156081206928 | 0.0 | DOĞRULANDI | Clean-room UG-27(c)(1)/UG-32(d) equations; zero datum head | suite_governing=HEAD-R; mawp_row=1.70981561 MPa; IV(t_corroded=6.75, S=120.0, E=0.85); oracle_governing=HEAD-R; Clean-room UG-27(c)(1)/UG-32(d) equations; zero datum head
F07-mawp_statik_kafa | V-T3 | global_mawp | MPa | 1.7098156081206928 | 1.7098156081206928 | 0.0 | DOĞRULANDI | Clean-room UG-27(c)(1)/UG-32(d) equations; zero datum head | suite_governing=HEAD-R; mawp_row=1.70981561 MPa; IV(t_corroded=6.75, S=120.0, E=0.85); oracle_governing=HEAD-R; Clean-room UG-27(c)(1)/UG-32(d) equations; zero datum head
F07-mawp_statik_kafa | V-T4 | global_mawp | MPa | 1.7098156081206928 | 1.7098156081206928 | 0.0 | DOĞRULANDI | Clean-room UG-27(c)(1)/UG-32(d) equations; zero datum head | suite_governing=HEAD-R; mawp_row=1.70981561 MPa; IV(t_corroded=6.75, S=120.0, E=0.85); oracle_governing=HEAD-R; Clean-room UG-27(c)(1)/UG-32(d) equations; zero datum head
F07-mawp_statik_kafa | V-T5 | global_mawp | MPa | 1.7098156081206928 | 1.7098156081206928 | 0.0 | DOĞRULANDI | Clean-room UG-27(c)(1)/UG-32(d) equations; zero datum head | suite_governing=HEAD-R; mawp_row=1.70981561 MPa; IV(t_corroded=6.75, S=120.0, E=0.85); oracle_governing=HEAD-R; Clean-room UG-27(c)(1)/UG-32(d) equations; zero datum head
F07-mawp_statik_kafa | V-H1 | global_mawp | MPa | 1.0455689124965053 | 1.0455689124965053 | 0.0 | DOĞRULANDI | Clean-room UG-27(c)(1)/UG-32(d) equations; zero datum head | suite_governing=HEAD-R; mawp_row=1.04556891 MPa; IV(t_corroded=4.125, S=120.0, E=0.85); oracle_governing=HEAD-R; Clean-room UG-27(c)(1)/UG-32(d) equations; zero datum head
F07-mawp_statik_kafa | V-H2 | global_mawp | MPa | 1.4884962896264788 | 1.4884962896264788 | 0.0 | DOĞRULANDI | Clean-room UG-27(c)(1)/UG-32(d) equations; zero datum head | suite_governing=HEAD-R; mawp_row=1.48849629 MPa; IV(t_corroded=5.875, S=120.0, E=0.85); oracle_governing=HEAD-R; Clean-room UG-27(c)(1)/UG-32(d) equations; zero datum head
F07-mawp_statik_kafa | V-H3 | global_mawp | MPa | 2.152165818542882 | 2.152165818542882 | 0.0 | DOĞRULANDI | Clean-room UG-27(c)(1)/UG-32(d) equations; zero datum head | suite_governing=HEAD-R; mawp_row=2.15216582 MPa; IV(t_corroded=8.5, S=120.0, E=0.85); oracle_governing=HEAD-R; Clean-room UG-27(c)(1)/UG-32(d) equations; zero datum head
F07-mawp_statik_kafa | V-H4 | global_mawp | MPa | 2.313153224216131 | 2.313153224216131 | 0.0 | DOĞRULANDI | Clean-room UG-27(c)(1)/UG-32(d) equations; zero datum head | suite_governing=SHELL-01; mawp_row=2.31315322 MPa; IV(t_corroded=8.5, S=138.0, E=1.0); oracle_governing=SHELL-01; Clean-room UG-27(c)(1)/UG-32(d) equations; zero datum head
F07-mawp_statik_kafa | H-RHO1 | global_mawp | MPa | 1.7098156081206928 | 1.7098156081206928 | 0.0 | DOĞRULANDI | Clean-room UG-27(c)(1)/UG-32(d) equations; zero datum head | suite_governing=HEAD-R; mawp_row=1.70981561 MPa; IV(t_corroded=6.75, S=120.0, E=0.85); oracle_governing=HEAD-R; Clean-room UG-27(c)(1)/UG-32(d) equations; zero datum head
F07-mawp_statik_kafa | H-RHO2 | global_mawp | MPa | 1.7098156081206928 | 1.7098156081206928 | 0.0 | DOĞRULANDI | Clean-room UG-27(c)(1)/UG-32(d) equations; zero datum head | suite_governing=HEAD-R; mawp_row=1.70981561 MPa; IV(t_corroded=6.75, S=120.0, E=0.85); oracle_governing=HEAD-R; Clean-room UG-27(c)(1)/UG-32(d) equations; zero datum head
F07-mawp_statik_kafa | H-RHO3 | global_mawp | MPa | 1.7098156081206928 | 1.7098156081206928 | 0.0 | DOĞRULANDI | Clean-room UG-27(c)(1)/UG-32(d) equations; zero datum head | suite_governing=HEAD-R; mawp_row=1.70981561 MPa; IV(t_corroded=6.75, S=120.0, E=0.85); oracle_governing=HEAD-R; Clean-room UG-27(c)(1)/UG-32(d) equations; zero datum head
F07-mawp_statik_kafa | H-RHO4 | global_mawp | MPa | 1.7098156081206928 | 1.7098156081206928 | 0.0 | DOĞRULANDI | Clean-room UG-27(c)(1)/UG-32(d) equations; zero datum head | suite_governing=HEAD-R; mawp_row=1.70981561 MPa; IV(t_corroded=6.75, S=120.0, E=0.85); oracle_governing=HEAD-R; Clean-room UG-27(c)(1)/UG-32(d) equations; zero datum head
F07-mawp_statik_kafa | H-T1 | global_mawp | MPa | 0.8899692429804544 | 0.8899692429804544 | 0.0 | DOĞRULANDI | Clean-room UG-27(c)(1)/UG-32(d) equations; zero datum head | suite_governing=SHELL-01; mawp_row=0.889969243 MPa; IV(t_corroded=3.25, S=138.0, E=1.0); oracle_governing=SHELL-01; Clean-room UG-27(c)(1)/UG-32(d) equations; zero datum head
F07-mawp_statik_kafa | H-T2 | global_mawp | MPa | 1.3663366336633664 | 1.3663366336633664 | 0.0 | DOĞRULANDI | Clean-room UG-27(c)(1)/UG-32(d) equations; zero datum head | suite_governing=SHELL-01; mawp_row=1.36633663 MPa; IV(t_corroded=5.0, S=138.0, E=1.0); oracle_governing=SHELL-01; Clean-room UG-27(c)(1)/UG-32(d) equations; zero datum head
F07-mawp_statik_kafa | H-T3 | global_mawp | MPa | 1.7098156081206928 | 1.7098156081206928 | 0.0 | DOĞRULANDI | Clean-room UG-27(c)(1)/UG-32(d) equations; zero datum head | suite_governing=HEAD-R; mawp_row=1.70981561 MPa; IV(t_corroded=6.75, S=120.0, E=0.85); oracle_governing=HEAD-R; Clean-room UG-27(c)(1)/UG-32(d) equations; zero datum head
F07-mawp_statik_kafa | H-T4 | global_mawp | MPa | 1.7098156081206928 | 1.7098156081206928 | 0.0 | DOĞRULANDI | Clean-room UG-27(c)(1)/UG-32(d) equations; zero datum head | suite_governing=HEAD-R; mawp_row=1.70981561 MPa; IV(t_corroded=6.75, S=120.0, E=0.85); oracle_governing=HEAD-R; Clean-room UG-27(c)(1)/UG-32(d) equations; zero datum head
F07-mawp_statik_kafa | INVALID-NO-MATERIAL | global_mawp | MPa |  |  |  | KAPSAM_DIŞI | Geçersiz: malzeme yok; KAPSAM_DIŞI beklenir | suite_governing=SHELL-01; mawp_row=0 MPa; IV(t_corroded=None, S=None, E=None); oracle_governing=None; Geçersiz: malzeme yok; KAPSAM_DIŞI beklenir
F07-mawp_statik_kafa | PUB-CW-K1-01 | global_mawp | MPa | 2.1345975232198144 | 2.128 | 0.31003398589353043 | TEK_KAYNAK | Codeware COMPRESS Demo Vessel, K1-01, 308.73 psi converted to MPa | suite_governing=SHELL-01; mawp_row=2.13459752 MPa; IV(t_corroded=4.7625, S=137.895, E=1.0); oracle_governing=SHELL-01; K1-01 yayınlanmış silindir MAWP; statik kafa bileşen hesabı ayrı doğrulama gerektirir. Codeware COMPRESS Demo Vessel, K1-01, 308.73 psi converted to MPa
F08-test-basinci | R10-D0/hydrotest | hydrotest | MPa | 2.222760290556901 | 2.222760290556901 | 0.0 | DOĞRULANDI | clean-room UG-99(b)/UG-100 arithmetic | Pressure basis and LSR are suite intermediates; multiplier arithmetic only is independently checked.
F08-test-basinci | R10-D0/pneumatic_test | pneumatic_test | MPa | 1.8807971689327623 | 1.8807971689327623 | 0.0 | DOĞRULANDI | clean-room UG-99(b)/UG-100 arithmetic | Pressure basis and LSR are suite intermediates; multiplier arithmetic only is independently checked.
F08-test-basinci | R10-D1000/hydrotest | hydrotest | MPa | 2.222760290556901 | 2.222760290556901 | 0.0 | DOĞRULANDI | clean-room UG-99(b)/UG-100 arithmetic | Pressure basis and LSR are suite intermediates; multiplier arithmetic only is independently checked.
F08-test-basinci | R10-D1000/pneumatic_test | pneumatic_test | MPa | 1.8807971689327623 | 1.8807971689327623 | 0.0 | DOĞRULANDI | clean-room UG-99(b)/UG-100 arithmetic | Pressure basis and LSR are suite intermediates; multiplier arithmetic only is independently checked.
F08-test-basinci | R11-D0/hydrotest | hydrotest | MPa | 2.445036319612591 | 2.445036319612591 | 0.0 | DOĞRULANDI | clean-room UG-99(b)/UG-100 arithmetic | Pressure basis and LSR are suite intermediates; multiplier arithmetic only is independently checked.
F08-test-basinci | R11-D0/pneumatic_test | pneumatic_test | MPa | 2.0688768858260387 | 2.0688768858260387 | 0.0 | DOĞRULANDI | clean-room UG-99(b)/UG-100 arithmetic | Pressure basis and LSR are suite intermediates; multiplier arithmetic only is independently checked.
F08-test-basinci | R11-D1000/hydrotest | hydrotest | MPa | 2.445036319612591 | 2.445036319612591 | 0.0 | DOĞRULANDI | clean-room UG-99(b)/UG-100 arithmetic | Pressure basis and LSR are suite intermediates; multiplier arithmetic only is independently checked.
F08-test-basinci | R11-D1000/pneumatic_test | pneumatic_test | MPa | 2.0688768858260387 | 2.0688768858260387 | 0.0 | DOĞRULANDI | clean-room UG-99(b)/UG-100 arithmetic | Pressure basis and LSR are suite intermediates; multiplier arithmetic only is independently checked.
F08-test-basinci | R12-D0/hydrotest | hydrotest | MPa | 2.667312348668281 | 2.667312348668281 | 0.0 | DOĞRULANDI | clean-room UG-99(b)/UG-100 arithmetic | Pressure basis and LSR are suite intermediates; multiplier arithmetic only is independently checked.
F08-test-basinci | R12-D0/pneumatic_test | pneumatic_test | MPa | 2.2569566027193146 | 2.2569566027193146 | 0.0 | DOĞRULANDI | clean-room UG-99(b)/UG-100 arithmetic | Pressure basis and LSR are suite intermediates; multiplier arithmetic only is independently checked.
F08-test-basinci | R12-D1000/hydrotest | hydrotest | MPa | 2.667312348668281 | 2.667312348668281 | 0.0 | DOĞRULANDI | clean-room UG-99(b)/UG-100 arithmetic | Pressure basis and LSR are suite intermediates; multiplier arithmetic only is independently checked.
F08-test-basinci | R12-D1000/pneumatic_test | pneumatic_test | MPa | 2.2569566027193146 | 2.2569566027193146 | 0.0 | DOĞRULANDI | clean-room UG-99(b)/UG-100 arithmetic | Pressure basis and LSR are suite intermediates; multiplier arithmetic only is independently checked.
F08-test-basinci | R13-D0/hydrotest | hydrotest | MPa | 2.889588377723971 | 2.889588377723971 | 0.0 | DOĞRULANDI | clean-room UG-99(b)/UG-100 arithmetic | Pressure basis and LSR are suite intermediates; multiplier arithmetic only is independently checked.
F08-test-basinci | R13-D0/pneumatic_test | pneumatic_test | MPa | 2.445036319612591 | 2.445036319612591 | 0.0 | DOĞRULANDI | clean-room UG-99(b)/UG-100 arithmetic | Pressure basis and LSR are suite intermediates; multiplier arithmetic only is independently checked.
F08-test-basinci | R13-D1000/hydrotest | hydrotest | MPa | 2.889588377723971 | 2.889588377723971 | 0.0 | DOĞRULANDI | clean-room UG-99(b)/UG-100 arithmetic | Pressure basis and LSR are suite intermediates; multiplier arithmetic only is independently checked.
F08-test-basinci | R13-D1000/pneumatic_test | pneumatic_test | MPa | 2.445036319612591 | 2.445036319612591 | 0.0 | DOĞRULANDI | clean-room UG-99(b)/UG-100 arithmetic | Pressure basis and LSR are suite intermediates; multiplier arithmetic only is independently checked.
F08-test-basinci | R14-D0/hydrotest | hydrotest | MPa | 3.111864406779661 | 3.111864406779661 | 0.0 | DOĞRULANDI | clean-room UG-99(b)/UG-100 arithmetic | Pressure basis and LSR are suite intermediates; multiplier arithmetic only is independently checked.
F08-test-basinci | R14-D0/pneumatic_test | pneumatic_test | MPa | 2.633116036505867 | 2.633116036505867 | 0.0 | DOĞRULANDI | clean-room UG-99(b)/UG-100 arithmetic | Pressure basis and LSR are suite intermediates; multiplier arithmetic only is independently checked.
F08-test-basinci | R14-D1000/hydrotest | hydrotest | MPa | 3.111864406779661 | 3.111864406779661 | 0.0 | DOĞRULANDI | clean-room UG-99(b)/UG-100 arithmetic | Pressure basis and LSR are suite intermediates; multiplier arithmetic only is independently checked.
F08-test-basinci | R14-D1000/pneumatic_test | pneumatic_test | MPa | 2.633116036505867 | 2.633116036505867 | 0.0 | DOĞRULANDI | clean-room UG-99(b)/UG-100 arithmetic | Pressure basis and LSR are suite intermediates; multiplier arithmetic only is independently checked.
F08-test-basinci | R15-D0/hydrotest | hydrotest | MPa | 3.3341404358353515 | 3.3341404358353515 | 0.0 | DOĞRULANDI | clean-room UG-99(b)/UG-100 arithmetic | Pressure basis and LSR are suite intermediates; multiplier arithmetic only is independently checked.
F08-test-basinci | R15-D0/pneumatic_test | pneumatic_test | MPa | 2.8211957533991434 | 2.8211957533991434 | 0.0 | DOĞRULANDI | clean-room UG-99(b)/UG-100 arithmetic | Pressure basis and LSR are suite intermediates; multiplier arithmetic only is independently checked.
F08-test-basinci | R15-D1000/hydrotest | hydrotest | MPa | 3.3341404358353515 | 3.3341404358353515 | 0.0 | DOĞRULANDI | clean-room UG-99(b)/UG-100 arithmetic | Pressure basis and LSR are suite intermediates; multiplier arithmetic only is independently checked.
F08-test-basinci | R15-D1000/pneumatic_test | pneumatic_test | MPa | 2.8211957533991434 | 2.8211957533991434 | 0.0 | DOĞRULANDI | clean-room UG-99(b)/UG-100 arithmetic | Pressure basis and LSR are suite intermediates; multiplier arithmetic only is independently checked.
F08-test-basinci | R16-D0/hydrotest | hydrotest | MPa | 3.5564164648910417 | 3.5564164648910417 | 0.0 | DOĞRULANDI | clean-room UG-99(b)/UG-100 arithmetic | Pressure basis and LSR are suite intermediates; multiplier arithmetic only is independently checked.
F08-test-basinci | R16-D0/pneumatic_test | pneumatic_test | MPa | 3.00927547029242 | 3.00927547029242 | 0.0 | DOĞRULANDI | clean-room UG-99(b)/UG-100 arithmetic | Pressure basis and LSR are suite intermediates; multiplier arithmetic only is independently checked.
F08-test-basinci | R16-D1000/hydrotest | hydrotest | MPa | 3.5564164648910417 | 3.5564164648910417 | 0.0 | DOĞRULANDI | clean-room UG-99(b)/UG-100 arithmetic | Pressure basis and LSR are suite intermediates; multiplier arithmetic only is independently checked.
F08-test-basinci | R16-D1000/pneumatic_test | pneumatic_test | MPa | 3.00927547029242 | 3.00927547029242 | 0.0 | DOĞRULANDI | clean-room UG-99(b)/UG-100 arithmetic | Pressure basis and LSR are suite intermediates; multiplier arithmetic only is independently checked.
F08-test-basinci | MISSING-TEST-STRESS/hydrotest | hydrotest | MPa | 2.222760290556901 | 2.222760290556901 | 0.0 | DOĞRULANDI | clean-room UG-99(b)/UG-100 arithmetic | Pressure basis and LSR are suite intermediates; multiplier arithmetic only is independently checked.
F08-test-basinci | MISSING-TEST-STRESS/pneumatic_test | pneumatic_test | MPa | 1.8807971689327623 | 1.8807971689327623 | 0.0 | DOĞRULANDI | clean-room UG-99(b)/UG-100 arithmetic | Pressure basis and LSR are suite intermediates; multiplier arithmetic only is independently checked.
F08-test-basinci | INVALID-ZERO-PS/hydrotest | hydrotest | MPa |  |  |  | KAPSAM_DIŞI | clean-room UG-99(b)/UG-100 arithmetic | Pressure basis and LSR are suite intermediates; multiplier arithmetic only is independently checked.
F08-test-basinci | INVALID-ZERO-PS/pneumatic_test | pneumatic_test | MPa |  |  |  | KAPSAM_DIŞI | clean-room UG-99(b)/UG-100 arithmetic | Pressure basis and LSR are suite intermediates; multiplier arithmetic only is independently checked.
F08-test-basinci | K1-14/hydrotest | hydrotest pressure | psig |  | 204.1 |  | TEK_KAYNAK | sources-K1.md §K1-14 (Codeware/COMPRESS, 2021) | Published reference 204.1 psig; source reports software-rounded 205 psig.
F09-nozul-takviye | ratio-0.05-pad-0 | A_required | mm2 | 109.70279720279721 | 108.31889081455807 | 1.2776223776223739 | SAPMA | UG-37(c) independent | independent={'A': 108.31889081455807, 'A1': 306.6897746967071, 'A2': 315.6672443674177, 'A3': 0.0, 'A4': 0.0, 'A5': 0.0, 'total': 622.3570190641249, 'adequate': True, 'UG45_t_min': 1.5}; API ok=True error=None
F09-nozul-takviye | ratio-0.05-pad-1 | A_required | mm2 | 109.70279720279721 | 108.31889081455807 | 1.2776223776223739 | SAPMA | UG-37(c) independent | independent={'A': 108.31889081455807, 'A1': 306.6897746967071, 'A2': 315.6672443674177, 'A3': 0.0, 'A4': 306.6897746967071, 'A5': 0.0, 'total': 929.046793760832, 'adequate': True, 'UG45_t_min': 1.5}; API ok=True error=None
F09-nozul-takviye | ratio-0.1-pad-0 | A_required | mm2 | 219.40559440559443 | 216.63778162911615 | 1.2776223776223739 | SAPMA | UG-37(c) independent | independent={'A': 216.63778162911615, 'A1': 306.6897746967071, 'A2': 311.33448873483536, 'A3': 0.0, 'A4': 0.0, 'A5': 0.0, 'total': 618.0242634315425, 'adequate': True, 'UG45_t_min': 1.5}; API ok=True error=None
F09-nozul-takviye | ratio-0.1-pad-1 | A_required | mm2 | 219.40559440559443 | 216.63778162911615 | 1.2776223776223739 | SAPMA | UG-37(c) independent | independent={'A': 216.63778162911615, 'A1': 306.6897746967071, 'A2': 311.33448873483536, 'A3': 0.0, 'A4': 306.6897746967071, 'A5': 0.0, 'total': 924.7140381282496, 'adequate': True, 'UG45_t_min': 1.5}; API ok=True error=None
F09-nozul-takviye | ratio-0.2-pad-0 | A_required | mm2 | 438.81118881118886 | 433.2755632582323 | 1.2776223776223739 | SAPMA | UG-37(c) independent | independent={'A': 433.2755632582323, 'A1': 306.6897746967071, 'A2': 302.6689774696707, 'A3': 0.0, 'A4': 0.0, 'A5': 0.0, 'total': 609.3587521663778, 'adequate': True, 'UG45_t_min': 1.5}; API ok=True error=None
F09-nozul-takviye | ratio-0.2-pad-1 | A_required | mm2 | 438.81118881118886 | 433.2755632582323 | 1.2776223776223739 | SAPMA | UG-37(c) independent | independent={'A': 433.2755632582323, 'A1': 306.6897746967071, 'A2': 302.6689774696707, 'A3': 0.0, 'A4': 306.6897746967071, 'A5': 0.0, 'total': 916.0485268630849, 'adequate': True, 'UG45_t_min': 1.5}; API ok=True error=None
F09-nozul-takviye | ratio-0.35-pad-0 | A_required | mm2 | 767.9195804195805 | 758.2322357019066 | 1.2776223776223645 | SAPMA | UG-37(c) independent | independent={'A': 758.2322357019066, 'A1': 306.6897746967071, 'A2': 289.67071057192373, 'A3': 0.0, 'A4': 0.0, 'A5': 0.0, 'total': 596.3604852686308, 'adequate': False, 'UG45_t_min': 1.5}; API ok=True error=None
F09-nozul-takviye | ratio-0.35-pad-1 | A_required | mm2 | 767.9195804195805 | 758.2322357019066 | 1.2776223776223645 | SAPMA | UG-37(c) independent | independent={'A': 758.2322357019066, 'A1': 306.6897746967071, 'A2': 289.67071057192373, 'A3': 0.0, 'A4': 306.6897746967071, 'A5': 0.0, 'total': 903.0502599653379, 'adequate': True, 'UG45_t_min': 1.5}; API ok=True error=None
F09-nozul-takviye | ratio-0.5-pad-0 | A_required | mm2 | 1097.027972027972 | 1083.1889081455809 | 1.2776223776223554 | SAPMA | UG-37(c) independent | independent={'A': 1083.1889081455809, 'A1': 306.6897746967071, 'A2': 276.67244367417675, 'A3': 0.0, 'A4': 0.0, 'A5': 0.0, 'total': 583.3622183708839, 'adequate': False, 'UG45_t_min': 1.5}; API ok=True error=None
F09-nozul-takviye | ratio-0.5-pad-1 | A_required | mm2 | 1097.027972027972 | 1083.1889081455809 | 1.2776223776223554 | SAPMA | UG-37(c) independent | independent={'A': 1083.1889081455809, 'A1': 306.6897746967071, 'A2': 276.67244367417675, 'A3': 0.0, 'A4': 306.6897746967071, 'A5': 0.0, 'total': 890.051993067591, 'adequate': False, 'UG45_t_min': 1.5}; API ok=True error=None
F09-nozul-takviye | type-flanged | A_required | mm2 | 230.37587412587413 | 227.46967071057196 | 1.2776223776223645 | SAPMA | UG-37(c) independent | independent={'A': 227.46967071057196, 'A1': 149.5112651646447, 'A2': 0.0, 'A3': 0.0, 'A4': 0.0, 'A5': 0.0, 'total': 149.5112651646447, 'adequate': False, 'UG45_t_min': 1.5}; API ok=True error=None
F09-nozul-takviye | type-slip_on | A_required | mm2 | 230.37587412587413 | 227.46967071057196 | 1.2776223776223645 | SAPMA | UG-37(c) independent | independent={'A': 227.46967071057196, 'A1': 149.5112651646447, 'A2': 71.61434142114385, 'A3': 0.0, 'A4': 0.0, 'A5': 0.0, 'total': 221.12560658578855, 'adequate': False, 'UG45_t_min': 1.5}; API ok=True error=None
F09-nozul-takviye | type-socket_weld | A_required | mm2 |  | 227.46967071057196 |  | KAPSAM_DIŞI | UG-37(c) independent | independent={'A': 227.46967071057196, 'A1': 149.5112651646447, 'A2': 71.61434142114385, 'A3': 0.0, 'A4': 0.0, 'A5': 0.0, 'total': 221.12560658578855, 'adequate': False, 'UG45_t_min': 1.5}; API ok=False error={"detail":[{"type":"enum","loc":["body","nozzles",0,"nozzle_type"],"msg":"Input should be 'slip_on', 'socket_welded', 'coupling', 'manway', 'flanged' or 'pad_reinforced'","input":"socket_weld","ctx":{"expected":"'slip_on', 'socket_welded', 'coupling', 'manway', 'flanged' or 'pad_reinforced'"}}]}
F09-nozul-takviye | type-threaded | A_required | mm2 |  | 227.46967071057196 |  | KAPSAM_DIŞI | UG-37(c) independent | independent={'A': 227.46967071057196, 'A1': 149.5112651646447, 'A2': 71.61434142114385, 'A3': 0.0, 'A4': 0.0, 'A5': 0.0, 'total': 221.12560658578855, 'adequate': False, 'UG45_t_min': 1.5}; API ok=False error={"detail":[{"type":"enum","loc":["body","nozzles",0,"nozzle_type"],"msg":"Input should be 'slip_on', 'socket_welded', 'coupling', 'manway', 'flanged' or 'pad_reinforced'","input":"threaded","ctx":{"expected":"'slip_on', 'socket_welded', 'coupling', 'manway', 'flanged' or 'pad_reinforced'"}}]}
F09-nozul-takviye | type-manway | A_required | mm2 | 230.37587412587413 | 227.46967071057196 | 1.2776223776223645 | SAPMA | UG-37(c) independent | independent={'A': 227.46967071057196, 'A1': 149.5112651646447, 'A2': 71.61434142114385, 'A3': 0.0, 'A4': 0.0, 'A5': 0.0, 'total': 221.12560658578855, 'adequate': False, 'UG45_t_min': 1.5}; API ok=True error=None
F09-nozul-takviye | eff-0.7 | A_required | mm2 | 230.37587412587413 | 227.46967071057196 | 1.2776223776223645 | SAPMA | UG-37(c) independent | independent={'A': 227.46967071057196, 'A1': 149.5112651646447, 'A2': 0.0, 'A3': 0.0, 'A4': 0.0, 'A5': 0.0, 'total': 149.5112651646447, 'adequate': False, 'UG45_t_min': 1.5}; API ok=True error=None
F09-nozul-takviye | eff-0.85 | A_required | mm2 | 230.37587412587413 | 227.46967071057196 | 1.2776223776223645 | SAPMA | UG-37(c) independent | independent={'A': 227.46967071057196, 'A1': 149.5112651646447, 'A2': 0.0, 'A3': 0.0, 'A4': 0.0, 'A5': 0.0, 'total': 149.5112651646447, 'adequate': False, 'UG45_t_min': 1.5}; API ok=True error=None
F09-nozul-takviye | eff-1.0 | A_required | mm2 | 230.37587412587413 | 227.46967071057196 | 1.2776223776223645 | SAPMA | UG-37(c) independent | independent={'A': 227.46967071057196, 'A1': 149.5112651646447, 'A2': 0.0, 'A3': 0.0, 'A4': 0.0, 'A5': 0.0, 'total': 149.5112651646447, 'adequate': False, 'UG45_t_min': 1.5}; API ok=True error=None
F09-nozul-takviye | neck-4 | A_required | mm2 | 229.49825174825176 | 226.6031195840555 | 1.2776223776223687 | SAPMA | UG-37(c) independent | independent={'A': 226.6031195840555, 'A1': 153.34488734835355, 'A2': 0.0, 'A3': 0.0, 'A4': 0.0, 'A5': 0.0, 'total': 153.34488734835355, 'adequate': False, 'UG45_t_min': 1.5}; API ok=True error=None
F09-nozul-takviye | neck-8 | A_required | mm2 | 194.39335664335664 | 191.9410745233969 | 1.277622377622362 | SAPMA | UG-37(c) independent | independent={'A': 191.9410745233969, 'A1': 306.6897746967071, 'A2': 0.0, 'A3': 0.0, 'A4': 0.0, 'A5': 0.0, 'total': 306.6897746967071, 'adequate': True, 'UG45_t_min': 1.5}; API ok=True error=None
F09-nozul-takviye | neck-15 | A_required | mm2 | 132.9597902097902 | 131.28249566724438 | 1.2776223776223739 | SAPMA | UG-37(c) independent | independent={'A': 131.28249566724438, 'A1': 460.0346620450606, 'A2': 0.0, 'A3': 0.0, 'A4': 0.0, 'A5': 0.0, 'total': 460.0346620450606, 'adequate': True, 'UG45_t_min': 1.5}; API ok=True error=None
F09-nozul-takviye | pad-od-100 | A_required | mm2 | 230.37587412587413 | 227.46967071057196 | 1.2776223776223645 | SAPMA | UG-37(c) independent | independent={'A': 227.46967071057196, 'A1': 149.5112651646447, 'A2': 0.0, 'A3': 0.0, 'A4': 149.5112651646447, 'A5': 0.0, 'total': 299.0225303292894, 'adequate': True, 'UG45_t_min': 1.5}; API ok=True error=None
F09-nozul-takviye | pad-od-250 | A_required | mm2 | 230.37587412587413 | 227.46967071057196 | 1.2776223776223645 | SAPMA | UG-37(c) independent | independent={'A': 227.46967071057196, 'A1': 149.5112651646447, 'A2': 0.0, 'A3': 0.0, 'A4': 149.5112651646447, 'A5': 0.0, 'total': 299.0225303292894, 'adequate': True, 'UG45_t_min': 1.5}; API ok=True error=None
F09-nozul-takviye | pad-od-600 | A_required | mm2 | 230.37587412587413 | 227.46967071057196 | 1.2776223776223645 | SAPMA | UG-37(c) independent | independent={'A': 227.46967071057196, 'A1': 149.5112651646447, 'A2': 0.0, 'A3': 0.0, 'A4': 149.5112651646447, 'A5': 0.0, 'total': 299.0225303292894, 'adequate': True, 'UG45_t_min': 1.5}; API ok=True error=None
F09-nozul-takviye | PUB-K2-02-PVE-S5 | A_required | mm2 | 66.05668096153845 | 64.66107714038127 | 2.1583367968450022 | SAPMA | UG-37(c) independent | independent={'A': 64.66107714038127, 'A1': 69.79221421143849, 'A2': 79.39208069324091, 'A3': 0.0, 'A4': 0.0, 'A5': 0.0, 'total': 149.1842949046794, 'adequate': True, 'UG45_t_min': 1.5}; API ok=True error=None
F09-nozul-takviye | PUB-K2-17-IJERT | A_required | mm2 | 1880.9641608391607 | 1857.2357019064127 | 1.2776223776223594 | SAPMA | UG-37(c) independent | independent={'A': 1857.2357019064127, 'A1': 460.0346620450606, 'A2': 0.0, 'A3': 0.0, 'A4': 360.0, 'A5': 0.0, 'total': 820.0346620450606, 'adequate': False, 'UG45_t_min': 1.8572357019064125}; API ok=True error=None
F09-nozul-takviye | proj-0 | A_required | mm2 | 230.37587412587413 | 227.46967071057196 | 1.2776223776223645 | SAPMA | UG-37(c) independent | independent={'A': 227.46967071057196, 'A1': 149.5112651646447, 'A2': 0.0, 'A3': 0.0, 'A4': 0.0, 'A5': 0.0, 'total': 149.5112651646447, 'adequate': False, 'UG45_t_min': 1.5}; API ok=True error=None
F09-nozul-takviye | proj-10 | A_required | mm2 | 230.37587412587413 | 227.46967071057196 | 1.2776223776223645 | SAPMA | UG-37(c) independent | independent={'A': 227.46967071057196, 'A1': 149.5112651646447, 'A2': 71.61434142114385, 'A3': 0.0, 'A4': 0.0, 'A5': 0.0, 'total': 221.12560658578855, 'adequate': False, 'UG45_t_min': 1.5}; API ok=True error=None
F09-nozul-takviye | proj-100 | A_required | mm2 | 230.37587412587413 | 227.46967071057196 | 1.2776223776223645 | SAPMA | UG-37(c) independent | independent={'A': 227.46967071057196, 'A1': 149.5112651646447, 'A2': 71.61434142114385, 'A3': 0.0, 'A4': 0.0, 'A5': 0.0, 'total': 221.12560658578855, 'adequate': False, 'UG45_t_min': 1.5}; API ok=True error=None
F09-nozul-takviye | proj-250 | A_required | mm2 | 230.37587412587413 | 227.46967071057196 | 1.2776223776223645 | SAPMA | UG-37(c) independent | independent={'A': 227.46967071057196, 'A1': 149.5112651646447, 'A2': 71.61434142114385, 'A3': 0.0, 'A4': 0.0, 'A5': 0.0, 'total': 221.12560658578855, 'adequate': False, 'UG45_t_min': 1.5}; API ok=True error=None
F09-nozul-takviye | proj-500 | A_required | mm2 | 230.37587412587413 | 227.46967071057196 | 1.2776223776223645 | SAPMA | UG-37(c) independent | independent={'A': 227.46967071057196, 'A1': 149.5112651646447, 'A2': 71.61434142114385, 'A3': 0.0, 'A4': 0.0, 'A5': 0.0, 'total': 221.12560658578855, 'adequate': False, 'UG45_t_min': 1.5}; API ok=True error=None
F09-nozul-takviye | proj-1000 | A_required | mm2 | 230.37587412587413 | 227.46967071057196 | 1.2776223776223645 | SAPMA | UG-37(c) independent | independent={'A': 227.46967071057196, 'A1': 149.5112651646447, 'A2': 71.61434142114385, 'A3': 0.0, 'A4': 0.0, 'A5': 0.0, 'total': 221.12560658578855, 'adequate': False, 'UG45_t_min': 1.5}; API ok=True error=None
F10-nozul_yerlesim | SHELL-01 | clash_check | mm |  |  |  | KAPSAM_DIŞI | catalog clash_check | Catalog row emitted, but placement/distance is absent; categorical marker is not numeric comparison.
F10-nozul_yerlesim | SHELL-02 | clash_check | mm |  |  |  | KAPSAM_DIŞI | catalog clash_check | Catalog row emitted, but placement/distance is absent; categorical marker is not numeric comparison.
F10-nozul_yerlesim | SHELL-03 | clash_check | mm |  |  |  | KAPSAM_DIŞI | catalog clash_check | Catalog row emitted, but placement/distance is absent; categorical marker is not numeric comparison.
F10-nozul_yerlesim | SHELL-04 | clash_check | mm |  |  |  | KAPSAM_DIŞI | catalog clash_check | Catalog row emitted, but placement/distance is absent; categorical marker is not numeric comparison.
F10-nozul_yerlesim | SHELL-05 | clash_check | mm |  |  |  | KAPSAM_DIŞI | catalog clash_check | Catalog row emitted, but placement/distance is absent; categorical marker is not numeric comparison.
F10-nozul_yerlesim | SHELL-06 | clash_check | mm |  |  |  | KAPSAM_DIŞI | catalog clash_check | Catalog row emitted, but placement/distance is absent; categorical marker is not numeric comparison.
F10-nozul_yerlesim | SHELL-07 | clash_check | mm |  |  |  | KAPSAM_DIŞI | catalog clash_check | Catalog row emitted, but placement/distance is absent; categorical marker is not numeric comparison.
F10-nozul_yerlesim | SHELL-08 | clash_check | mm |  |  |  | KAPSAM_DIŞI | catalog clash_check | Catalog row emitted, but placement/distance is absent; categorical marker is not numeric comparison.
F10-nozul_yerlesim | SHELL-09 | clash_check | mm |  |  |  | KAPSAM_DIŞI | catalog clash_check | Catalog row emitted, but placement/distance is absent; categorical marker is not numeric comparison.
F10-nozul_yerlesim | SHELL-10 | clash_check | mm |  |  |  | KAPSAM_DIŞI | catalog clash_check | Catalog row emitted, but placement/distance is absent; categorical marker is not numeric comparison.
F10-nozul_yerlesim | SHELL-11 | clash_check | mm |  |  |  | KAPSAM_DIŞI | catalog clash_check | Catalog row emitted, but placement/distance is absent; categorical marker is not numeric comparison.
F10-nozul_yerlesim | SHELL-12 | clash_check | mm |  |  |  | KAPSAM_DIŞI | catalog clash_check | Catalog row emitted, but placement/distance is absent; categorical marker is not numeric comparison.
F10-nozul_yerlesim | SHELL-13 | clash_check | mm |  |  |  | KAPSAM_DIŞI | catalog clash_check | Catalog row emitted, but placement/distance is absent; categorical marker is not numeric comparison.
F10-nozul_yerlesim | SHELL-14 | clash_check | mm |  |  |  | KAPSAM_DIŞI | catalog clash_check | Catalog row emitted, but placement/distance is absent; categorical marker is not numeric comparison.
F10-nozul_yerlesim | SHELL-15 | clash_check | mm |  |  |  | KAPSAM_DIŞI | catalog clash_check | Catalog row emitted, but placement/distance is absent; categorical marker is not numeric comparison.
F10-nozul_yerlesim | SHELL-16 | clash_check | mm |  |  |  | KAPSAM_DIŞI | catalog clash_check | Catalog row emitted, but placement/distance is absent; categorical marker is not numeric comparison.
F10-nozul_yerlesim | SHELL-17 | clash_check | mm |  |  |  | KAPSAM_DIŞI | catalog clash_check | Catalog row emitted, but placement/distance is absent; categorical marker is not numeric comparison.
F10-nozul_yerlesim | SHELL-18 | clash_check | mm |  |  |  | KAPSAM_DIŞI | catalog clash_check | Catalog row emitted, but placement/distance is absent; categorical marker is not numeric comparison.
F10-nozul_yerlesim | SHELL-19 | clash_check | mm |  |  |  | KAPSAM_DIŞI | catalog clash_check | Catalog row emitted, but placement/distance is absent; categorical marker is not numeric comparison.
F10-nozul_yerlesim | SHELL-20 | clash_check | mm |  |  |  | KAPSAM_DIŞI | catalog clash_check | Catalog row emitted, but placement/distance is absent; categorical marker is not numeric comparison.
F10-nozul_yerlesim | SHELL-21 | clash_check | mm |  |  |  | KAPSAM_DIŞI | catalog clash_check | Catalog row emitted, but placement/distance is absent; categorical marker is not numeric comparison.
F10-nozul_yerlesim | SHELL-22 | clash_check | mm |  |  |  | KAPSAM_DIŞI | catalog clash_check | Catalog row emitted, but placement/distance is absent; categorical marker is not numeric comparison.
F10-nozul_yerlesim | SHELL-23 | clash_check | mm |  |  |  | KAPSAM_DIŞI | catalog clash_check | Catalog row emitted, but placement/distance is absent; categorical marker is not numeric comparison.
F10-nozul_yerlesim | SHELL-24 | clash_check | mm |  |  |  | KAPSAM_DIŞI | catalog clash_check | Catalog row emitted, but placement/distance is absent; categorical marker is not numeric comparison.
F10-nozul_yerlesim | SHELL-25 | clash_check | mm |  |  |  | KAPSAM_DIŞI | catalog clash_check | Catalog row emitted, but placement/distance is absent; categorical marker is not numeric comparison.
F10-nozul_yerlesim | SHELL-26 | clash_check | mm |  |  |  | KAPSAM_DIŞI | catalog clash_check | Catalog row emitted, but placement/distance is absent; categorical marker is not numeric comparison.
F10-nozul_yerlesim | SHELL-27 | clash_check | mm |  |  |  | KAPSAM_DIŞI | catalog clash_check | Catalog row emitted, but placement/distance is absent; categorical marker is not numeric comparison.
F10-nozul_yerlesim | SHELL-28 | clash_check | mm |  |  |  | KAPSAM_DIŞI | catalog clash_check | Catalog row emitted, but placement/distance is absent; categorical marker is not numeric comparison.
F10-nozul_yerlesim | SHELL-29 | clash_check | mm |  |  |  | KAPSAM_DIŞI | catalog clash_check | Catalog row emitted, but placement/distance is absent; categorical marker is not numeric comparison.
F10-nozul_yerlesim | SHELL-30 | clash_check | mm |  |  |  | KAPSAM_DIŞI | catalog clash_check | Catalog row emitted, but placement/distance is absent; categorical marker is not numeric comparison.
F11-dis_basinc | GRID-01 | Pa | MPa | 0.06435106806957137 | 0.06435106806957137 | 0.0 | DOĞRULANDI | UG-28(c)(1) bağımsız denklem | A kullanıcı girdisi; bağımsız grafik okunmadı.
F11-dis_basinc | GRID-02 | Pa | MPa | 0.01470881555875917 | 0.01470881555875917 | 0.0 | DOĞRULANDI | UG-28(c)(1) bağımsız denklem | A kullanıcı girdisi; bağımsız grafik okunmadı.
F11-dis_basinc | GRID-03 | Pa | MPa | 0.001378951458633672 | 0.001378951458633672 | 0.0 | DOĞRULANDI | UG-28(c)(1) bağımsız denklem | A kullanıcı girdisi; bağımsız grafik okunmadı.
F11-dis_basinc | GRID-04 | Pa | MPa | 0.045965048621122405 | 0.045965048621122405 | 0.0 | DOĞRULANDI | UG-28(c)(1) bağımsız denklem | A kullanıcı girdisi; bağımsız grafik okunmadı.
F11-dis_basinc | GRID-05 | Pa | MPa | 0.01011231069664693 | 0.01011231069664693 | 0.0 | DOĞRULANDI | UG-28(c)(1) bağımsız denklem | A kullanıcı girdisi; bağımsız grafik okunmadı.
F11-dis_basinc | GRID-06 | Pa | MPa | 0.002757902917267344 | 0.002757902917267344 | 0.0 | DOĞRULANDI | UG-28(c)(1) bağımsız denklem | A kullanıcı girdisi; bağımsız grafik okunmadı.
F11-dis_basinc | GRID-07 | Pa | MPa | 0.055158058345346886 | 0.055158058345346886 | 0.0 | DOĞRULANDI | UG-28(c)(1) bağımsız denklem | A kullanıcı girdisi; bağımsız grafik okunmadı.
F11-dis_basinc | GRID-08 | Pa | MPa | 0.008580142409276183 | 0.008580142409276183 | 0.0 | DOĞRULANDI | UG-28(c)(1) bağımsız denklem | A kullanıcı girdisi; bağımsız grafik okunmadı.
F11-dis_basinc | GRID-09 | Pa | MPa | 0.0024514692597931947 | 0.0024514692597931947 | 0.0 | DOĞRULANDI | UG-28(c)(1) bağımsız denklem | A kullanıcı girdisi; bağımsız grafik okunmadı.
F11-dis_basinc | GRID-10 | Pa | MPa | 0.03309483500720813 | 0.03309483500720813 | 0.0 | DOĞRULANDI | UG-28(c)(1) bağımsız denklem | A kullanıcı girdisi; bağımsız grafik okunmadı.
F11-dis_basinc | GRID-11 | Pa | MPa | 0.006128673149482988 | 0.006128673149482988 | 0.0 | DOĞRULANDI | UG-28(c)(1) bağımsız denklem | A kullanıcı girdisi; bağımsız grafik okunmadı.
F11-dis_basinc | GRID-12 | Pa | MPa | 0.0016853851161078217 | 0.0016853851161078217 | 0.0 | DOĞRULANDI | UG-28(c)(1) bağımsız denklem | A kullanıcı girdisi; bağımsız grafik okunmadı.
F11-dis_basinc | GRID-13 | Pa | MPa | 0.027579029172673443 | 0.027579029172673443 | 0.0 | DOĞRULANDI | UG-28(c)(1) bağımsız denklem | A kullanıcı girdisi; bağımsız grafik okunmadı.
F11-dis_basinc | GRID-14 | Pa | MPa | 0.002757902917267344 | 0.002757902917267344 | 0.0 | DOĞRULANDI | UG-28(c)(1) bağımsız denklem | A kullanıcı girdisi; bağımsız grafik okunmadı.
F11-dis_basinc | GRID-15 | Pa | MPa | 0.0012870213613914274 | 0.0012870213613914274 | 0.0 | DOĞRULANDI | UG-28(c)(1) bağımsız denklem | A kullanıcı girdisi; bağımsız grafik okunmadı.
F11-dis_basinc | GRID-16 | Pa | MPa | 0.012119681085896662 | 0.012119681085896663 | -1.4313276592693982e-14 | DOĞRULANDI | UG-28(c)(1) bağımsız denklem | A kullanıcı girdisi; bağımsız grafik okunmadı.
F11-dis_basinc | GRID-17 | Pa | MPa | 0.027579029172673446 | 0.027579029172673443 | 1.2580018427158051e-14 | DOĞRULANDI | UG-28(c)(1) bağımsız denklem | A kullanıcı girdisi; bağımsız grafik okunmadı.
F11-dis_basinc | GRID-18 | Pa | MPa | 0.007660841436853735 | 0.0076608414368537344 | 1.1322016584442247e-14 | DOĞRULANDI | UG-28(c)(1) bağımsız denklem | A kullanıcı girdisi; bağımsız grafik okunmadı.
F11-dis_basinc | GRID-19 | Pa | MPa | 0.0016853851161078217 | 0.0016853851161078217 | 0.0 | DOĞRULANDI | UG-28(c)(1) bağımsız denklem | A kullanıcı girdisi; bağımsız grafik okunmadı.
F11-dis_basinc | GRID-20 | Pa | MPa | 0.055158058345346886 | 0.055158058345346886 | 0.0 | DOĞRULANDI | UG-28(c)(1) bağımsız denklem | A kullanıcı girdisi; bağımsız grafik okunmadı.
F11-dis_basinc | GRID-21 | Pa | MPa | 0.002206322333813875 | 0.002206322333813875 | 0.0 | DOĞRULANDI | UG-28(c)(1) bağımsız denklem | A kullanıcı girdisi; bağımsız grafik okunmadı.
F11-dis_basinc | GRID-22 | Pa | MPa | 0.0012870213613914274 | 0.0012870213613914274 | 0.0 | DOĞRULANDI | UG-28(c)(1) bağımsız denklem | A kullanıcı girdisi; bağımsız grafik okunmadı.
F11-dis_basinc | GRID-23 | Pa | MPa | 0.07354407779379585 | 0.07354407779379585 | 0.0 | DOĞRULANDI | UG-28(c)(1) bağımsız denklem | A kullanıcı girdisi; bağımsız grafik okunmadı.
F11-dis_basinc | GRID-24 | Pa | MPa | 0.01034213593975254 | 0.01034213593975254 | 0.0 | DOĞRULANDI | UG-28(c)(1) bağımsız denklem | A kullanıcı girdisi; bağımsız grafik okunmadı.
F11-dis_basinc | GRID-25 | Pa | MPa | 0.0026265742069212805 | 0.0026265742069212805 | 0.0 | DOĞRULANDI | UG-28(c)(1) bağımsız denklem | A kullanıcı girdisi; bağımsız grafik okunmadı.
F11-dis_basinc | GRID-26 | Pa | MPa | 0.025280776741617324 | 0.025280776741617324 | 0.0 | DOĞRULANDI | UG-28(c)(1) bağımsız denklem | A kullanıcı girdisi; bağımsız grafik okunmadı.
F11-dis_basinc | GRID-27 | Pa | MPa | 0.011031611669069376 | 0.011031611669069376 | 0.0 | DOĞRULANDI | UG-28(c)(1) bağımsız denklem | A kullanıcı girdisi; bağımsız grafik okunmadı.
F11-dis_basinc | GRID-28 | Pa | MPa | 0.0689475729316836 | 0.0689475729316836 | 0.0 | DOĞRULANDI | UG-28(c)(1) bağımsız denklem | A kullanıcı girdisi; bağımsız grafik okunmadı.
F11-dis_basinc | GRID-29 | Pa | MPa | 0.0009193009724224481 | 0.0009193009724224481 | 0.0 | DOĞRULANDI | UG-28(c)(1) bağımsız denklem | A kullanıcı girdisi; bağımsız grafik okunmadı.
F11-dis_basinc | GRID-30 | Pa | MPa | 0.017236879766608582 | 0.017236879766608586 | -2.0128045208475916e-14 | DOĞRULANDI | UG-28(c)(1) bağımsız denklem | A kullanıcı girdisi; bağımsız grafik okunmadı.
F11-dis_basinc | K2-16-EMA-WP | Pa | MPa | 0.01211870251597809 | 0.01211870251597809 | 0.0 | DOĞRULANDI | UG-28(c)(1) bağımsız denklem | A kullanıcı girdisi; bağımsız grafik okunmadı.
F11-dis_basinc | K2-16-THICKNESS | Pa | MPa | 0.005931428439265594 | 0.005931428439265593 | 1.462315101445946e-14 | DOĞRULANDI | UG-28(c)(1) bağımsız denklem | A kullanıcı girdisi; bağımsız grafik okunmadı.
F12-mdmt | GRID-01:SHELL-01 | MDMT | °C | -29.0 |  |  | KAYNAK_BEKLİYOR | none | Catalog has no independent numeric curve reference for this point.
F12-mdmt | GRID-01:HEAD-L | MDMT | °C | -29.0 |  |  | KAYNAK_BEKLİYOR | none | Catalog has no independent numeric curve reference for this point.
F12-mdmt | GRID-01:HEAD-R | MDMT | °C | -29.0 |  |  | KAYNAK_BEKLİYOR | none | Catalog has no independent numeric curve reference for this point.
F12-mdmt | GRID-01:MDMT-GOVERNING | MDMT | °C | -29.0 |  |  | KAYNAK_BEKLİYOR | none | Catalog has no independent numeric curve reference for this point.
F12-mdmt | GRID-02:SHELL-01 | MDMT | °C | -29.0 |  |  | KAYNAK_BEKLİYOR | none | Catalog has no independent numeric curve reference for this point.
F12-mdmt | GRID-02:HEAD-L | MDMT | °C | -29.0 |  |  | KAYNAK_BEKLİYOR | none | Catalog has no independent numeric curve reference for this point.
F12-mdmt | GRID-02:HEAD-R | MDMT | °C | -29.0 |  |  | KAYNAK_BEKLİYOR | none | Catalog has no independent numeric curve reference for this point.
F12-mdmt | GRID-02:MDMT-GOVERNING | MDMT | °C | -29.0 |  |  | KAYNAK_BEKLİYOR | none | Catalog has no independent numeric curve reference for this point.
F12-mdmt | GRID-03:SHELL-01 | MDMT | °C | -29.0 |  |  | KAYNAK_BEKLİYOR | none | Catalog has no independent numeric curve reference for this point.
F12-mdmt | GRID-03:HEAD-L | MDMT | °C | -29.0 |  |  | KAYNAK_BEKLİYOR | none | Catalog has no independent numeric curve reference for this point.
F12-mdmt | GRID-03:HEAD-R | MDMT | °C | -29.0 |  |  | KAYNAK_BEKLİYOR | none | Catalog has no independent numeric curve reference for this point.
F12-mdmt | GRID-03:MDMT-GOVERNING | MDMT | °C | -29.0 |  |  | KAYNAK_BEKLİYOR | none | Catalog has no independent numeric curve reference for this point.
F12-mdmt | GRID-04:SHELL-01 | MDMT | °C | -23.0 |  |  | KAYNAK_BEKLİYOR | none | Catalog has no independent numeric curve reference for this point.
F12-mdmt | GRID-04:HEAD-L | MDMT | °C | -29.0 |  |  | KAYNAK_BEKLİYOR | none | Catalog has no independent numeric curve reference for this point.
F12-mdmt | GRID-04:HEAD-R | MDMT | °C | -29.0 |  |  | KAYNAK_BEKLİYOR | none | Catalog has no independent numeric curve reference for this point.
F12-mdmt | GRID-04:MDMT-GOVERNING | MDMT | °C | -23.0 |  |  | KAYNAK_BEKLİYOR | none | Catalog has no independent numeric curve reference for this point.
F12-mdmt | GRID-05:SHELL-01 | MDMT | °C | 2.0 |  |  | KAYNAK_BEKLİYOR | none | Catalog has no independent numeric curve reference for this point.
F12-mdmt | GRID-05:HEAD-L | MDMT | °C | -29.0 |  |  | KAYNAK_BEKLİYOR | none | Catalog has no independent numeric curve reference for this point.
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
F12-mdmt | EDGE-22:MDMT-GOVERNING | MDMT | °C | -29.0 |  |  | KAYNAK_BEKLİYOR | none | Catalog has no independent numeric curve reference for this point.
F12-mdmt | EDGE-23:SHELL-01 | MDMT | °C | -29.0 |  |  | KAYNAK_BEKLİYOR | none | Catalog has no independent numeric curve reference for this point.
F12-mdmt | EDGE-23:HEAD-L | MDMT | °C | -29.0 |  |  | KAYNAK_BEKLİYOR | none | Catalog has no independent numeric curve reference for this point.
F12-mdmt | EDGE-23:HEAD-R | MDMT | °C | -29.0 |  |  | KAYNAK_BEKLİYOR | none | Catalog has no independent numeric curve reference for this point.
F12-mdmt | EDGE-23:MDMT-GOVERNING | MDMT | °C | -29.0 |  |  | KAYNAK_BEKLİYOR | none | Catalog has no independent numeric curve reference for this point.
F12-mdmt | EDGE-24:SHELL-01 | MDMT | °C | -29.0 |  |  | KAYNAK_BEKLİYOR | none | Catalog has no independent numeric curve reference for this point.
F12-mdmt | EDGE-24:HEAD-L | MDMT | °C | -29.0 |  |  | KAYNAK_BEKLİYOR | none | Catalog has no independent numeric curve reference for this point.
F12-mdmt | EDGE-24:HEAD-R | MDMT | °C | -29.0 |  |  | KAYNAK_BEKLİYOR | none | Catalog has no independent numeric curve reference for this point.
F12-mdmt | EDGE-24:MDMT-GOVERNING | MDMT | °C | -29.0 |  |  | KAYNAK_BEKLİYOR | none | Catalog has no independent numeric curve reference for this point.
F12-mdmt | EDGE-25:SHELL-01 | MDMT | °C | -29.0 |  |  | KAYNAK_BEKLİYOR | none | Catalog has no independent numeric curve reference for this point.
F12-mdmt | EDGE-25:HEAD-L | MDMT | °C | -29.0 |  |  | KAYNAK_BEKLİYOR | none | Catalog has no independent numeric curve reference for this point.
F12-mdmt | EDGE-25:HEAD-R | MDMT | °C | -29.0 |  |  | KAYNAK_BEKLİYOR | none | Catalog has no independent numeric curve reference for this point.
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
