cakmacbum/bas-ncl-kap/pressure-vessel-suite/tools/campaign/tur7/api.csv

id | http_status | ok | api_value | api_A1 | api_A_total | error
T7A2-001 | 200 | True | 34.217721104076695
T7A2-002 | 200 | True | 3.386152065894071
T7A2-003 | 200 | True | 4.598191799256303
T7A2-004 | 200 | True | 17.37835907502118
T7A2-005 | 200 | True | 43.53939067099894
T7A2-006 | 200 | True | 9.762340739535272
T7A2-007 | 200 | True | 2.51223258196842
T7A2-008 | 200 | True | 39.49923241850287
T7A2-009 | 200 | True | 25.430739895328845
T7A2-010 | 200 | True | 0.7255879528664927
T7A2-011 | 200 | True | 1.644149622597081
T7A2-012 | 200 | True | 29.599214975102008
T7A2-013 | 200 | True | 5.972538008946564
T7A2-014 | 200 | True | 2.3303778377974536
T7A2-015 | 200 | True | 5.0059986569356605
T7A2-016 | 200 | True | 26.675497178068454
T7A2-017 | 200 | True | 4.434167317159629
T7A2-018 | 200 | True | 1.6543708257883472
T7A2-019 | 200 | True | 41.99123429838887
T7A2-020 | 200 | True | 13.024557332771359
T7A2-021 | 200 | True | 51.2583989480349
T7A2-022 | 200 | True | 11.524224035911688
T7A2-023 | 200 | True | 12.640042184612186
T7A2-024 | 200 | True | 35.3438136710031
T7A2-025 | 200 | True | 5.68979966353474
T7A2-026 | 200 | True | 34.255130284665185
T7A2-027 | 200 | True | 0.7964088504558698
T7A2-028 | 200 | True | 24.090366792716008
T7A2-029 | 200 | True | 32.556976959149566
T7A2-030 | 200 | True | 20.734843475320613
T7A2-031 | 200 | True | 4.4843382383481725
T7A2-032 | 200 | True | 2.178024475457027
T7A2-033 | 200 | True | 9.880666120519816
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
T7A2-298 | 200 | True | 15000.898545343376 | 0.0 | 263.7349115965245
T7A2-299 | 200 | True | 3905.940128071149 | 1438.5624614288504 | 1829.4840777110078
T7A2-300 | 200 | True | 7144.5194461268375 | 0.0 | 707.747923709686
