cakmacbum/bas-ncl-kap/pressure-vessel-suite/deneme-tasarimi.stl

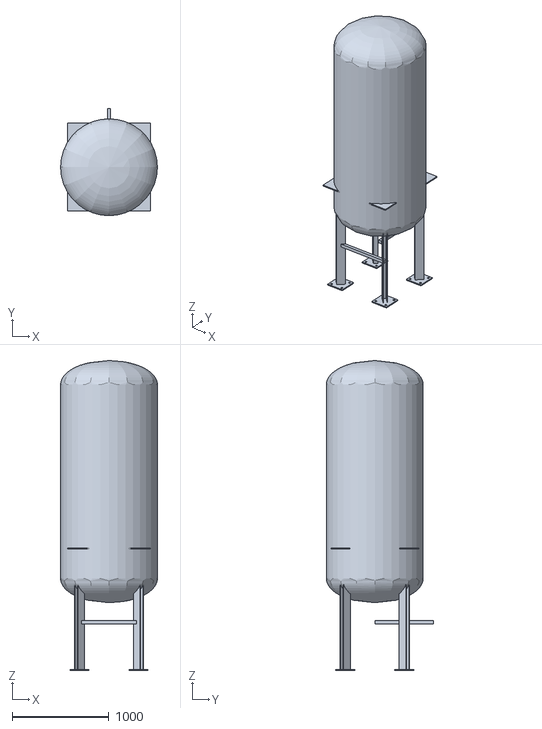
[picture p1: CAD file, 2026-09-24, last stored version]
pressure-vessel-suite/deneme-tasarimi.stl
1000.0 x 1108.1 x 3200.0
