cakmacbum/bas-ncl-kap/pressure_vessel_u_profile_legs_concept_mm.stl

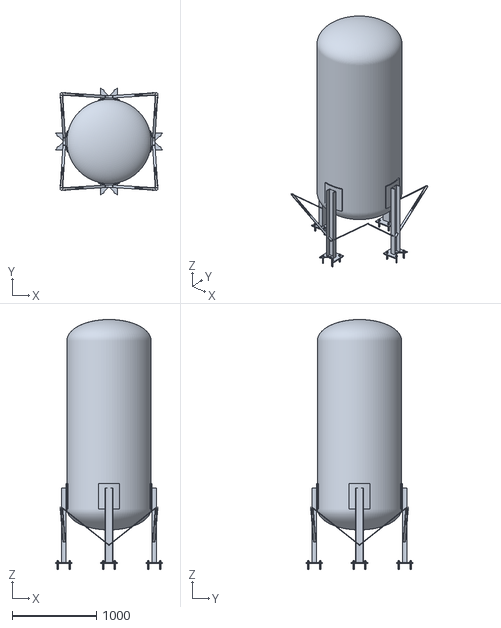
[picture p2: CAD file, 2026-09-24, last stored version]
pressure_vessel_u_profile_legs_concept_mm.stl
1274.0 x 1274.0 x 2970.0
