cakmacbum/bas-ncl-kap/.project-ai/paketler/P03-step-ui.RAPOR.md

# RAPOR P03-step-ui

> Yürütücü: Codex gpt-6-luna·medium (yaz) · 2026-10-06 22:47
> Worktree: /c/Users/yusuf/.orkestra-wt/BASINCLI-KAP/P03 · Dal: ork/P03 · Taban: 4743bbf

P03 STEP içe aktarma + STL görüntüleme — KISMİ  
Dosyalar: [StepImportDrawer.tsx](C:/Users/yusuf/.orkestra-wt/BASINCLI-KAP/P03/pressure-vessel-suite/apps/web-ui/src/StepImportDrawer.tsx), [types.ts](C:/Users/yusuf/.orkestra-wt/BASINCLI-KAP/P03/pressure-vessel-suite/apps/web-ui/src/types.ts), [api.ts](C:/Users/yusuf/.orkestra-wt/BASINCLI-KAP/P03/pressure-vessel-suite/apps/web-ui/src/api.ts), [pages.tsx](C:/Users/yusuf/.orkestra-wt/BASINCLI-KAP/P03/pressure-vessel-suite/apps/web-ui/src/pages.tsx) · Test: `npm.cmd run build` → koşamadı (`tsc` bulunamadı; bağımlılıklar kurulu değil) · Sözleşme: sapma: derleme doğrulaması yapılamadı · Açık soru / risk: UI/TypeScript derlemesi doğrulanmalı.
```
 .../apps/web-ui/src/StepImportDrawer.tsx           | 70 ++++++++++++++++++++++
 pressure-vessel-suite/apps/web-ui/src/api.ts       | 17 ++++++
 pressure-vessel-suite/apps/web-ui/src/pages.tsx    | 20 ++++++-
 pressure-vessel-suite/apps/web-ui/src/types.ts     | 13 ++++
 4 files changed, 118 insertions(+), 2 deletions(-)
```
