cakmacbum/bas-ncl-kap/.project-ai/paketler/T08-step-roundtrip.RAPOR.md

# RAPOR T08-step-roundtrip

> Yürütücü: Codex gpt-6-luna·medium (yaz) · 2026-10-17 18:22
> Worktree: /c/Users/yusuf/.orkestra-wt/BASINCLI-KAP/T08 · Dal: ork/T08 · Taban: 63434ed

T08 step-roundtrip — TAMAM
Dosyalar: `tools/campaign/tur2/t08_step_roundtrip/{cases.py,run.py,results.json}`, `tools/campaign/tur2/__init__.py`, `docs/validation/campaign-2026-10/tur2/T08-step-roundtrip.md` · Test: `python -m tools.campaign.tur2.t08_step_roundtrip.run` → 20 vaka, 20 GEÇTİ · Sözleşme: uyuldu · Açık soru / risk: Yok; oluşturulan 10 tank düz bombeli ve nozülsüz örneklerdir.
```
 .../campaign-2026-10/tur2/T08-step-roundtrip.md    |  17 +
 .../campaign-2026-10/tur2/T08-step-roundtrip.md    |  14 +
 .../tools/campaign/tur2/__init__.py                |   1 +
 .../campaign/tur2/t08_step_roundtrip/__init__.py   |   1 +
 .../campaign/tur2/t08_step_roundtrip/cases.py      |  17 +
 .../campaign/tur2/t08_step_roundtrip/results.json  | 942 +++++++++++++++++++++
 .../tools/campaign/tur2/t08_step_roundtrip/run.py  |  96 +++
 7 files changed, 1088 insertions(+)
```
