cakmacbum/bas-ncl-kap/pressure-vessel-suite/docs/validation/engineering-source-review-2026-09-30.md

# Mühendislik Kaynak İncelemesi — 30.09.2026

Bu not, destek hesabındaki dört tartışmalı konunun erişilebilir kaynaklarla yapılan masa başı incelemesidir. İnceleme lisanslı ASME, Moss PVDM, Megyesy ve WRC tablolarının yerine geçmez; lisanslı çizelge/veri kopyası içermez. Bir denklem ailesinin kaynakta bulunması, uygulamadaki bütün işaret, geometri ve sınır koşullarının doğrulandığı anlamına gelmez.

## 1. Yatay kapta Zick eyer gerilmeleri

**Birincil kaynak:** L. P. Zick, “Stresses in Large Horizontal Cylindrical Pressure Vessels on Two Saddle Supports,” *Welding Journal Research Supplement*, 30 (1951), 435–445; burada erişilen 12 sayfalık nüsha, yazarın ekleme/düzeltmelerini içeren 1971 yeniden basımıdır ([PDF](https://files.engineering.com/files/0b6515ce-1983-42ec-8f44-f5b840f953d7/Stresses_in_Large_Horizontal_Cylindrical_Pressure_Vessel_Zick.pdf)). Sonraki bağımsız değerlendirme ve deney/FE karşılaştırmaları için Duan & Hu, 2016, DOI 10.1177/0954408914547788 ([makale özeti ve kaynakçası](https://journals.sagepub.com/doi/10.1177/0954408914547788)); deney/teori karşılaştırma kaynağı olarak Tooth et al., *Journal of Strain Analysis* 17 (1982), 169–176 (DOI kaydı makale kaynakçasında listelenmiştir).

- Zick metni boyuna kiriş momenti/gerilmesini, teğetsel kesmeyi, eyer boynuzundaki çevresel gerilmeyi, eyer tabanındaki halka basmasını ve başlık yakınındaki ilave başlık gerilmesini ayrı fiziksel kontroller olarak kurar. Etkin kabuk genişliği için ana metindeki eski `10t` yaklaşımına ek notta `1.56√(R·t)` değeri verilir; kodun etkin genişlik terimi bu ek notla uyumludur.
- Zick’in özgün notasyonu ile Moss/Megyesy prosedürlerinde kullanılan `S1…S5` adlandırmasının bire bir aynı olduğu doğrulanmadı. Özellikle özgün metinde S3, boynuzdaki çevresel birleşik gerilme bağlamında görünür; mevcut uygulamadaki `S3` başlık kesmesi, `S5` eyer altı basması olarak adlandırılmıştır. Bu nedenle kod yorumlarındaki Moss prosedür adları Zick’in özgün `S3/S5` etiketleri diye sunulmamalı; kaynak/edition belirtilen bir çapraz eşleme tabloya ihtiyaç var.
- Özgün makale boyuna S1’in çekme **veya** basma olabileceğini, çekmenin basınçtan gelen boyuna gerilme ile birleştirilmesini; basmanın ise basma akma noktasının yarısı veya ilgili burkulma sınırı ile sınanmasını söyler. Fakat erişilebilir Zick nüshası `K1′` için çekme ve basma tarafına ayrı katsayı uygulayan Moss çizelgesini doğrulamıyor. Mevcut tek `K1` ile iki tarafı hesaplamak, `K1′` ayrımı bakımından doğrulanmış sayılmaz.
- Başlık yakınındaki kesme için kaynak ayrı kabuk ve başlık kesme denklemi verir ve başlık için %25 artırılmış sınır önerir. Erişilebilir kaynağın katsayı çizelgeleri grafik olarak yer aldığından OCR metninden katsayıların sayısal değerleri güvenilir biçimde alınamadı. Dolayısıyla uygulamanın `S3 = K3·Q/(R·t_h)` girdisi ve Moss katsayı adları formül yapısı bakımından makul olsa da sayısal katsayı/işaret ve `A ≤ R/2` geçişiyle yayınlanmış örnek düzeyinde doğrulanmış değildir.
- Eyer tabanında kaynak, eyer genişliğine ek olarak her iki yanda `5t` etkili kabuk genişliğini ve basma akma dayanımının yarısı sınırını açıkça tarif eder; ek, `1.56√(R·t)` etkin genişliğini verir. Uygulamadaki `S5 = K7·Q/[t·(b + 1.56√(R·t))]` ifadesi ancak lisanslı K7 tanımı bu normalizasyonla eşleşiyorsa doğrulanabilir; mevcut açık kaynaktan K7 formülü/katsayı normalizasyonu doğrulanamadı.
- Erişilebilir çalışılmış sayısal eyer örneği bulunamadı. **Bağımsız doğrulama önerisi:** Zick 1951 içindeki strain-gauge ölçümü sunulan 30,000 gal tank ve 1982 Tooth et al. deney karşılaştırmasını kaynak kurum/dergi erişimiyle temin edip geometri, doluluk ve malzeme verisini çıkarın; ölçüm/FE sonuçlarını tek bir sayısal regresyon olgusu olarak, ayrıca simetrik yük ve statik reaksiyon limit testlerinden ayrı tutun. Duan & Hu (2016) çoklu eyer içindir; iki eyer uygulamasını tek başına doğrulayan örnek değildir.

## 2. Etek basması: `Ro/t`, UG-23(b) ve `E = 0.6`

**Kaynaklar:** ASME BPVC VIII-1, 2025, UG-23(b) ve dış basınç için UG-28/ilgili malzeme çizelgeleri (erişilebilir kopya: [2025 metin PDF](https://tg.government.bg/docu/dokladi2019/ASME%20BPVC.VIII.1%20%28ASME%20BPVC%20Section%208%20Division%201%29%202025.pdf)); Zick 1951/1971 yeniden basımı yukarıdaki linkte; Moss *Pressure Vessel Design Manual*, 3. baskı, “Design of Vessel Supports / Skirt Supports” ([katalog/önizleme kaynağı](https://eopcw.com/find/downloadFiles/364)); bağımsız yayınlanmış iş örneği, 2023 tarihli hesap raporu ([örnek](https://www.scribd.com/document/920086818/Design-Calculations-Eulution-Coloum)).

- `Ro/t` tek başına izin verilen gerilme değildir. VIII-1 dış basınç/burkulma yöntemi uygun geometri ve malzeme sıcaklığıyla A/B çizelge/çizgilerinin izlenmesini gerektirir; 2025 metni A faktörünün seçilmiş `Ro` ve `t` ile bulunmasını, B ile izin verilen değerin belirlenip hesaplanan boyuna basma gerilmesiyle karşılaştırılmasını tarif eder. Zick’in “UG-23(b)” göndermesi de B değerinin genel amaçlı sabit bir sayı olmadığını destekler. Kullanıcının bir B değeri girmesi, yalnızca B’nin doğru malzeme/ısı/et kalınlığı/yarıçap ve uygun Code edition’dan elde edildiği durumda doğrulanabilir.
- İncelenen yazılım açıklamasındaki `A = 0.125/(Ro/t)` ve `B` hesabını kullanan yayımlanmış rapor örneği, bu iş akışına örnek teşkil eder; bu tek rapor normatif kaynak değildir. Kodda kullanıcı girdili B için bağımsız uygulama testi önerisi: aynı malzeme, sıcaklık ve `Ro/t` için lisanslı VIII-1 eğrisinden en az üç nokta (düşük/orta/yüksek `Ro/t`) alıp çizelge interpolasyonu ve `min(S,B)` kararını karşılaştırmak; basma gerilmesinin B eşiğini iki yanında geçtiği sınır örneklerini eklemek.
- `E=0.6` evrensel ASME varsayımı olarak doğrulanmadı. Erişilebilir eski handbook örnekleri eyer/etek bağlantı **detayına** bağlı biçimde butt weld için 0.6, lap weld için 0.45 (başka basımda 0.5) kullanıyor; örnekler arasında dahi detay/edition farkı var. ASME VIII-1’in UW-12 joint efficiency tablosu basınç taşıyan birleşim türü ve muayeneye bağlıdır; bunu her destek kaynağına varsayılan aktarmak gerekçelendirilmemiştir. VIII-2 2025 attachment-weld yaklaşımı kaynak tipine göre etkin kesit ve azaltma faktörleri tarif eder; ayrıca tasarım rejimi ve geometri değişir. Böylece varsayılan `0.6`, seçilen metot ve kaynak detayı belirtilmediği sürece yalnız **varsayım** olarak etiketlenmeli; tasarım onayı diye gösterilmemelidir.
- Kapsamı tamamlamak için kaynaklı birleşimin gerçek detayı, tam nüfuziyet/fillet türü, etkin boğaz/uzunluk, en zayıf malzeme ve uygun code route gerekir. Basit `M/Z − W/A ≤ S·E` kontrolü etek-gövde birleşiminin yerel eğilmesini, nozul/kesit süreksizliklerini, kaynak tasarımını veya taban ankrajını kapsamaz; bu sebeple tam etek tasarım onayı vermez.

## 3. Blodgett çizgi-kaynak grubu `Sw`

**Kaynak:** Omer W. Blodgett, *Design of Welded Structures*, Lincoln Electric / James F. Lincoln Arc Welding Foundation, bölüm 7.4, özellikle §7.4/1–8 ve “Table 5—Properties of Weld Treated as Line” (açık web nüshası: [Scribd taraması](https://www.scribd.com/doc/201562514/Blodgett-Design-of-Welded-Structures)). Nüsha basım yılı/edition bilgisini güvenilir şekilde göstermediği ve üçüncü taraf tarama olduğu için formüller kitaptan satır satır aktarılmamıştır. Formüller aşağıda çizgi geometrisinden bağımsız integralle de denetlenmiştir.

- Blodgett yöntemi kaynak kesitini çizgi kabul eder: birim uzunluk başına birincil kuvvet `F/Lw`, eğilme kuvveti `M/Sw`; birleştirilen kuvvet bileşenleri aynı kaynak konumunda vektörel olarak toplanır. Bu, uygulamadaki `Lw`, `Sw`, boğaz `0.707z` dönüşümünün yaklaşımını destekler; **AWS D1.1 izin verilen gerilme katsayısını** Blodgett geometrisi doğrulamaz.
- Mevcut basit ideal konturların geometrik kontrolü: kapalı dikdörtgen `Lw=2(b+d)`, `Sw=bd+d²/3`; üç kenarlı C/U çizgisi `Lw=2b+d`, `Sw=bd+d²/6`; daire `Lw=πD`, `Sw=πD²/4`. Bunlar, çizgi atalet momenti `Iw = ∫y² ds` ve uç lif `c=d/2` üzerinden `Sw=Iw/c` ile elde edilir. İki paralel dikiş için `Sw=d²/3` yalnız kodun tanımladığı eğilme ekseni ve `d` boyunca dağılan çizgiler için geçerlidir; eksen yönü ters çevrilirse formül değişir.
- **Bağımsız test verisi önerisi:** bir dikdörtgen örnek `b=100 mm, d=200 mm` için `Lw=600 mm`, `Sw=33,333.333 mm²`; C/U örnek aynı boylarda `Lw=400 mm`, `Sw=26,666.667 mm²`. Bu değerleri çizgi integraliyle kıyaslayan altın test oluşturun. Köşebentteki “iki paralel kenar” yaklaşımı, kesintili kaynak/krater düzeltmesi ve temas oranıyla `Sw`’yi doğrusal azaltma Blodgett’ın tam geometri tablosu değildir; son ikisi ayrıca varsayım/idealizasyon olarak belirtilmelidir. Islak alan veya gerçek kaynak et kalınlığı, çizgi-kaynak kesit modülüne eklenmez.

## 4. WRC 107/537 boyut analizi ve sınırlar

**Kaynaklar:** WRC Bulletin 107, Mart 1979 revizyonu; WRC Bulletin 537, 2010 (WRC’nin yayımladığı 107’nin kontrol edilmiş yeniden sunumu; yeni yöntem/revizyon olduğu iddiası yoktur). Yayıncıya ilişkin açıklama ve kapsam özeti: [ASME Standards Technology LLC, STP-PT-074 (2015)](https://www.asme.org/codes-standards/find-codes-standards/local-stresses-in-nozzles-in-shells-and-formed-heads-from-external-loads); [WRC 537 yayıncı ürün/önizlemesi](https://store.accuristech.com/wrc/products/preview/3060583). Lisanslı eğri/katsayı tabloları bu incelemede kopyalanmadı. Uygulanabilirlik için ikincil, yöntem adımlarına dayalı özet: [WRC yöntem notu](https://uploads.teachablecdn.com/attachments/KMmYEW2YRmoRv7cynUFw_WRC.pdf).

- Boyut analizi kodun yük normalizasyonunun iç tutarlılığını destekler. Kuvvet türü `F` yükünde membran bileşkesi `N ∝ F/Rm` (kuvvet/birim boy), moment bileşkesi `M ∝ F`; çift/kuvvet-moment türü `M0` yükünde `N ∝ M0/Rm²`, `M ∝ M0/Rm`. Kabuk gerilmeleri sonrasında `Nx/T` ve `6Mx/T²` ölçeği taşır. Bunlar katsayı eğrilerinin doğruluğunu veya doğru eğrinin seçildiğini doğrulamaz.
- STP-PT-074 (2015) WRC 107/537 alanını silindirik/küresel kabukta harici yükler ve boyutsuz eğrilerle yerel gerilme olarak ele alır; rapor, geniş geometri aralıkları için analiz ve FEA/deney/korelasyon karşılaştırmaları sunmayı amaçlar. WRC 537 ürün notu 107’nin 1979 ilişkilerini programlamayı kolaylaştıran baskısı der; lisanslı katsayıların kendisi olmadan kodun tablo okuma/enterpolasyon adımı sınanmış sayılmaz.
- İkincil açık yöntem özeti, uygulama için `d/D < 0.33` ve `Dm/T > 50` pratik uygunluk kapısı verir; WRC 537’nin geniş raporlama aralığı ise `D/T=7…2500`, `d/D=0…0.7`, `t/T=0.1…10` olarak tanıtılır. Bunlar farklı düzeyde kapsam/uygulama koşullarıdır; yalnız `D/T∈[7,2500]` kapısı tek başına WRC kullanımını kanıtlamaz. Özellikle ayak/ped için attachment boyut oranları, sınır yakınlığı, shell geometry, yük bileşeni ve katsayı yüzeyi uygunluğu lisanslı bültenden ayrıca kontrol edilmelidir.
- **Önerilen bağımsız regresyon:** STP-PT-074’ün açıkça yayımlanmış sayısal örnek/karşılaştırma tablolarından erişilebilen bir silindirik kabuk yükleme örneğini seçin, ilgili WRC katsayılarını yalnız lisanslı nüshadan okuyun ve `Nx,Ny,Mx,My` ile nihai gerilmeleri ayrı ara değerlerde karşılaştırın. Kaynağın sayısal örnek verisi ve test girdileri bu incelemede çıkarılamadı; bu nedenle mevcut code path yayınlanmış örnekle doğrulandı denemez. Katsayılar gizli kaldığı sürece yalnız katsayı=1 boyutsal ölçekleme testleri kullanılabilir, fakat bunlar fiziksel doğrulama değildir.

## Kaynak erişimi ve doğrulama durumu

| Başlık | Kaynakla doğrulanan | Açık kalan |
|---|---|---|
| Zick | Fiziksel kontrol aileleri, etkin genişlik notu, gerilme sınırı yaklaşımının genel yapısı | Moss/Megyesy katsayı eşlemesi; `K1′`; özgün ve revize `S3/S5` isimlerinin kodla eşlemesi; sayısal katsayı/örnek reproduksiyonu |
| Etek | UG-23(b) basma sınırının geometri/malzeme eğrisine dayalı seçimi; detayın önemine dair yayınlanmış handbook örnekleri | Bu projede kullanılan tek `B` değerinin bağımsız chart readback’i; 0.6’nin gerçek birleşim detayına uygulanabilirliği |
| Blodgett | Çizgi kaynak kabulü ve yük/birim boy yöntemi; temel geometri formüllerinin integral denetimi | Kapsamlı kaynak yerleşimi, kesik/kısmi kontur, gerçek joint strength ve AWS kapasite katsayısı |
| WRC | Kuvvet/moment ölçeklerinin boyutsal tutarlılığı; WRC 107/537 amacı ve genel kapsamı | Lisanslı katsayı okuma/enterpolasyon, attachment uygulanabilirliği, yayınlanmış sayısal örnek reproduksiyonu |
