cakmacbum/bas-ncl-kap/pressure-vessel-suite/docs/validation/campaign-2026-10/OZET.md

# Doğrulama kampanyası özeti

Toplam vaka: 1302

## Aile × etiket matrisi

| Aile | DOĞRULANDI | FORMÜLASYON_FARKI | SAPMA | TEK_KAYNAK | KAYNAK_BEKLİYOR | KAPSAM_DIŞI | Toplam |
|---|---:|---:|---:|---:|---:|---:|---:|
| F01-govde-ug27 | 75 | 0 | 9 | 2 | 0 | 12 | 98 |
| F02-bombe_eliptik | 58 | 0 | 2 | 0 | 0 | 2 | 62 |
| F03-bombe-torisferik | 93 | 0 | 0 | 0 | 3 | 0 | 96 |
| F04-bombe-yarimkure | 34 | 0 | 34 | 0 | 0 | 2 | 70 |
| F05-duz_kapak_ug34 | 27 | 0 | 5 | 0 | 0 | 2 | 34 |
| F06-koni | 20 | 12 | 0 | 0 | 0 | 16 | 48 |
| F07-mawp_statik_kafa | 28 | 0 | 0 | 1 | 0 | 1 | 30 |
| F08-test-basinci | 30 | 0 | 0 | 1 | 0 | 2 | 33 |
| F09-nozul-takviye | 0 | 0 | 30 | 0 | 0 | 2 | 32 |
| F10-nozul_yerlesim | 0 | 0 | 0 | 0 | 0 | 30 | 30 |
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
