cakmacbum/bas-ncl-kap/(commit log)

2026-07-25 Basınçlı Kap Suite — ilk commit (Faz 0: sürüm kontrolü)
    25.000 satırlık kod tabanı bugüne dek sürüm kontrolsüz, OneDrive senkron
    klasöründe duruyordu. Münazara konseyi bunu üç turda üç kez portföyün en
    büyük tekil varlık riski olarak işaretledi.
    Kapsam: 17 Python paketi (domain, calc-core, code-asme-viii-1, code-en-13445,
    ped-2014-68-eu, compliance, nozzles, welds, cad-engine, report-engine,
    external-pressure, flanges, supports, fea, materials, mdmt, units),
    FastAPI servisi, React/TS web arayüzü, 483 test, standart manifestleri ve
    proje şartname dokümanları.
    .gitignore: türetilmiş çıktılar, node_modules, FEA ara dosyaları ve
    "Hesaplama vs/" (K6 — te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
2026-07-25 Faz 1: bağımsız doğrulama turu 1 — UG-99(b)/UG-100 test basıncı sapması düzeltildi
    İki ayrı ticari yazılımın yayımlanmış hesap setiyle (PV Elite 2017 ve Advanced
    Pressure Vessel 10.1.5, ikisi de Pressure Vessel Engineering Ltd. tarafından
    yayımlanmış) 9 vaka karşılaştırıldı. 4 doğrulandı, 3 formülasyon farkı olarak
    kayda geçti, 1 gerçek sapma bulundu.
    SAPMA — UG-99(b) hidrostatik ve UG-100 pnömatik test basıncı:
    Her iki hesap da tabana tasarım basıncını alıyordu. UG-99(b) tabanı MAWP'dir;
    endnote tasarım basıncına yalnızca MAWP hesaplanmadığında izin verir. Bu suite
    MAWP'yi hesapladığı için muafiyet geçerli değil. MAWP >= P_tasarım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
2026-07-25 Faz 1 tur 2: torisferik + yarım küre doğrulandı — varsayılan büküm yarıçapı sapması düzeltildi
    Tur 1'in iki açık maddesi için kaynak arandı ve bulundu (ikisi de PVEng, K-A):
    - F&D Heads 2.02 anma tablosu (S=16000 psi): torisferik MAWP, 90 nokta tarandı,
    tipik fark %0.03-0.05, en büyük %0.29. Tablodaki kalınlıkların yuvarlanmış
    kesirler olduğu (0.063 = 1/16) tespit edildi; kesirle karşılaştırınca en büyük
    fark %0.771 -> %0.29'a düşüyor.
    - "Comparison Between Head Types" makalesi: yarım küre (-0.053%), 2:1 eliptik
    iç çap formuyla (-0.033%), F&D taç yarıçapı = dış çap tespiti.
    SAPMA — torisferik varsayılan büküm yarıçapı:
    design_c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
2026-07-25 Faz 2 (FEA lab): elastik malzeme alanları + 1/8 simetri geometrisi + yüzey etiketleme
    Bu bir doğrulama laboratuvarıdır, ürün özelliği değil; çözücü (CalculiX) hâlâ
    kurulu değil ve bu turda kurulmadı — yalnızca çözücüsüz aşamalar eklendi.
    - domain/materials.py: MaterialProperty'ye opsiyonel elastic_modulus (E, MPa,
    gt=0) ve poisson_ratio (ν, 0<ν<0.5) alanları eklendi. Kullanıcı girer, tablo
    gömülmez (K3/K6); boşsa FEA lab varsayım atamadan BLOCKED_CODE_DATA ile durur
    (K4). Mevcut hesapların hiçbiri bu alanları okumuyor — geriye dönük uyum tam.
    - fea/geometry_prep.py: 1/8 simetri modeli. Kapalı kabı desteklerden sabitlemek
    yapay gerilme ü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
2026-07-26 Faz 3: hayalet ozellikler kapatildi — mdmt ve supports hesap hattina baglandi
    Tur 4'un son bulgusu (koni MAWP'i hic cagrilmiyordu) bir soru birakmisti:
    baska ne cagrilmiyor? Envanter uc paket daha cikardi.
    mdmt, flanges, supports -> hesap hattinda SIFIR referans. Kasa ve
    limitations.md ucune de "OK Faz 5" diyordu. Yazilmis, testleri geciyor,
    hicbir sonuc uretmiyordu.
    BAGLANANLAR:
    - MDMT/UCS-66: DesignCode arayuzune check_mdmt eklendi, orkestrator cagiriyor.
    MaterialProperty'ye opsiyonel ucs66_curve_group (A/B/C/D) alani; egri grubu
    girilmemisse BLOCKED_MISSING_INPUT — tahmin edilmez (K4). Arayuze secici.
    - Destekler: yeni Support domain modeli + project.supports; DesignCode'a
    che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
2026-09-08 Faz 4 + TS/MMO kapsam denetimi: arayuz durustlugu, dis basinc/destek erisilebilir, UG-16(b)/UG-45/UG-46 kapatildi
    Faz 4 -- arayuz/gercek uyumu:
    - errors paneli render ediliyor; 10 sonuc grubunun tamaminda gerekceli
    emptyNote (bos grup artik sessizce kaybolmuyor)
    - pressure_consistency / material_check "On Kontroller" grubunda gosteriliyor
    - akiskan yogunlugu girilmeden statik kafa duzeltmesi atlandiginda artik
    add_assumption yaziyor (sessiz atlama yok)
    - sonuc satirlarina allowable_limit sutunu + kapaliyken uyari/varsayim rozeti
    - Tasarim Kosullari'na dis basinc/vakum/akiskan yogunlugu/darbe testi formu
    - Geometri'ye govde+bombe bazinda UG-28 A/B faktor alanlari (K6: kullanici
    girdisi,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
2026-09-24 Implement pressure vessel suite phases and validation
2026-09-24 chore: ajan öncesi geri dönüş noktası
    [deneme-tasarimi.stl, pressure_vessel_u_profile_legs_concept_mm.stl]
2026-10-06 orkestra: tur öncesi checkpoint (STEP import öncesi)
    [deneme-tasarimi.stl, pressure_vessel_u_profile_legs_concept_mm.stl]
2026-10-06 supervisor: M1 STEP içe aktarma kapandı — limitations B-34…B-37, kayıtlar
2026-10-07 fix: kampanya harness — tek kesitli tabanlar, tek ayak takımı, REVIEW kıyaslanır
2026-10-07 supervisor: M2 durum — Claude kotası doldu, devam Codex'te
2026-10-09 orkestra: W01 landing paketi
2026-10-09 landing: nav CTA kontrast düzeltmesi
2026-10-09 landing: APP_URL pv-suite-app.vercel.app
2026-10-09 Giriş şimdilik kapalı: AUTH_ENABLED=false, landing doğrudan uygulamaya
2026-10-10 domain: zeyslabs-vessela.com (landing) + app.zeyslabs-vessela.com (uygulama)
2026-10-17 orkestra: onarım paketlerine yol kuralı (proje kökü pressure-vessel-suite/)
2026-10-17 campaign: T04 nozul oran kuralı (≥1 PASS) ve satır durumu kontrollerden türetildi
2026-10-17 fix(report): kullanıcı kaynaklı metinler HTML'e kaçışlanarak yazılır (B-12)
    generator.py ve traceability.py'de html.escape; normal girdilerde çıktı değişmez.
    3 yeni test, tam paket 946 geçti, uçtan uca API doğrulaması yapıldı.
2026-10-28 feat(model): componentFrames, zincir aksiyonları, katalog adaptörü, nozul rating_class/coupling_form
2026-10-28 feat(cad): tarayıcı OCCT worker + gövde zinciri katıları
2026-10-28 feat(cad): WN/SO flanşlı nozul, dövme manşon, ped, manway katıları
2026-10-28 feat(cad): eyer/etek/ayak katıları, STEP/STL export, önizleme worker'a bağlandı
2026-10-28 fix(cad): bombe katıları geçerli ve duvarlı
2026-10-29 feat(cad): E01 dikey kap U-profil ayak — facing, ped taşma, başlangıç açısı
    - legs.ts: kesit yerel radyal=b, teğetsel=h; web/flanges aynası; iç yüz ped dış yüzüne temas
    (rs = R+padT+radyal/2), taban sacı alt = üst − height_mm, ankraj 1/2/4, sessiz kırpma yok
    - Support şeması: leg_channel_facing, leg_pad_top_extension_mm, leg_start_angle_deg (TS+Pydantic+store)
    - testler: kesişim≈0/temas, sac z, web/flanges kütle merkezi, start angle, ankraj
2026-10-29 feat(ui): Step 03 alt adım formlarının sadeleşmesi (U03)
    - Adım şeridi: tek satır 40px sekmeler, durum rozeti (✓ / ⚠n / ✕n)
    - stepIssueCounts (IssuesPanel): adım başına hata/uyarı, 0..4 anahtarları hep var, bilgi sayılmaz
    - Sorunlar: hata/uyarı yoksa gizli; varsa üstte daraltılmış satır, tıklayınca liste
    - Her alt adım: tek cümlelik giriş, "Ana ölçüler" (açık) + "Ayrıntılar" (kapalı) grupları
    - Uzun açıklamalar ? simgesinde (RField help), hesaplanan alanlar "hesaplanan" rozetiyle
    - Önceki/Sonraki: sabit alt çubuk, ortada "3.x / 5"
    - Mantık/hesap değişmedi; yalnız sunum. Test: stepIssueCounts (4)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
2026-10-29 fix(ui): U02 tur 2 (tek CAD derlemesi, sayfa gezinmesi başlıkta, otomatik sığdırma)
2026-10-29 fix(ui): kamera sığdırmanın tek sahibi CameraRig; Bounds kaldırıldı, hook sırası düzeltildi
2026-10-30 chore(deploy): .vercelignore — .env ve Dockerfile yüklenmez
2026-10-30 docs(deploy): CAD notu tarayıcı, link uyarısı
2026-10-30 feat(rapor): A4 baskı CSS, PDF indir (iframe print) ve U-1A biçiminde özet sayfa
2026-10-30 feat(bom): P09 malzeme listesi + maliyet tahmini (BOM kartı, CSV)
2026-10-30 feat(nozzles): P07 WRC 537/297 nozul dış yükü altyapısı
    - domain/nozzle_loads.py: nozul başına Fr/Vc/VL/Mc/ML/Mt + kullanıcı eğri okumaları;
    VesselProject.nozzle_loads (tek opsiyonel alan)
    - nozzles/nozzle_loads.py: γ, β=0,875·r0/Rm, WRC 107 normalizasyonu (moment β'lı),
    A/B/C/D × iç/dış bindirme, τ (Mt, Vc, VL), Tresca/von Mises,
    Pm ≤ S, PL ≤ 1,5S, PL+Pb+Q ≤ 3S; pedde iki konum; d/D ≤ 0,33 kapısı
    - nozzles/wrc_curves.py: eğri arama (bilineer, kırpma yok) — tablolar BOŞ (K6) → BLOCKED
    - WRC 297: geometri + kapı; normalizasyon doğrulanmadı → her zaman BLOCKED_CODE_DATA
    - design_code.check_nozzle_clashes içinde tek P07 çağrı bloğu; UI gird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
2026-10-30 feat(bom): profil ayak kütlesi sections.py kesit alanından; eyer notu netleştirildi
2026-10-30 fix(supports): F1 WRC ayak moment normalizasyonuna eğri beta'sı (N=K·M/(Rm²β), M=K·M/(Rmβ))
    Ayak/ped ML ve MC katsayıları için beta kullanıcı girdisi (wrc_beta_ML/MC);
    moment aktifken beta yoksa BLOCKED_MISSING_INPUT, çekirdekte ValueError.
    Eşdeğer beta formülü koda gömülmedi (K6).
2026-10-30 feat(bom): F3 eyer plaka alanlari + BOM kutlesi (web/taban/kanat/asinma)
2026-10-30 feat(fea): P12 eksenel simetrik FEM cekirdegi (Q8 + bant Cholesky, worker)
    - fea/types.ts sozlesme (+ lines/junctions/componentKind ekleri), mesh.ts yapilandirilmis Q8 agi
    (korozyonlu kalinlik, kose kolonlari, sureksizlik siklastirma, kutup nozulu), solver.ts,
    sampleScl.ts, toStressField.ts, fea.worker.ts, useFea.ts
    - Dogrulama: Lame, ince silindir/kure membran, birlesim vs analitik, ag yakinsamasi, koni, CA
2026-11-05 feat(nozzle): açıklık kaynak verimi E1 (UG-37(a)) domain->design_code->UI bağlantısı (T-2.14)
2026-11-05 test(cad): destek katıları testine 30 s zaman aşımı (paralel koşuda flaky)
2026-11-05 wip(e2e): X01 yarım — durduruldu (Sonnet, Playwright kuruldu, akış ayarlanıyordu)
2026-11-05 docs(supervisor): D5 Dalga A duraklatıldı — durum notu
2026-11-06 fix(en13445): hidrotest_component acik NOT_CALCULATED satiri + inspection_opening/nozzle_load UI baglantisi (main yesil)
2026-11-06 test(e2e): X01 Playwright akisi - Hesapla/Yeniden Hesapla tetigi, probe silindi, gitignore
2026-11-06 feat(en13445): E04 Madde 6 f_d/f_test, test grubu->z (5.6), EN-5 hidro (fa/fT, Pd) + pnomatik test, EN tahliye satiri; madde no 7.4.2/7.5.2/7.5.4 (verified=False)
    - nominal_design_stress satiri (ferritic/austenitic_a30/a35/cast); grup/ozellik yoksa BLOCKED_MISSING_INPUT, f > f_d FAIL
    - WeldJoint.en_testing_group: z hesaplarda tablo sinirina indirilir; validate_welds gercek satir
    - hidrotest Pt = max(1.25*Pd*fa/fT ; 1.43*PS); pnomatik Pt = k*Pd*fa/fT (k kullanici, yoksa BLOCKED_CODE_DATA)
    - EN check_pressure_relief override: ASME UG-125 hesabi EN adi altinda sunulmaz
    - elipsoidal: kure denklemi 7.5.4 proseduru degil -> REVIEW_REQUIRED + uyari
    - clause_mappings: yeni kimlikler, eski EN-5.x tak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
2026-11-06 docs(supervisor): E06 bitti — durum notu
2026-11-06 docs(supervisor): durduruldu — E05 yazmadan kesildi, canlıya alma bekliyor
2026-11-06 docs(supervisor): main canliya alindi (E06 dahil) — dogrulama notu
