cakmacbum/bas-ncl-kap/(notices)

Notices in the files:
pressure-vessel-suite/docs/validation/campaign-2026-10/sources-K3.md:
Kaynak: CRC Press, "Chapter ten: Design of vessel supports" (c) 2005 CRC Press; dosyada kitap/yazar adı yok, bölüm kaynakçası Widera–Sang–Natarajan 1988 ve Zick'e atıf yapıyor · URL: https://files.engineering.com/download.aspx?folder=4910f459-dcc5-40f9-93b9-143dbd09ceff&file=Chap10-Support_Design.pd
